wgbowley/OpenLSM/04_fixtures/readme.md

### 04_fixtures

#### [00_potting](./00_potting/) - Motor Potting

*(TBD) - Work in progress*

---

#### [01_validation_setup](./01_validation_setup/) - Validation / Experimental apparatus

*(TBD) - Work in progress*

<div align="center">
  Test-stand
</div>

---
