wgbowley/OpenLSM/03_boards/readme.md

### 03_boards

#### [01_armature_board](./01_armature_board) — Sensor Board (Manufacturing)

<div align="center">
  <table>
    <tr>
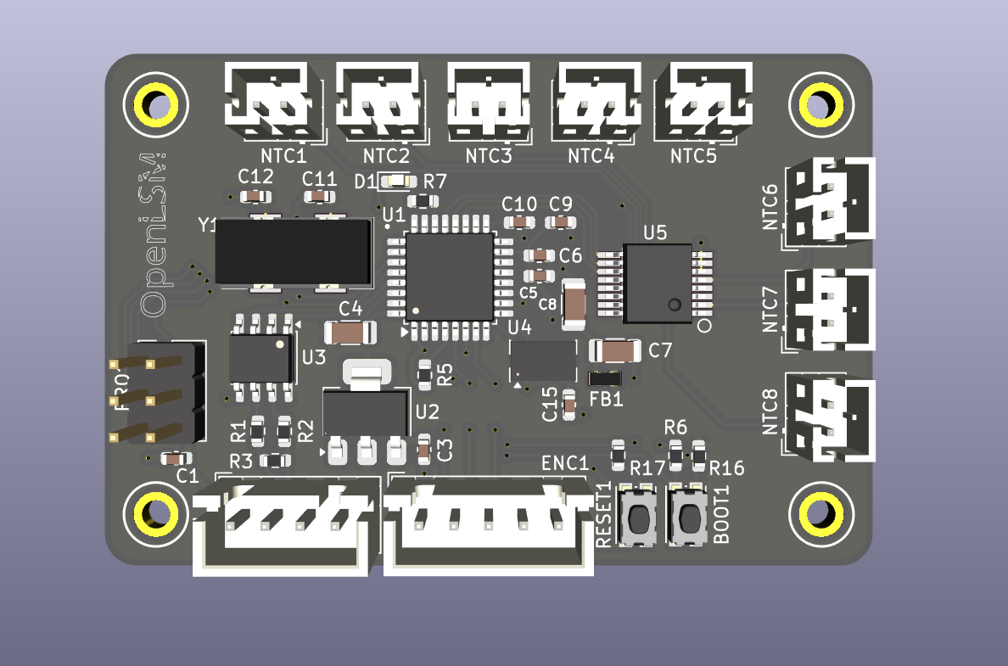
[picture p6: 03_boards/01_armature_board/05_media/kicad_top_layer.png]
Top layer
      <td></td>
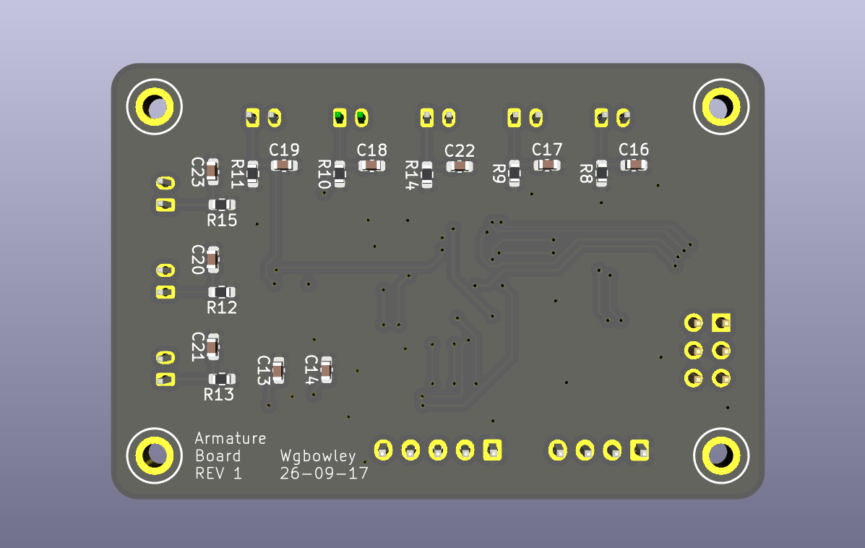
[picture p7: 03_boards/01_armature_board/05_media/kicad_bottom_layer.png]
Bottom layer
      <td></td>
    </tr>
    <tr>
      <td><em>Top layer — STM32, thermistor array, accelerometer & encoder</em></td>
      <td><em>Bottom layer — base resistors & decoupling capacitors for thermistors</em></td>
    </tr>
  </table>
</div>

A sensor board that connects to the driver over `RS-485/RS-422`. 
It features `8` NTC thermistors switched via an analog multiplexer to produce a thermal profile `T(z, t)`. 
The board also includes a `3-axis SPI accelerometer` and processes data from the encoder board.

---

#### [02_magnetic_encoder](./02_magnetic_encoder) — Linear Encoder Breakout (Validation)

<div align="center">
  <table>
    <tr>
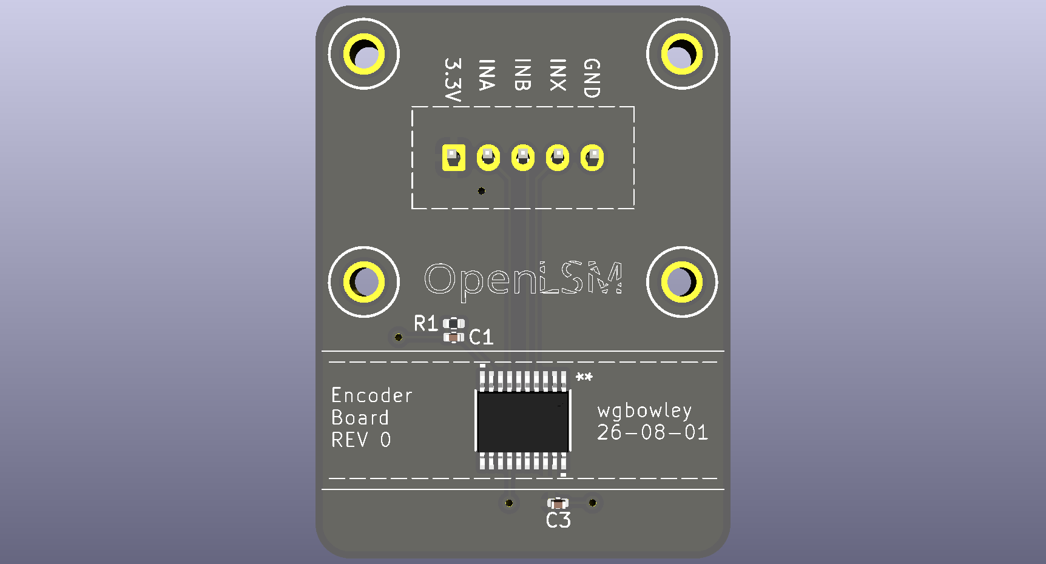
[picture p8: 03_boards/02_magnetic_encoder/05_media/kicad_top_layer.png]
Top layer
      <td></td>
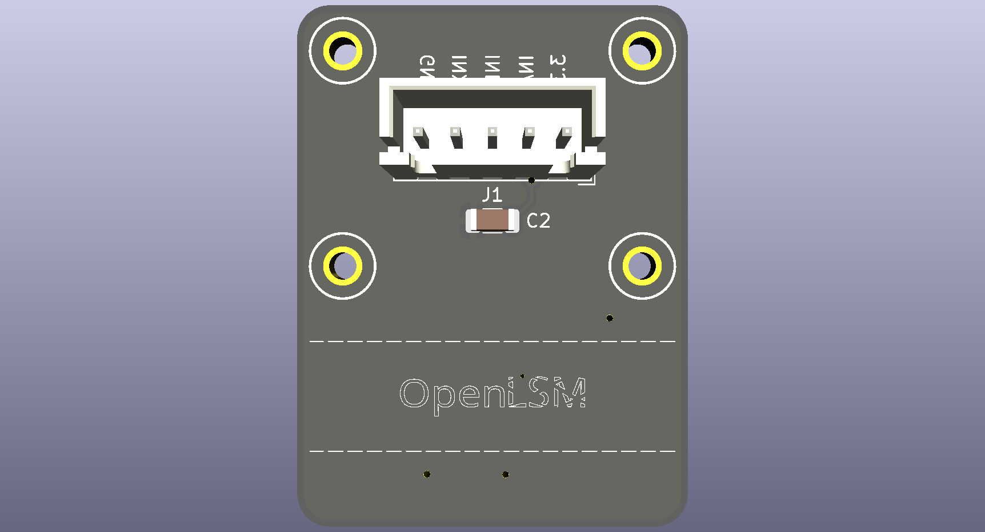
[picture p9: 03_boards/02_magnetic_encoder/05_media/kicad_bottom_layer.png]
Bottom layer
      <td></td>
    </tr>
    <tr>
      <td><em>Top layer — facing the magnetic scale</em></td>
      <td><em>Bottom layer — JST XH 5-pin & mounting side</em></td>
    </tr>
  </table>
</div>

A breakout and mechanical interface for the `AS5311` linear encoder, providing a resolution of `1.95 µm` and an estimated accuracy of `10–20 µm`, 
depending on mechanical implementation factors. The encoder operates from `0–600 mm/s` and is an incremental `A`, `B`, `Index` type.

---

#### [03_teensy_SFOC](./03_teensy_SFOC) - Teensy 4.1 & SimpleFOC Breakout Board (Manufacturing)

<div align="center">
  <table>
    <tr>
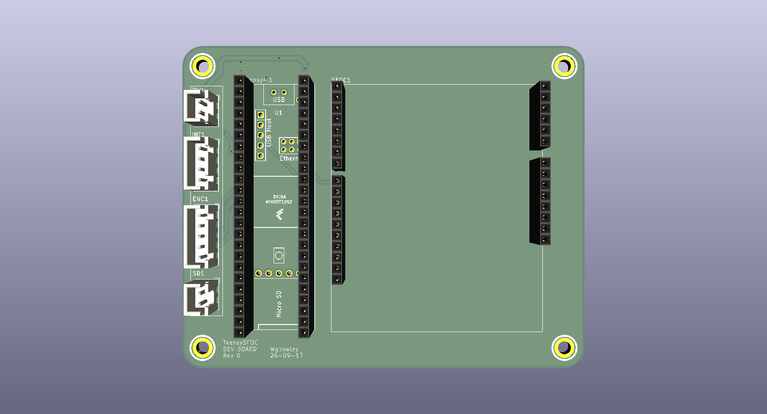
[picture p10: 03_boards/03_teensy_SFOC/05_media/kicad_top_layer.png]
Top layer
      <td></td>
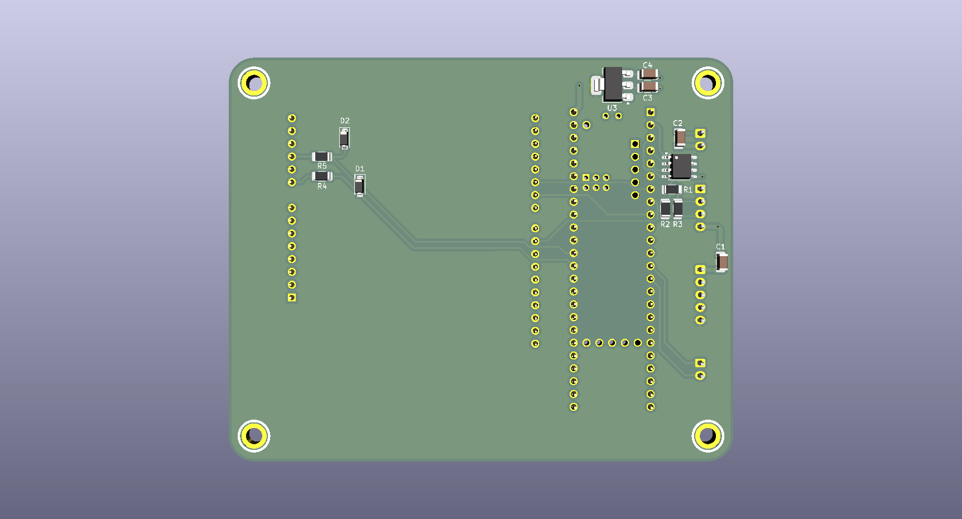
[picture p11: 03_boards/03_teensy_SFOC/05_media/kicad_bottom_layer.png]
Bottom layer
      <td></td>
    </tr>
    <tr>
      <td><em>Top layer — Teensy & SimpleFOC shield</em></td>
      <td><em>Bottom layer — Supporting electronics</em></td>
    </tr>
  </table>
</div>

The Teensy SFOC board is a breakout board for the Teensy 4.1 and SimpleFOC Arduino shield with `step/dir` input.

--- 

#### [00_bridge_driver](./00_bridge_driver) — Triple Half-Bridge Driver (WIP)

An isolated triple half-bridge driver with an MCU-side domain of `24 V (DC)` and a power domain of `12-96 V (RMS)`, 
with current up to `20 A (RMS)`. It supports `step/dir` and `CANBUS` input interfaces and uses `RS-485/RS-422` for 
communication with external input boards for encoders, Hall-effect sensors, etc. 

---
