wgbowley/OpenLSM/04_fixture/readme.md

### 04_fixture

*(TBD) — Work in progress*

---

#### [00_potting](./00_potting/) — Motor Potting

*(TBD) — Work in progress*

---

#### [01_validation_setup](./01_validation_setup/) — Validation / experimental apparatus

<div align="center">
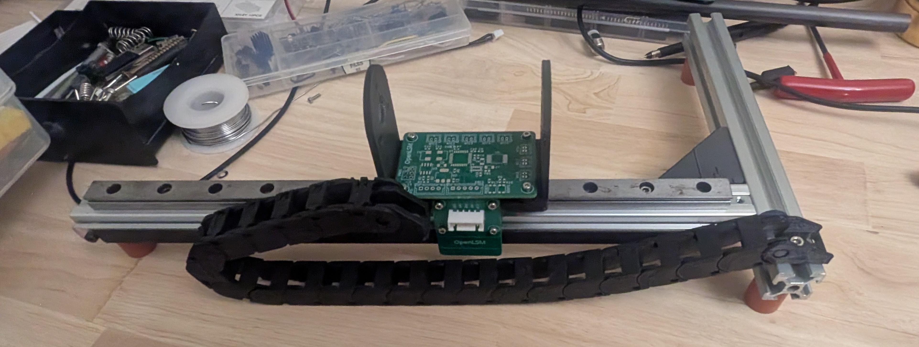
[picture p12: 05_media/04_fixtures/01_validation_setup/initial-integration.jpg]
Test-stand
  
</div>

*(TBD) — Work in progress*

---
