wgbowley/OpenLSM/03_boards/02_teensy_SFOC/readme.md

#### Overview

<div align="center">
  <table>
    <tr>
      <td>Top layer</td>
      <td>Bottom layer</td>
    </tr>
    <tr>
      <td><em>Top layer - Teensy & SimpleFOC shield</em></td>
      <td><em>Bottom layer - Supporting electronics</em></td>
    </tr>
  </table>
</div>

The Teensy SFOC board is a breakout board for the Teensy 4.1 and SimpleFOC Arduino shield, with `RS-485/RS-422` support and 
a secondary encoder input if `RS-485` to the armature board cannot be used. It also has a `step/dir` input for use with 
standard 3D printer main-boards.

> *(Note). This is a prototyping/dev board. It is not meant to be used long-term.*

---

### Documentation

> BOM can be found here [`BOM.md`](BOM.md)

Design notes and implementation decisions are documented in [`issue #42`](https://github.com/wgbowley/OpenLSM/issues/42).

---
