wgbowley/OpenLSM/02_motors/01_prototype_beta/rev_3/readme.md

### Overview

> It has not been manufactured, experimentally validated, or verified for performance.
> Do not assume the design is suitable for fabrication without further analysis.

This is Prototype Beta, Revision 3, which is intended to be built and validated using the boards designed
alongside it. This prototype is intended to serve to prove the thermal analysis studies before it (Rev 1 and Rev 2).

This prototype will most likely use an outer radial heat sink made of `aluminum`, with coils potted into that
heat sink and the final inner bore hole being machined out.

---

### Documentation

Reference: [`Defining constraints and success metrics for prototype beta rev 3`](https://github.com/wgbowley/OpenLSM/issues/5)

---
