wgbowley/OpenLSM/00_docs/credits.md

### Credits

#### Research & Development Enabled by:
- [Lawson Gallup](https://github.com/LawsonDG) - Thank you for the initial idea behind making a linear motor for 3D printers and your continued support.
- [SimpleFOC](https://simplefoc.com/) - Thank you to the SimpleFOC team for developing such a wonderful driver, specifically Runger, for the encoder help.

#### Prior Research & Inspiration
- [Scipython & Christian Hill](https://scipython.com/) - Annulus heat sink example using a modified bessel function.
- [Matthew Sorensen](https://sorens.in) - Research into the usage of the AS5311 for 3D printers.
- [cmore839](https://github.com/cmore839) - Research into tubular linear motors and the very informative Discord server.

#### Tooling Acknowledgements
- [PicoUnits](https://github.com/Bowley-Systems/PicoUnits)
- [UnitValues](https://github.com/Bowley-Systems/UnitValues)
- [Fusion 360](https://www.autodesk.com/products/fusion-360)
- [KiCad](https://github.com/KiCad)

---
