wgbowley/OpenLSM/00_docs/readme.md

### 00_docs

A credits list for tooling and individuals can be found here: [`credits.md`](./credits.md)

#### Contributors

Documentation for tooling used in the development of `OpenLSM` can be found here: [`CONTRIBUTORS.md`](./CONTRIBUTORS.md)

---

### Internal Resources

All internal documentation can be found within this repo's [`issues`](https://github.com/wgbowley/OpenLSM/issues).

#### Tags:

```
Project Progress:
----------------------------------------------------
LX -> Documentation and project structure
L0 -> Review and analysis of reference designs
L1 -> System level design, topology and interfaces
L2 -> Detailed design & prototyping
L3 -> Testing & validation of prototype
----------------------------------------------------
```

<br>

```
Miscellaneous:
----------------------------------------------------
DS  -> De-scoped feature, de-scoped analysis
AC  -> Architectural change
ES  -> Electrical systems
SD  -> System development / Architectural development
SIM -> Simulations & modelling
AN  -> Weekly application notes
----------------------------------------------------
```

#### Application Notes

```
0x1 = Week 1
0x2 = Week 2
0x3 = Week 3
0x4 = Week 4
0x5 = Week 5
0x6 = Week 6
0x7 = Week 7
0x8 = Week 8
0x9 = Week 9
0xA = Week 10
0xB = Week 11   
0xC = Week 12
0xD = Week 13
0xE = Week 14   <- Current State
0xF = Week 15   <- Terminal State
```

> Check [`here`](https://github.com/wgbowley/OpenLSM/issues?q=is%3Aissue%20label%3AAN) to view the weekly application notes.

---
