wgbowley/OpenLSM/01_simulation/01_hybrid/readme.md

### 01_mix_solution

*(TBD) — Work in progress*

> Do not assume the resulting design variables are suitable for fabrication or real-world use without further analysis.

---

### Mathematical Implementation
*(TBD) — Work in progress*

---

### Computational Implementation
*(TBD) — Work in progress*

---

### Model Validation
*(TBD) — Work in progress*

---

### Documentation

Reference: [`Build a reduced order model for tubular linear synchronous motors`](https://github.com/wgbowley/OpenLSM/issues/7)<br>
Reduced Order Modelling tool: [`ifemm`](https://github.com/wgbowley/iFEMM)

---
