wgbowley/OpenLSM/02_motors/01_prototype_beta/rev_3/02_detailed_design/00_magnetic_search/01_run_300um_wire_6_slots/trace.csv

Iteration | step_size (m) | Axial Length (m) | Radial Thickness (m) | Absolute Force (N) | Force per Ampere (N/A) | Force slew rate (N/s) | Copper Loss (W) | Normalized Score
0 | 0.0015 | 0.0031386694733534256 | 0.004339691260599416 | 12.279448708577325 | 2.921504470982113 | 82422.61408032292 | 173.74766222075564 | -5.713602476207521
4 | 0.0015 | 0.0029586609645756317 | 0.005315846270833498 | 15.193571835821237 | 4.466436942260786 | 59165.65756771232 | 139.05423621348748 | -4.1011602443293125
5 | 0.0015 | 0.0031646001191442037 | 0.005453661729053428 | 15.45968901656606 | 5.034182417412318 | 56337.17448141091 | 125.22852624422066 | -3.4209078403457984
8 | 0.0015 | 0.0020134186450666046 | 0.00566582707880046 | 16.363737141967125 | 3.5656969173057034 | 54192.27013770524 | 186.36724351262515 | -6.47928649477025
9 | 0.0015 | 0.002843345400056729 | 0.005836235768687598 | 16.462998709250023 | 5.323586764631645 | 50222.93783381328 | 125.0476007834111 | -3.424168519414899
11 | 0.0015 | 0.0021361572980415737 | 0.004629515371620264 | 13.48283631367632 | 2.366350253332019 | 76193.7302292795 | 234.9875003519359 | -8.798338439865837
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
