wgbowley/OpenLSM/02_motors/01_prototype_beta/rev_3/02_detailed_design/00_magnetic_search/02_run_200um_wire_6_slots/trace.csv

Iteration | step_size (m) | Axial Length (m) | Radial Thickness (m) | Absolute Force (N) | Force per Ampere (N/A) | Force slew rate (N/s) | Copper Loss (W) | Normalized Score
1 | 0.0015 | 0.002219240695167407 | 0.004828848955807065 | 6.2531203189048465 | 6.140439610919466 | 31360.590046137986 | 41.90883660349558 | -0.6382366769975523
2 | 0.0015 | 0.0015881907651128999 | 0.004583356854705778 | 5.977535938588337 | 3.930790857870361 | 34419.67295836757 | 62.73530631533942 | -1.7195919008117742
3 | 0.0015 | 0.003137620603877833 | 0.0043852653479235035 | 5.5222985762548324 | 6.771007821967774 | 35862.50697063138 | 33.70129491684939 | -0.1898844880720998
5 | 0.0015 | 0.0023031508561898242 | 0.004406781077995912 | 5.658670740159545 | 5.13155288698707 | 36218.70127947442 | 45.55843929250885 | -0.8166291021204308
7 | 0.0015 | 0.002600828388159864 | 0.004425219110757882 | 5.650894948680679 | 5.811638187960793 | 35799.93893520866 | 40.16670843960899 | -0.533525875476182
11 | 0.0015 | 0.002315026460310334 | 0.004849306284403274 | 6.268549361640366 | 6.47523608357132 | 31002.29382706246 | 39.82859048696162 | -0.5286875088570846
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
