wgbowley/OpenLSM/02_motors/01_prototype_beta/rev_3/02_detailed_design/00_magnetic_search/03_run_400um_wire_12_slots/trace.csv

Iteration | step_size (m) | Axial Length (m) | Radial Thickness (m) | Absolute Force (N) | Force per Ampere (N/A) | Force slew rate (N/s) | Copper Loss (W) | Normalized Score
0 | 0.0015 | 0.0027066464489963337 | 0.005597720254361694 | 28.412157144821997 | 5.19802720574761 | 96712.0610186584 | 222.25473483913382 | -7.1311328437629875
1 | 0.0015 | 0.0016054447689461198 | 0.005822669286339892 | 29.890297909216724 | 3.4442478392607776 | 91670.6567169225 | 351.0241194196191 | -13.530661351581365
2 | 0.0015 | 0.002102926336043487 | 0.005942902954008838 | 30.12809908379458 | 4.6482959624315425 | 88351.49194772764 | 261.4762498984186 | -9.022544468316477
3 | 0.0015 | 0.0028193282309151553 | 0.00589134261064581 | 29.496030854877752 | 6.044217179447239 | 88160.28801468521 | 197.09626434166688 | -5.822133345467142
4 | 0.0015 | 0.002310413343650763 | 0.005080169659342831 | 26.263215684669444 | 3.5824336629144895 | 115365.56806514875 | 300.77106223699633 | -11.139161407300902
6 | 0.0015 | 0.0015163710564300638 | 0.00720902975458605 | 33.59241112921587 | 5.049076421782576 | 62194.618361743305 | 255.58530749332536 | -8.629775530734495
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
