wgbowley/OpenLSM/02_motors/01_prototype_beta/rev_3/02_detailed_design/00_magnetic_search/07_run_400um_wire_18_slots/trace.csv

Iteration | step_size (m) | Axial Length (m) | Radial Thickness (m) | Absolute Force (N) | Force per Ampere (N/A) | Force slew rate (N/s) | Copper Loss (W) | Normalized Score
0 | 0.0015 | 0.0015036831160120884 | 0.004359672048773853 | 22.64909464271964 | 2.4459310826022667 | 151282.3109376802 | 382.7623766286552 | -15.278855221697253
1 | 0.0015 | 0.0007809768122156805 | 0.004288566379278116 | 22.384800746793154 | 1.2028992598587602 | 159734.36826091498 | 769.7530205367551 | -34.611730627553996
2 | 0.0015 | 8.160852887947249e-05 | 0.004768727497911051 | 25.231457899317995 | 0.15531985040937726 | 141187.99274804033 | 6698.677200496042 | -330.99365697904295
3 | 0.0015 | 0.0005903491674868071 | 0.005064626182989945 | 26.753721790297096 | 1.34486419082708 | 122504.73710565863 | 817.0196075048677 | -36.905732018796186
4 | 0.0015 | 0.0018857544071902855 | 0.004967832817291968 | 25.884587750735342 | 4.204583104583407 | 120383.70225347692 | 252.93424306084617 | -8.714263585281225
5 | 0.0015 | 0.001982684185024087 | 0.005148388706729897 | 26.76221505403833 | 4.738755209338354 | 114524.75197739914 | 231.5333879184183 | -7.597241863765145
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
