wgbowley/OpenLSM/02_motors/01_prototype_beta/rev_3/02_detailed_design/00_magnetic_search/09_run_18_slots/trace.csv

Iteration | step_size (m) | Wire diameter (m) | Radial Thickness (m) | Absolute Force (N) | Force per Ampere (N/A) | Force slew rate (N/s) | Copper Loss (W) | Normalized Score
0 | 0.0015 | 0.000429250335309005 | 0.004843479786120419 | 27.92792697357624 | 7.952657560526482 | 103837.51093504643 | 143.31523132972404 | -1.449242028001673
1 | 0.0015 | 0.0004203299797048553 | 0.005828795390446022 | 31.182176625814265 | 12.76953706664972 | 71754.61169006242 | 96.59350797141627 | -0.7428830629364371
2 | 0.0015 | 0.0002869858357668495 | 0.004810272410225731 | 12.396310414169388 | 17.634265464122855 | 46603.429257564414 | 28.69984710863167 | 0.23642877284624042
3 | 0.0015 | 0.00034907689680906053 | 0.003532516952822636 | 12.832690156290374 | 5.570865606183752 | 112040.17070140073 | 95.44138953654756 | -0.5904633620767432
4 | 0.0015 | 0.0002809134079046521 | 0.005207447723484311 | 12.782976642058106 | 22.17281796488547 | 39025.03927797235 | 23.313094606590553 | 0.3289784916295618
5 | 0.0015 | 0.0003955063154559475 | 0.004460929036169256 | 21.780965037025883 | 7.710944028757729 | 100689.17608157013 | 116.0369846086831 | -0.9996514806282302
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
