wgbowley/OpenLSM/02_motors/01_prototype_beta/rev_3/02_detailed_design/00_magnetic_search/01_run_300um_wire_6_slots/tradeoffs.png

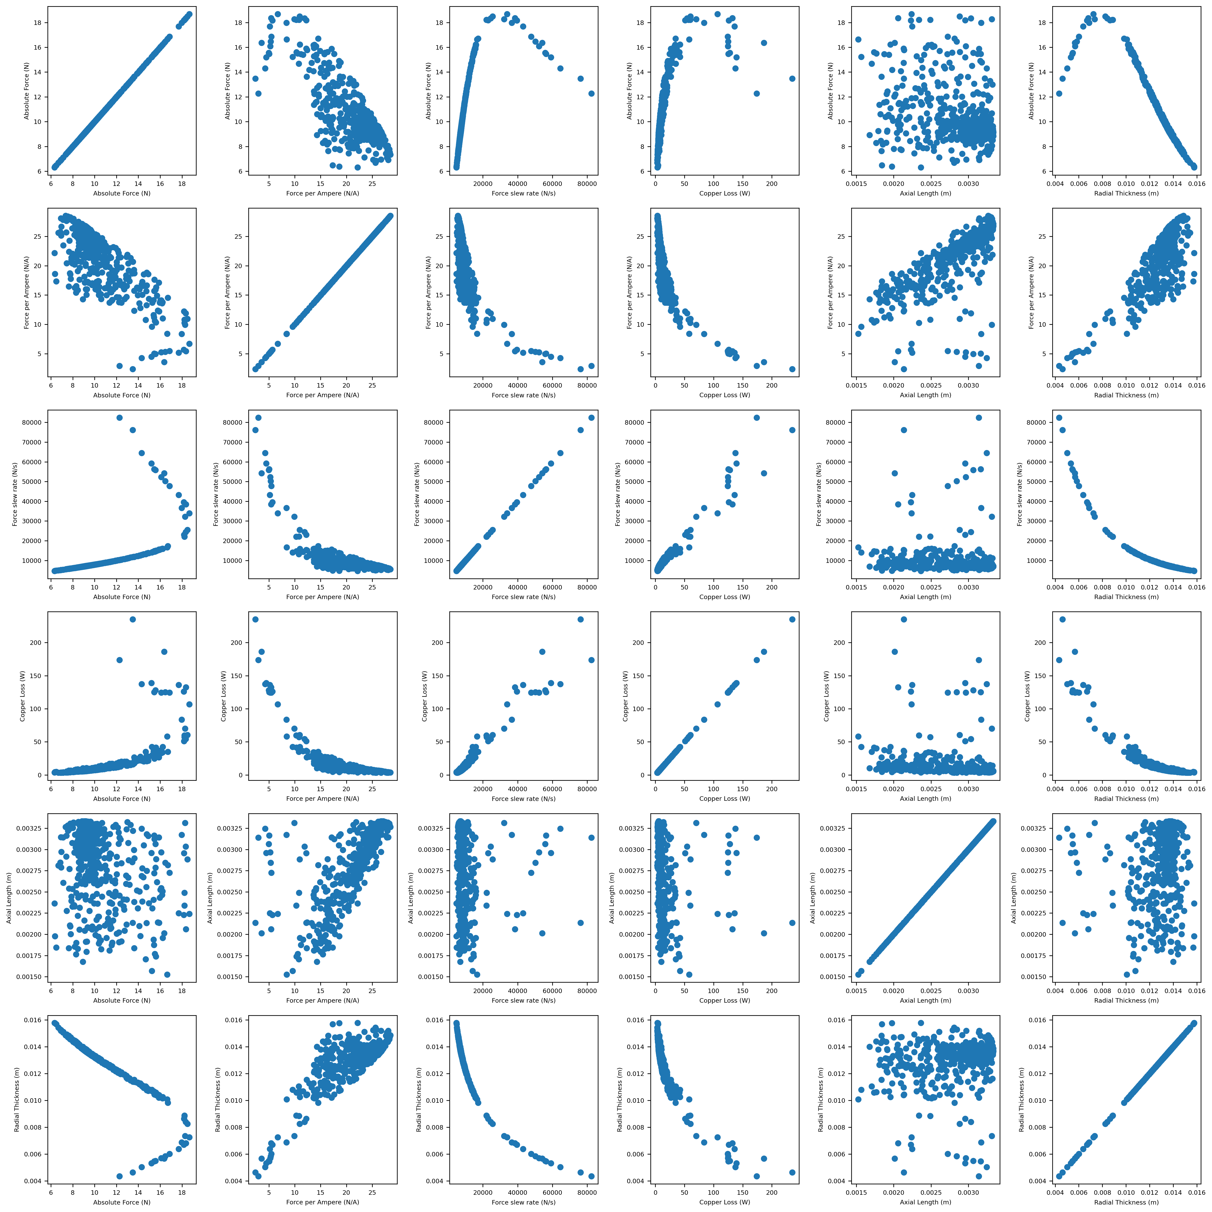
02_motors/01_prototype_beta/rev_3/02_detailed_design/00_magnetic_search/01_run_300um_wire_6_slots/tradeoffs.png
