wgbowley/OpenLSM/02_motors/01_prototype_beta/rev_3/02_detailed_design/00_magnetic_search/06_run_500um_wire_12_slots/tradeoffs.png

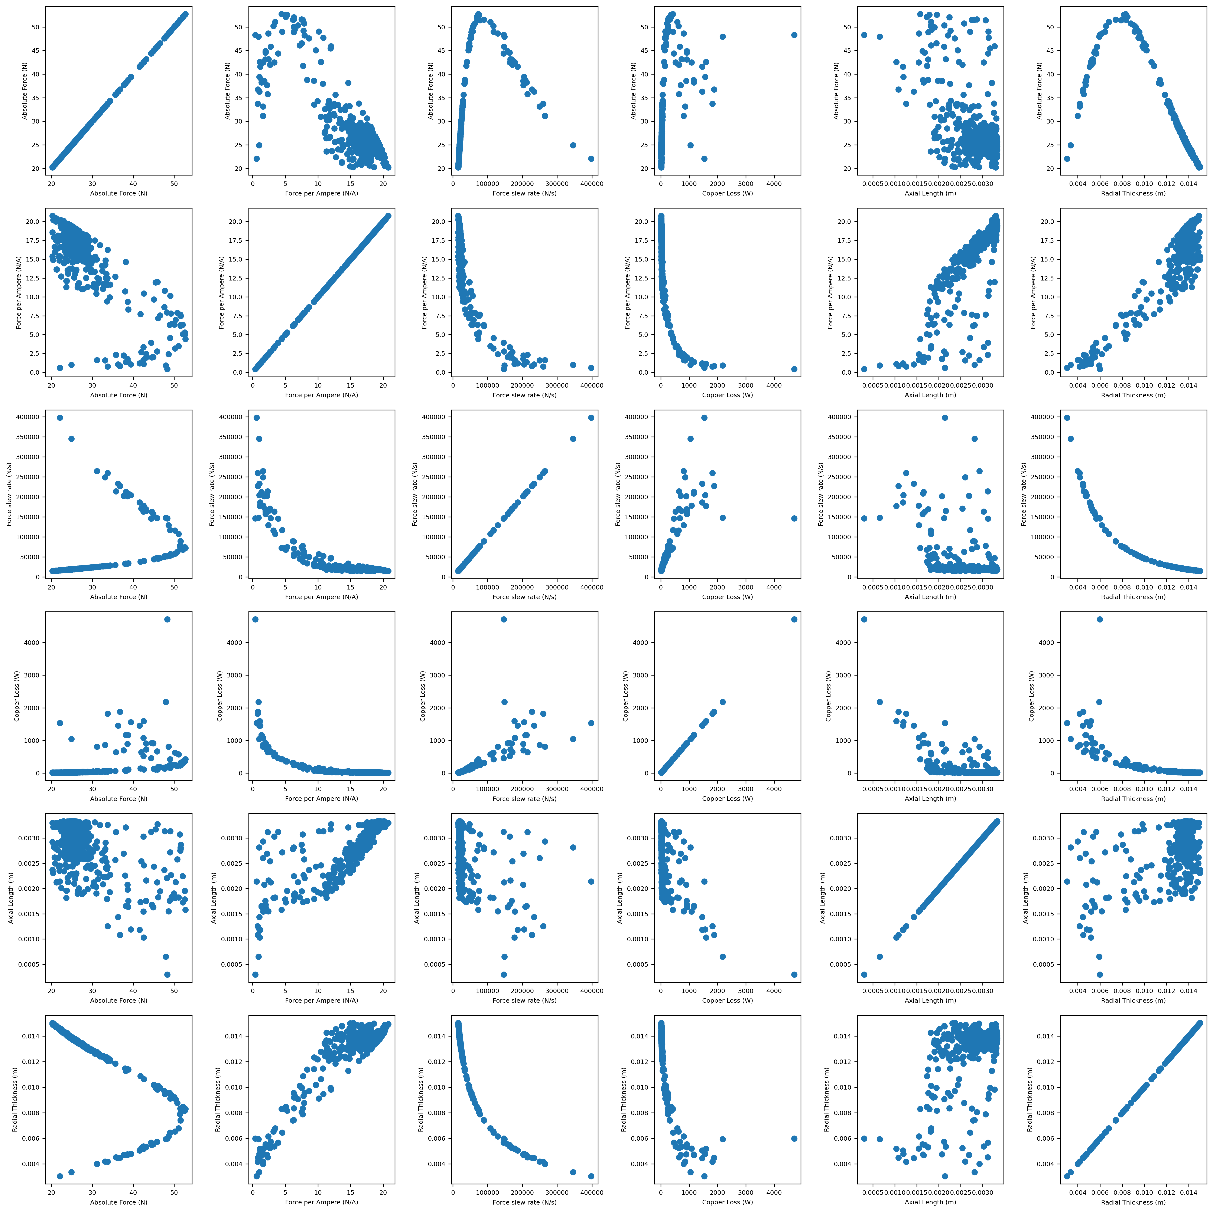
02_motors/01_prototype_beta/rev_3/02_detailed_design/00_magnetic_search/06_run_500um_wire_12_slots/tradeoffs.png
