wgbowley/OpenLSM/02_motors/01_prototype_beta/rev_3/02_detailed_design/00_magnetic_search/07_run_400um_wire_18_slots/tradeoffs.png

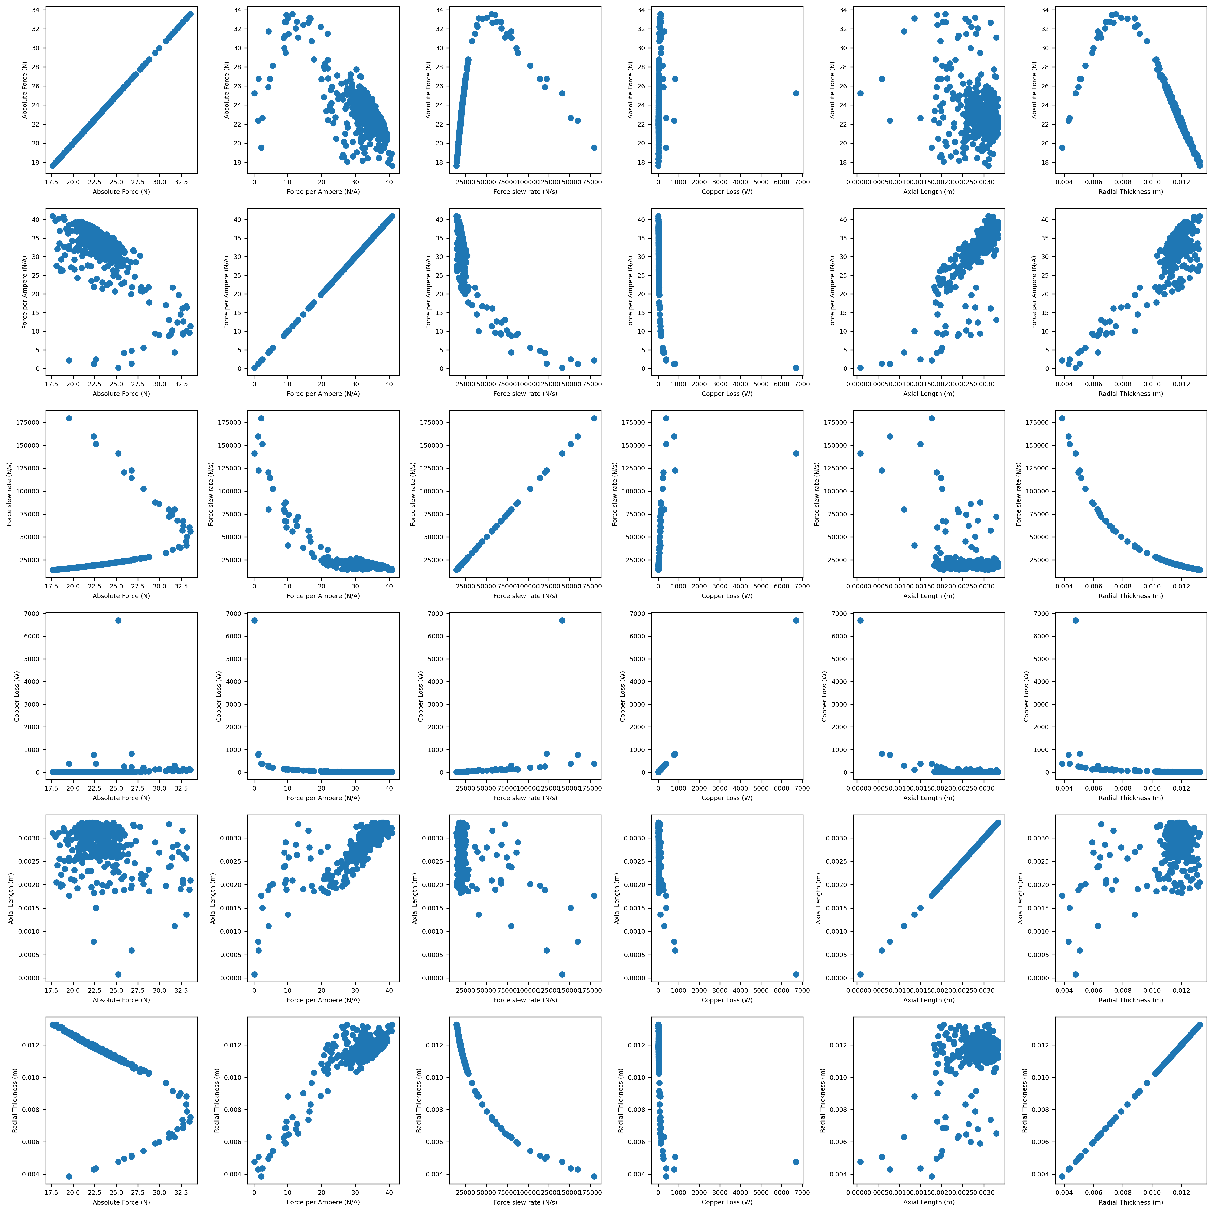
02_motors/01_prototype_beta/rev_3/02_detailed_design/00_magnetic_search/07_run_400um_wire_18_slots/tradeoffs.png
