wgbowley/OpenLSM/03_boards/02_magnetic_encoder/05_media/bare_pcb_back.jpg

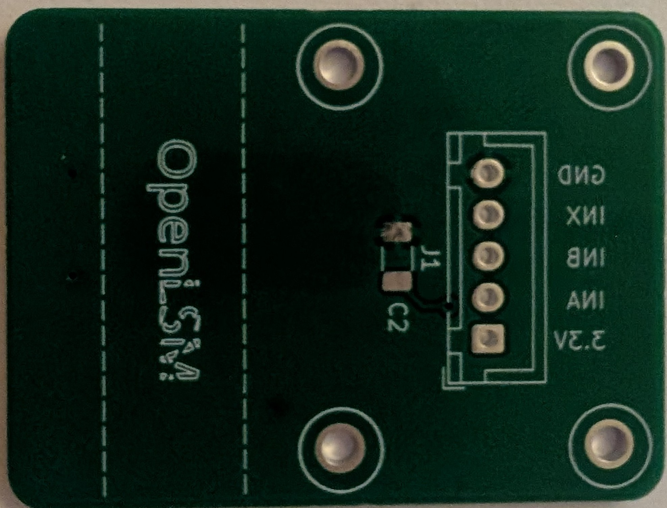
03_boards/02_magnetic_encoder/05_media/bare_pcb_back.jpg
