wgbowley/OpenLSM/03_boards/02_magnetic_encoder/05_media/bare_pcb_top.jpg

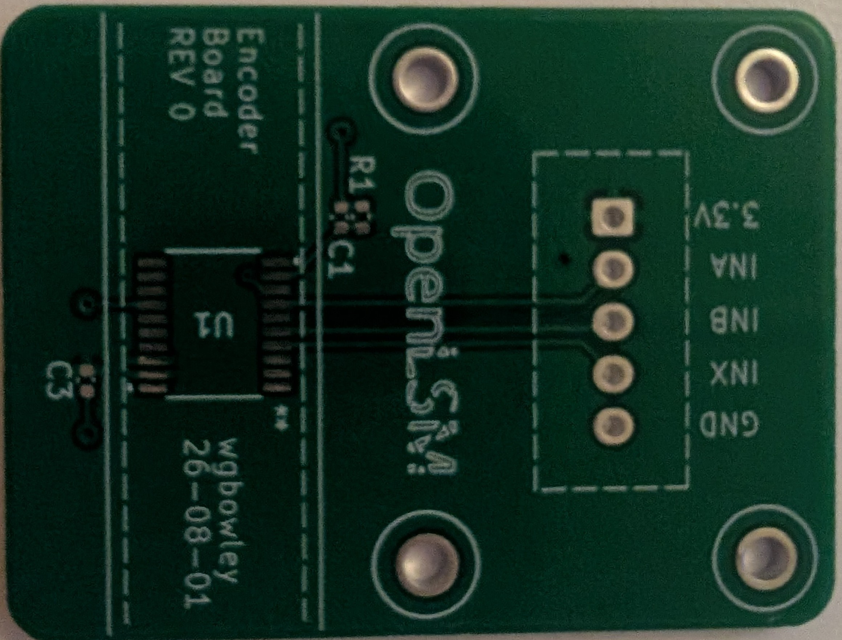
03_boards/02_magnetic_encoder/05_media/bare_pcb_top.jpg
