wgbowley/OpenLSM/03_boards/03_teensy_SFOC/00_references/simplefoc_driver_board.jpg

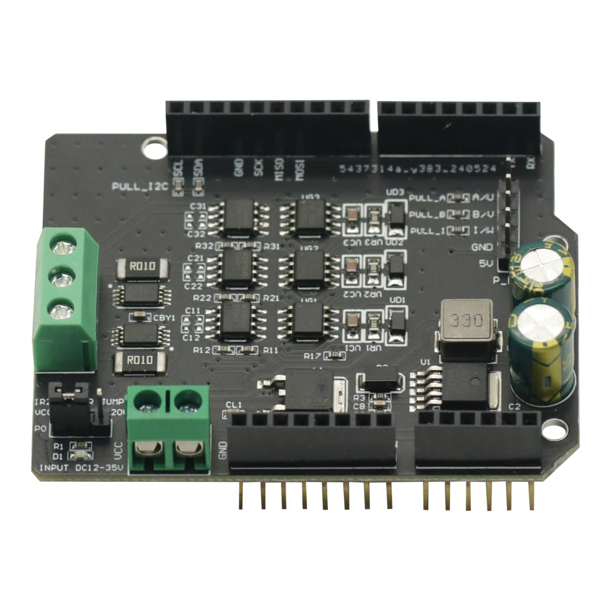
03_boards/03_teensy_SFOC/00_references/simplefoc_driver_board.jpg
