wgbowley/OpenLSM/03_boards/03_teensy_SFOC/00_references/teensy4_1_pinout.jpg

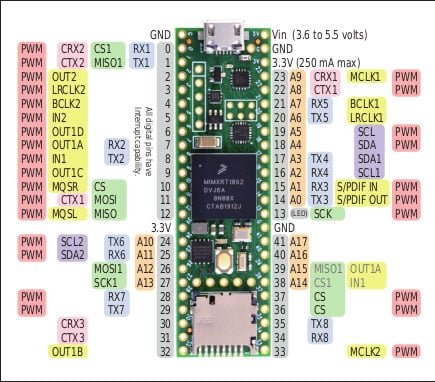
03_boards/03_teensy_SFOC/00_references/teensy4_1_pinout.jpg
