wgbowley/OpenLSM/03_boards/03_teensy_SFOC/05_media/top-side.jpg

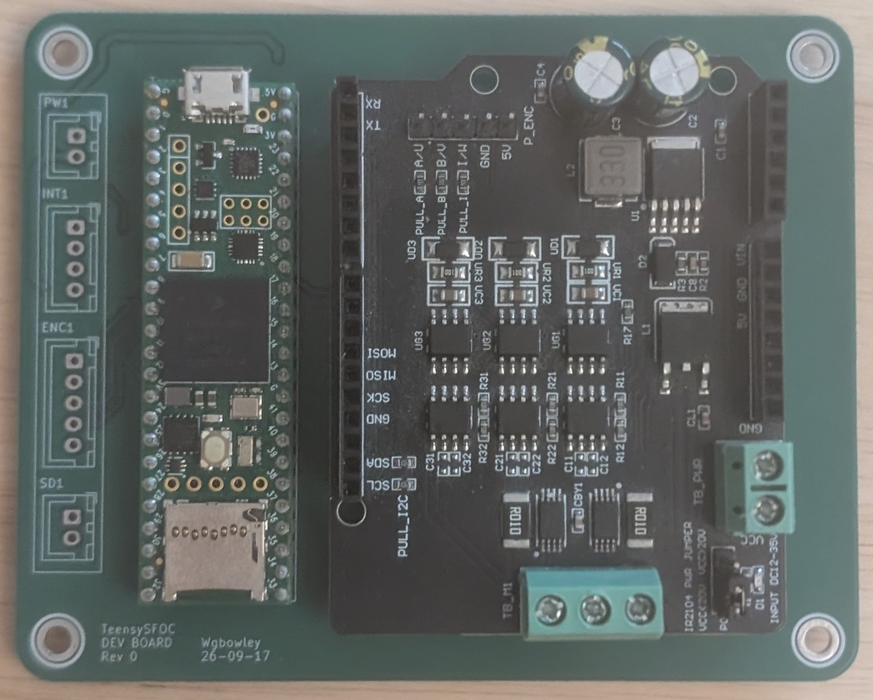
03_boards/03_teensy_SFOC/05_media/top-side.jpg
