wgbowley/OpenLSM/05_media/00_simulation/00_analytical/example.png

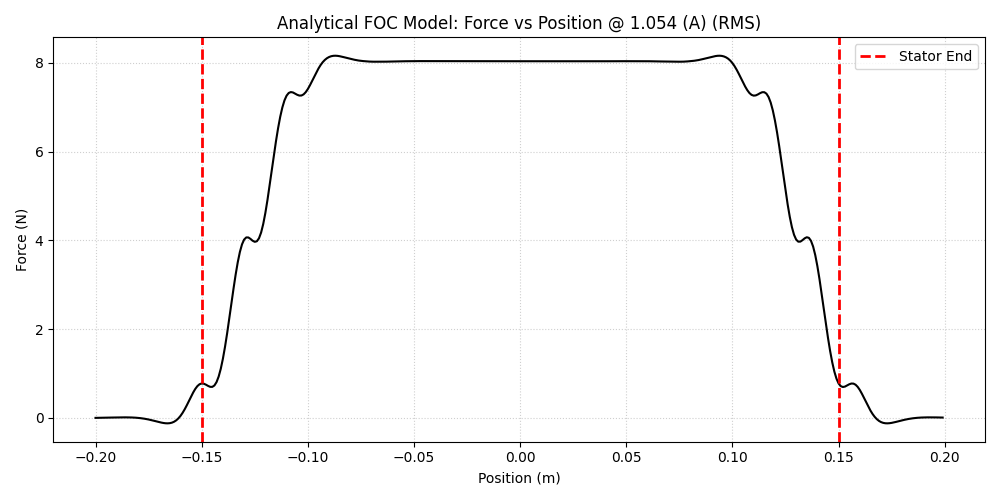
05_media/00_simulation/00_analytical/example.png
