wgbowley/OpenLSM/05_media/02_prototype_alpha/01_cad/side_profile.png

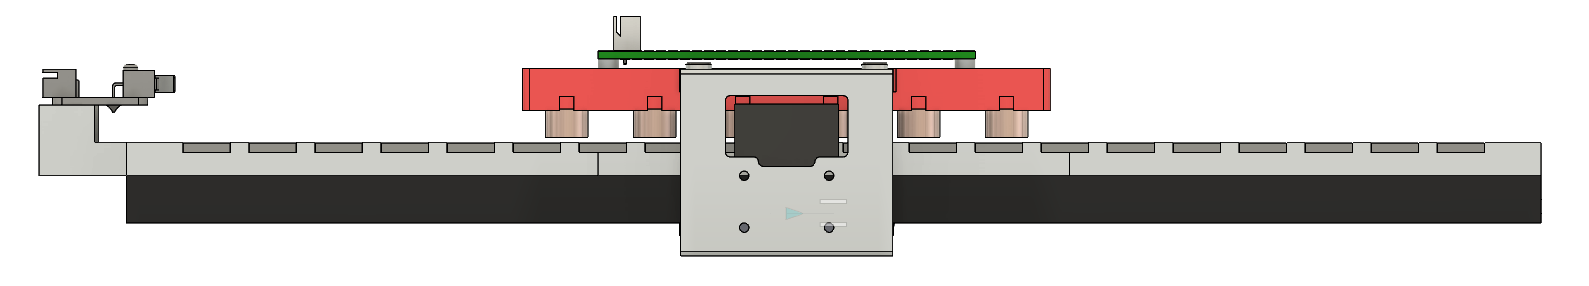
05_media/02_prototype_alpha/01_cad/side_profile.png
