wgbowley/OpenLSM/05_media/02_prototype_alpha/01_cad/top_profile.png

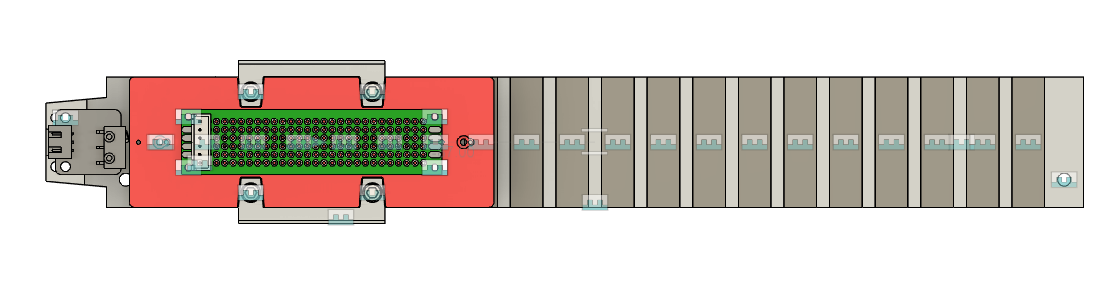
05_media/02_prototype_alpha/01_cad/top_profile.png
