wgbowley/OpenLSM/05_media/03_prototype_beta/rev_3/grid_search_heat_sinks.png

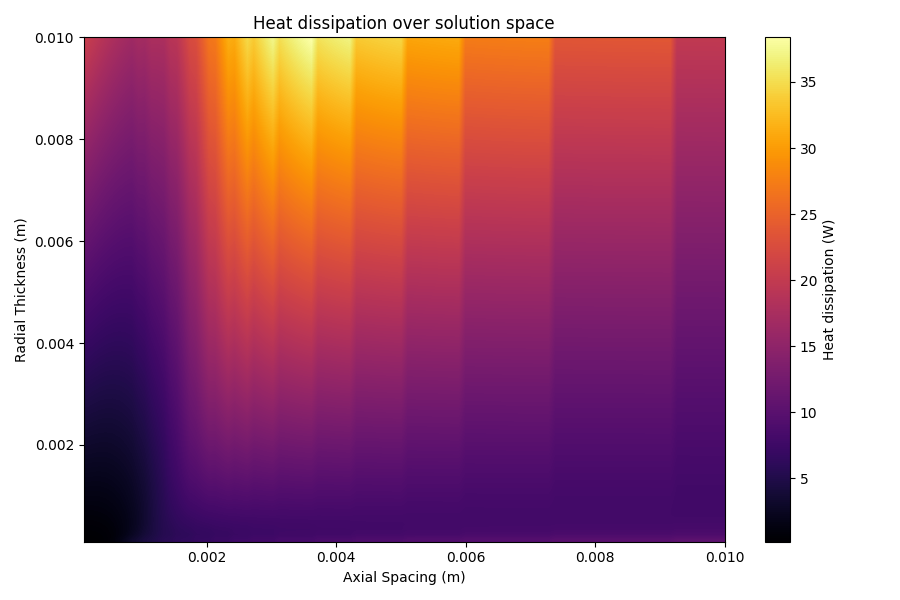
05_media/03_prototype_beta/rev_3/grid_search_heat_sinks.png
