wgbowley/OpenLSM/05_media/03_prototype_beta/rev_3/initial_thermal_concept_design_with_force_cooling.png

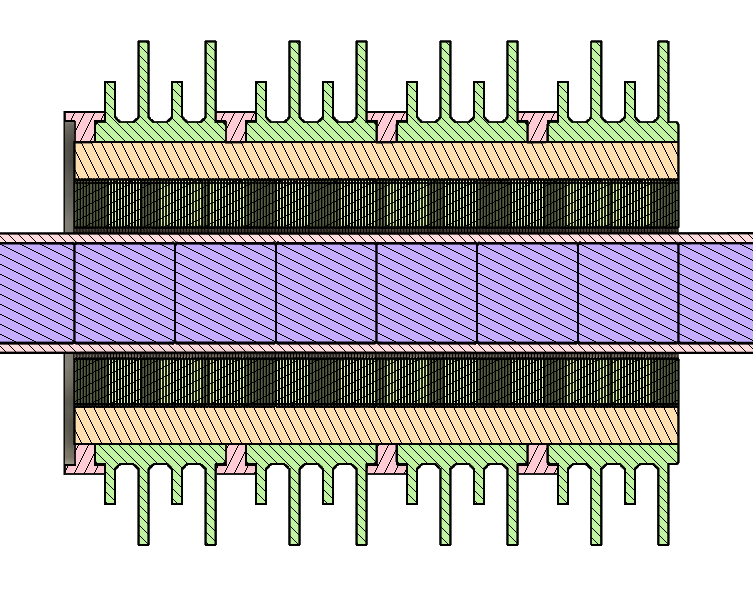
05_media/03_prototype_beta/rev_3/initial_thermal_concept_design_with_force_cooling.png
