wgbowley/OpenLSM/05_media/03_prototype_beta/rev_3/interface_board.png

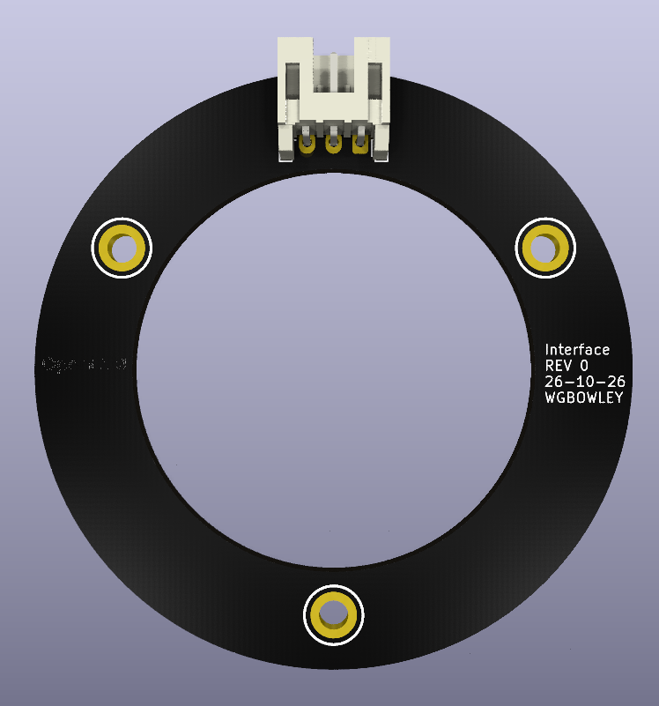
05_media/03_prototype_beta/rev_3/interface_board.png
