wgbowley/OpenLSM/05_media/03_prototype_beta/rev_3/motor_design_in_cad.png

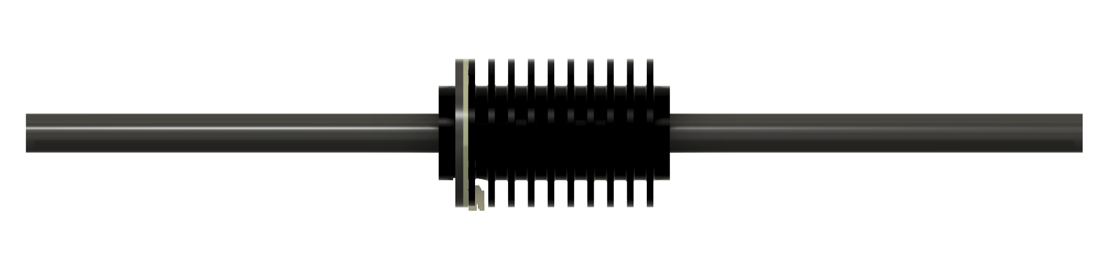
05_media/03_prototype_beta/rev_3/motor_design_in_cad.png
