wgbowley/OpenLSM/05_media/04_fixtures/00_potting/potting_fixture_with_conceptual_beta_rev_3_design.png

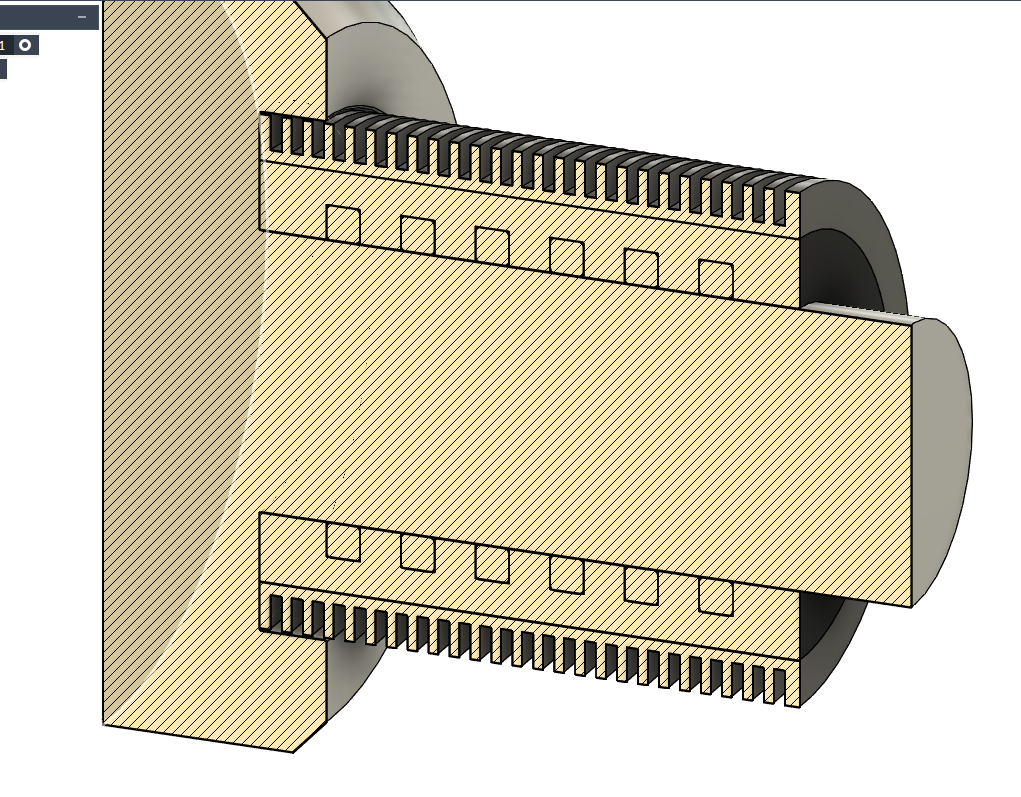
05_media/04_fixtures/00_potting/potting_fixture_with_conceptual_beta_rev_3_design.png
