wgbowley/OpenLSM/05_media/04_fixtures/01_validation_setup/conceptual_whole_profile.png

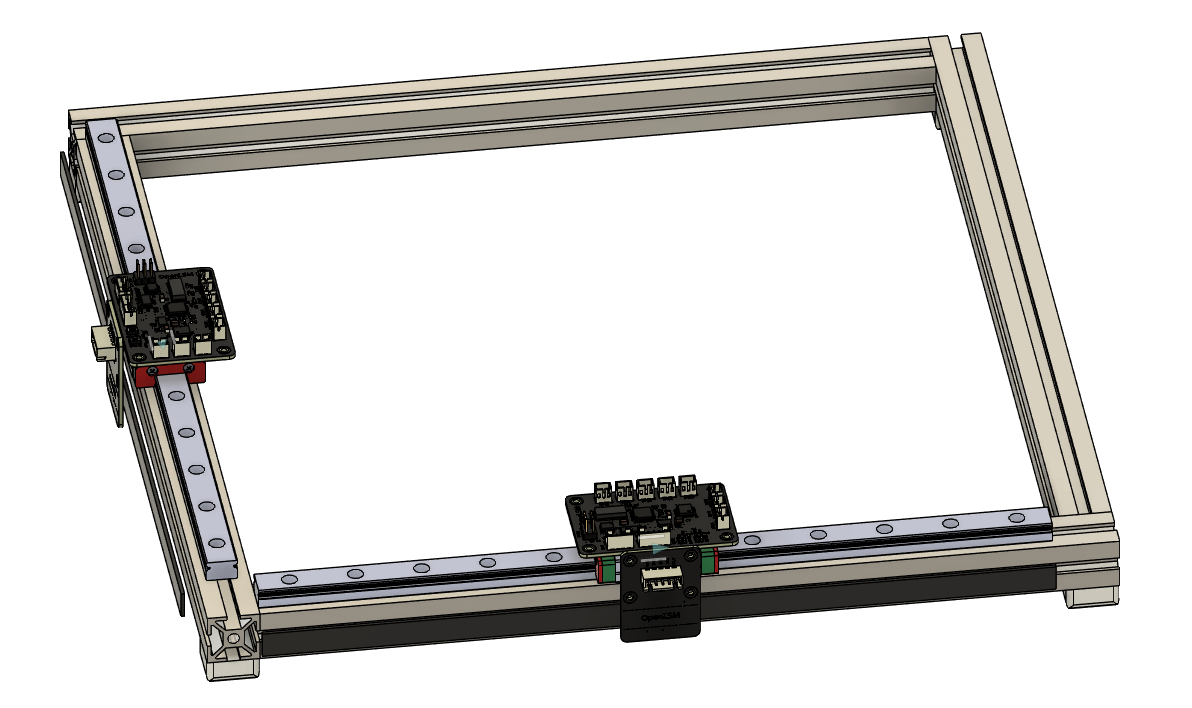
05_media/04_fixtures/01_validation_setup/conceptual_whole_profile.png
