wgbowley/OpenLSM/05_media/05_miscellaneous/bare_top_armature_and_encoder_boards.jpg

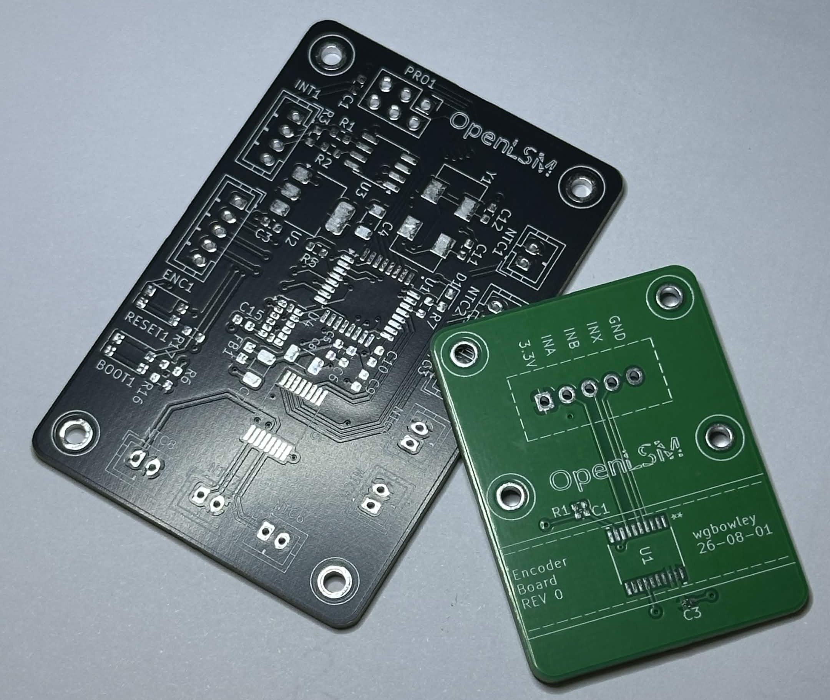
05_media/05_miscellaneous/bare_top_armature_and_encoder_boards.jpg
