wgbowley/OpenLSM/06_dropped/01_hybrid/media/FEMM_solution.png

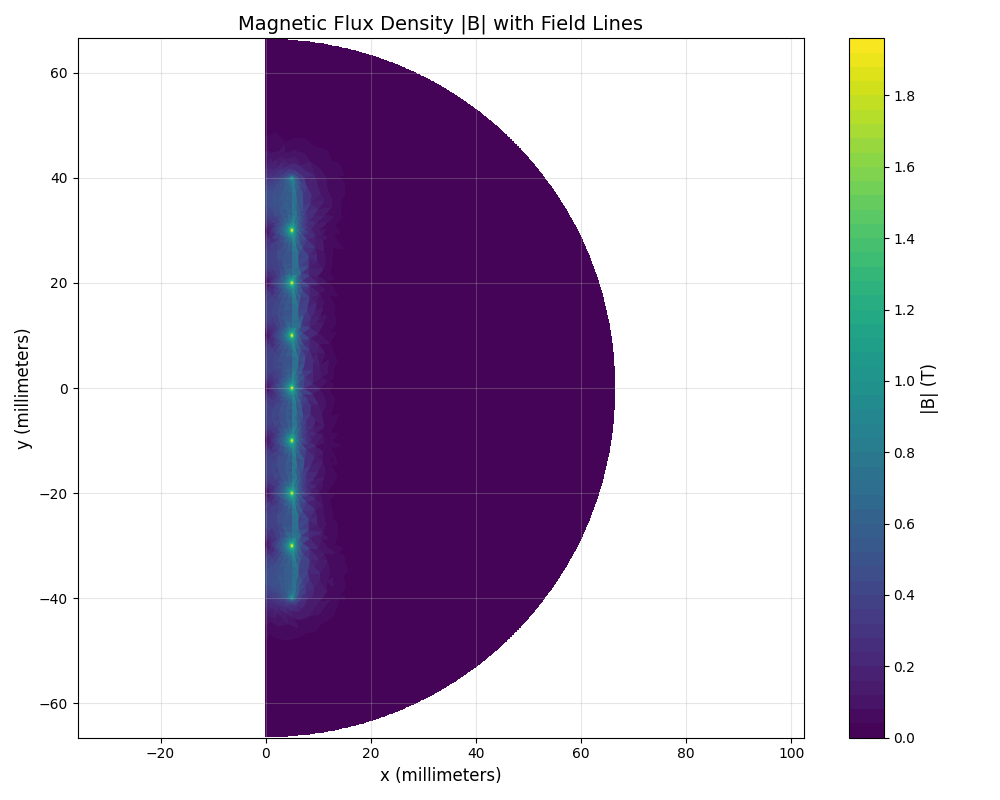
06_dropped/01_hybrid/media/FEMM_solution.png
