wgbowley/OpenLSM/03_boards/00_armature_board/04_procurement/back_order_digikey.csv

Index | Quantity | Part Number | Manufacturer Part Number | Description | Unit of Measure | Customer Reference | Available | Backorder | Unit Price | Extended Price AUD
1 | 4 | 108-KMR211GLFSCT-ND | KMR211G LFS | SWITCH TACTILE SPST-NO 0.05A 32V |  |  | 4 | 0 | 0.98000 | AU$3.92
2 | 12 | 720-VJ0603Y104MXJAPCT-ND | VJ0603Y104MXJAP | CAP CER 0.1UF 16V X7R 0603 |  |  | 12 | 0 | 0.27700 | AU$3.32
3 | 18 | 399-C0603C103K4RECTUCT-ND | C0603C103K4RECTU | CAP CER 0603 10NF 16V X7R 10% |  |  | 18 | 0 | 0.11500 | AU$2.07
4 | 4 | 399-C0603C331J5GACTUCT-ND | C0603C331J5GACTU | CAP CER 330PF 50V C0G/NP0 0603 |  |  | 4 | 0 | 0.19000 | AU$0.76
5 | 2 | 160-1446-1-ND | LTST-C191KGKT | LED GREEN CLEAR SMD |  |  | 2 | 0 | 0.22000 | AU$0.44
6 | 2 | 490-1014-1-ND | BLM18AG601SN1D | FERRITE BEAD 600 OHM 0603 1LN |  |  | 2 | 0 | 0.19000 | AU$0.38
7 | 16 | 2019-RN73H1JTTD1801B25CT-ND | RN73H1JTTD1801B25 | RES 1.8K OHM 0.1% 1/10W 0603 |  |  | 16 | 0 | 0.24000 | AU$3.84
8 | 2 | 497-1241-1-ND | LD1117S33CTR | IC REG LINEAR 3.3V 800MA SOT-223 |  |  | 2 | 0 | 0.58000 | AU$1.16
9 | 2 | MAX3485CSA+CT-ND | MAX3485CSA+T | IC TXRX 8-SOIC |  |  | 2 | 0 | 10.45000 | AU$20.90
10 | 2 | 497-STM32G431K6T6-ND | STM32G431K6T6 | IC MCU 32BIT 32KB FLASH 32LQFP |  |  | 2 | 0 | 7.98000 | AU$15.96
11 | 2 | 505-ADXL343BCCZ-RLCT-ND | ADXL343BCCZ-RL | ACCEL 2-16G I2C/SPI 14LGA |  |  | 2 | 0 | 5.85000 | AU$11.70
12 | 2 | 296-13031-1-ND | CD74HC4051PWR | IC MUX 8:1 130OHM 16TSSOP |  |  | 2 | 0 | 0.86000 | AU$1.72
13 | 2 | XC1007CT-ND | ECS-80-20-18-TR | CRYSTAL 8.0000MHZ 20PF SMD |  |  | 2 | 0 | 2.91000 | AU$5.82
14 | 25 | RMCF0603FT10R0CT-ND | RMCF0603FT10R0 | RES 10 OHM 1% 1/10W 0603 |  |  | 25 | 0 | 0.02200 | AU$0.55
15 | 25 | 311-220HRCT-ND | RC0603FR-07220RL | RES 220 OHM 1% 1/10W 0603 |  |  | 25 | 0 | 0.02720 | AU$0.68
16 | 10 | 311-120GRCT-ND | RC0603JR-07120RL | RES 120 OHM 5% 1/10W 0603 |  |  | 10 | 0 | 0.03300 | AU$0.33
17 | 4 | 399-C0603C105K8RACTUCT-ND | C0603C105K8RACTU | CAP CER 1UF 10V X7R 0603 |  |  | 4 | 0 | 0.19000 | AU$0.76
18 | 4 | 587-1342-1-ND | LMK316BJ106KL-T | CAP CER 10UF 10V X5R 1206 |  |  | 4 | 0 | 0.45000 | AU$1.80
19 | 2 | 587-3246-1-ND | TMK316BBJ226ML-T | CAP CER 22UF 25V X5R 1206 |  |  | 2 | 0 | 0.66000 | AU$1.32
20 | 10 | 541-10.0KHCT-ND | CRCW060310K0FKEA | RES SMD 10K OHM 1% 1/10W 0603 |  |  | 10 | 0 | 0.04700 | AU$0.47
