wgbowley/OpenLSM/03_boards/02_magnetic_encoder/03_kicad/02_components/readme.md

# I am a placeholder created by william bowley to be a placeholder :0
