wgbowley/OpenLSM/04_fixtures/01_validation_setup/04_mechanical/main.step

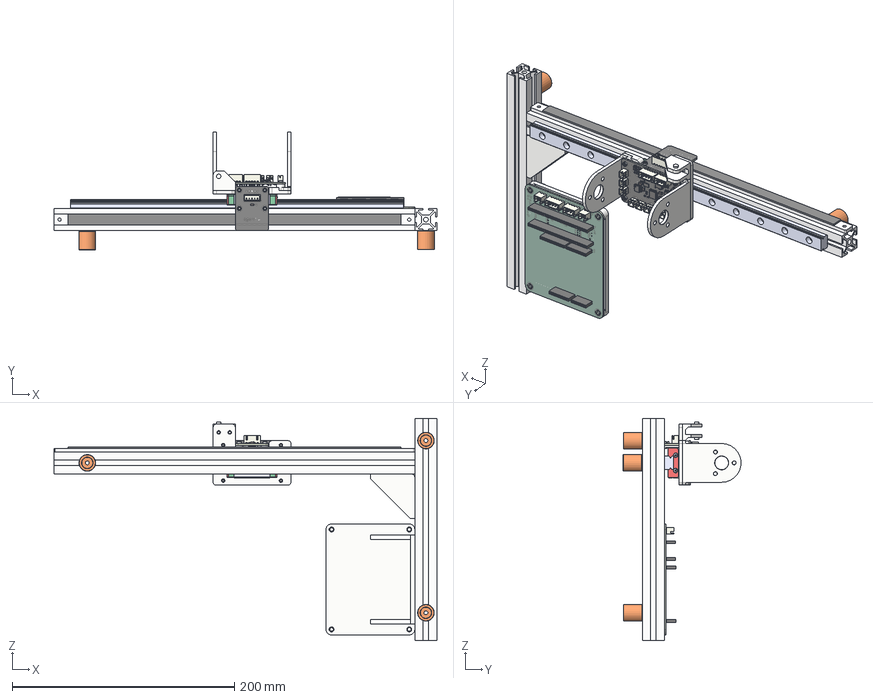
[picture p47: CAD file, 2026-10-26]
04_fixtures/01_validation_setup/04_mechanical/main.step
345.0 x 106.2 x 200.0 mm
m2x3x3.5 x 10
Aluminium extrusion 20x20x1000
MGN12 LINEAR GUIDE RAIL, CONFIGURABLE_200 mm
MGN12H, LINEAR GUIDE BLOCK
rail_interface
encoder-interface
20-pin_TSSOP_
C_0402_1005Metric x 2
R_0402_1005Metric
JST_XH_B5B-XH-A_1x05_P2.50mm_Vertical
C_1206_3216Metric
main_silkscreen
main_silkscreen_1
main_soldermask
main_soldermask_1
main_PCB
m2x4mm x 4
m3x7mm x 4
m2x6x3.5 x 4
armature-interfaces x 2
JST_PH_B2B-PH-K_1x02_P2.00mm_Vertical x 8
R_0603_1608Metric x 16
C_1206_3216Metric_1 x 3
JST_XH_B4B-XH-A_1x04_P2.50mm_Vertical
C_0603_1608Metric x 19
ECS-80-20-18-TR
SOT-223
SW_Push_1P1T_NO_CK_KMR2 x 2
LGA-14_3x5mm_P0.8mm_LayoutBorder1x6y
SOIC-8_3.9x4.9mm_P1.27mm
JST_XH_B5B-XH-A_1x05_P2.50mm_Vertical_1
LQFP-32_7x7mm_P0.8mm
PinHeader_2x03_P2.54mm_Vertical
ECS-80-20-18-TR_1
LED_0603_1608Metric
SSOP16_plastic
SSOP16_pins x 2
main_silkscreen_2
main_silkscreen_3
main_soldermask_2
main_soldermask_3
main_PCB_1
m2x10mm x 4
linear scale
spacer
drag-chain
Aluminium extrusion 20x20x1000_1
square-backet
frame-standoffs x 3
teensySFOC-stand
JST_XH_B4B-XH-A_1x04_P2.50mm_Vertical_1
JST_XH_B2B-XH-A_1x02_P2.50mm_Vertical x 2
JST_XH_B5B-XH-A_1x05_P2.50mm_Vertical_2
Pin_One023 x 2
Epoxy_Body023 x 2
R_1206_3216Metric x 5
C_1206_3216Metric_2 x 4
SOIC-8_3.9x4.9mm_P1.27mm_1
Pin_One001
Epoxy_Body001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
