wgbowley/OpenLSM/02_motors/00_prototype_alpha/03_mechanical/cad_export.step

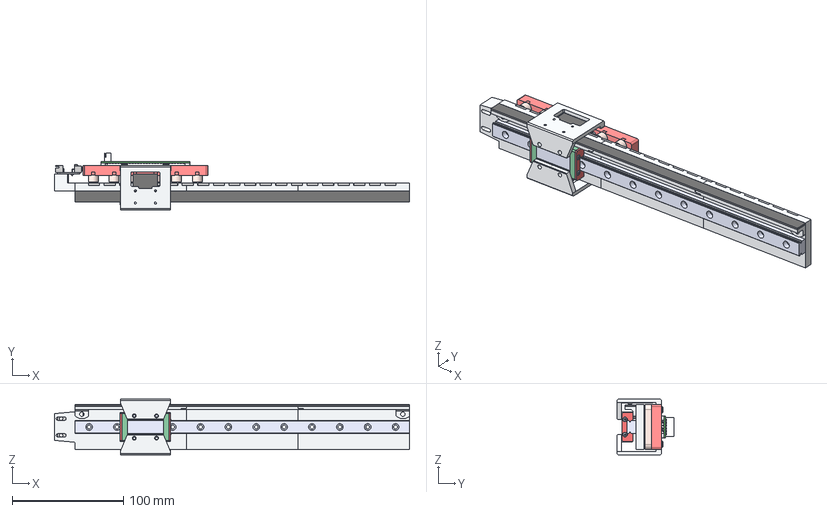
[picture p48: CAD file, 2026-07-04]
02_motors/00_prototype_alpha/03_mechanical/cad_export.step
318.6 x 50.8 x 50.0 mm
MGN12 LINEAR GUIDE RAIL, CONFIGURABLE_200 mm
MGN12H, LINEAR GUIDE BLOCK
Stator
Scale Holder
Magnetic Scale
Magnet x 20
Limit Switch
Slot x 6
Armuture
Spacer x 4
PCB_1
JST - XH - Thru - 6Pin - 2.54mm
Interface Plates x 2
M3 x 8 x 4
Development Board
