wgbowley/OpenLSM/02_motors/01_prototype_beta/rev_3/03_mechanical/motor.step

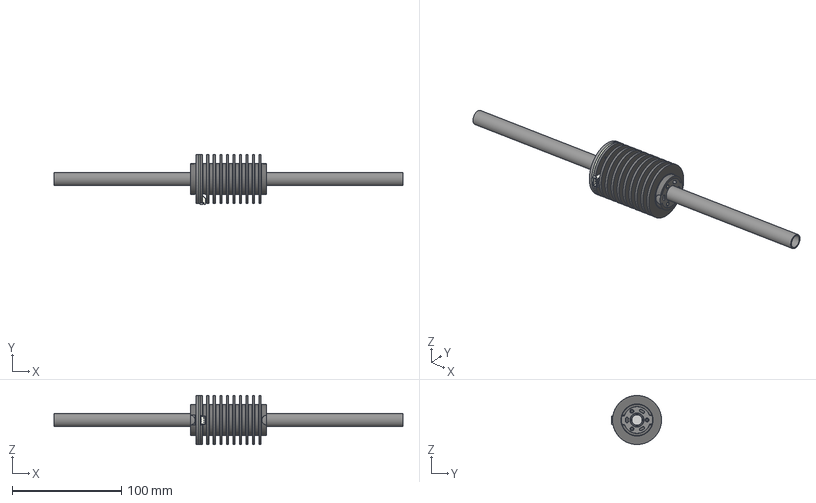
[picture p49: CAD file, 2026-10-26]
02_motors/01_prototype_beta/rev_3/03_mechanical/motor.step
320.0 x 46.0 x 45.0 mm
slot x 18
potting_material
end-cpas x 2
heat-sink
m2x3x3.5 x 6
n52 x 30
JST_PH_S3B-PH-K_1x03_P2.00mm_Horizontal
main_silkscreen
main_silkscreen_1
main_soldermask
main_soldermask_1
main_PCB
spacer
m2x4 x 3
