wgbowley/OpenLSM/02_motors/01_prototype_beta/rev_3/04_electrical/04_logo/logo.dxf

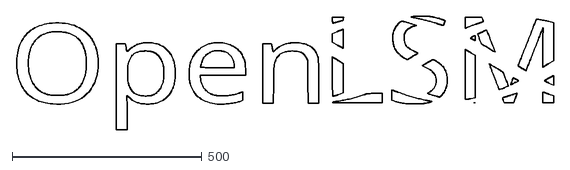
[picture p50: CAD file, 2026-10-26]
02_motors/01_prototype_beta/rev_3/04_electrical/04_logo/logo.dxf
1416.3 x 299.7
