wgbowley/OpenLSM/03_boards/00_armature_board/03_kicad/02_components/74HC4051/SSOP16.STEP

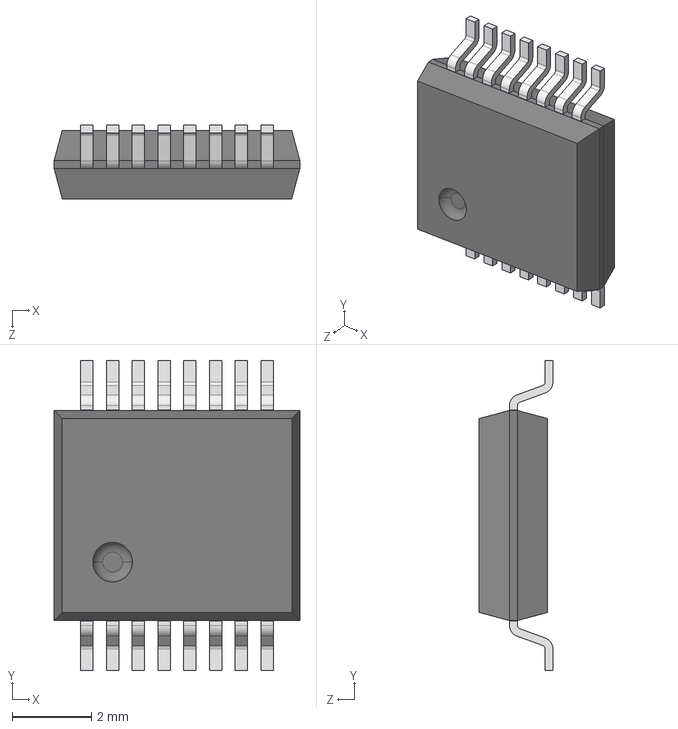
[picture p51: CAD file, 2026-07-26]
03_boards/00_armature_board/03_kicad/02_components/74HC4051/SSOP16.STEP
6.20 x 7.82 x 1.86 mm
SSOP16_plastic
SSOP16_pins x 2
