wgbowley/OpenLSM/03_boards/00_bridge_driver/03_kicad/02_components/BLM18AG601SN1D/BLM18AG601SN1D.step

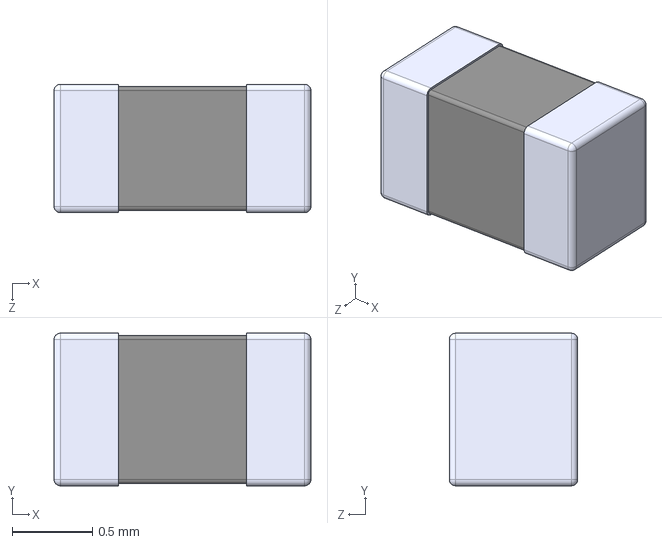
[picture p52: CAD file, 2026-07-26]
03_boards/00_bridge_driver/03_kicad/02_components/BLM18AG601SN1D/BLM18AG601SN1D.step
1.60 x 0.95 x 0.8 mm
