wgbowley/OpenLSM/03_boards/00_bridge_driver/03_kicad/02_components/ECS-80-18-23B-JTN-TR/ECS-80-20-18-TR.step

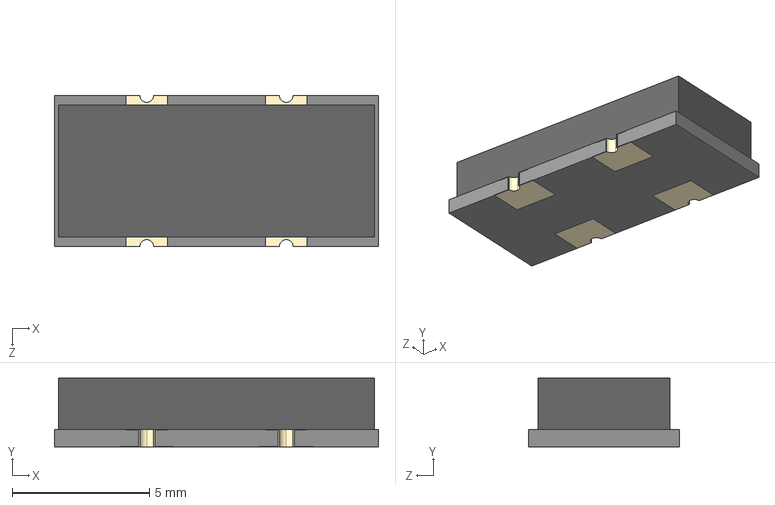
[picture p53: CAD file, 2026-07-26]
03_boards/00_bridge_driver/03_kicad/02_components/ECS-80-18-23B-JTN-TR/ECS-80-20-18-TR.step
11.8 x 2.50 x 5.50 mm
