wgbowley/OpenLSM/03_boards/00_bridge_driver/03_kicad/02_components/ES1D/ES1D.step

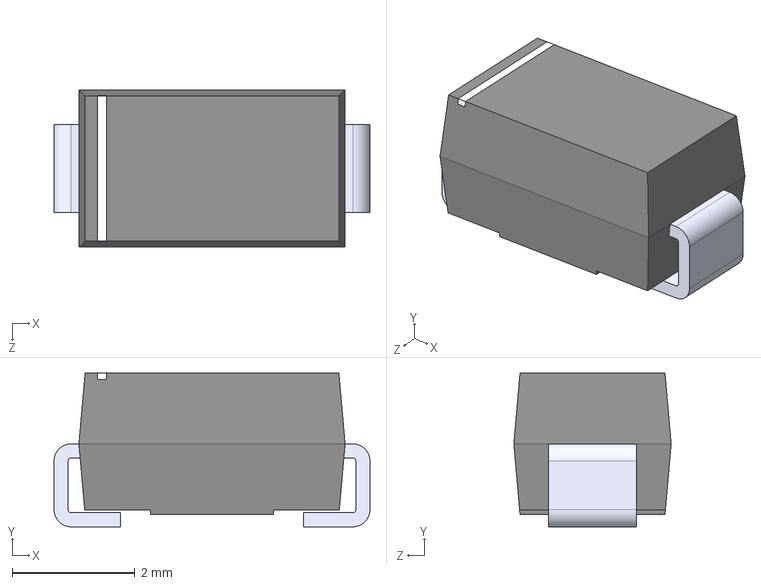
[picture p54: CAD file, 2026-09-06]
03_boards/00_bridge_driver/03_kicad/02_components/ES1D/ES1D.step
5.14 x 2.50 x 2.56 mm
