wgbowley/OpenLSM/03_boards/00_bridge_driver/03_kicad/02_components/IRS2104_SOIC/IR2104SPBF.STEP

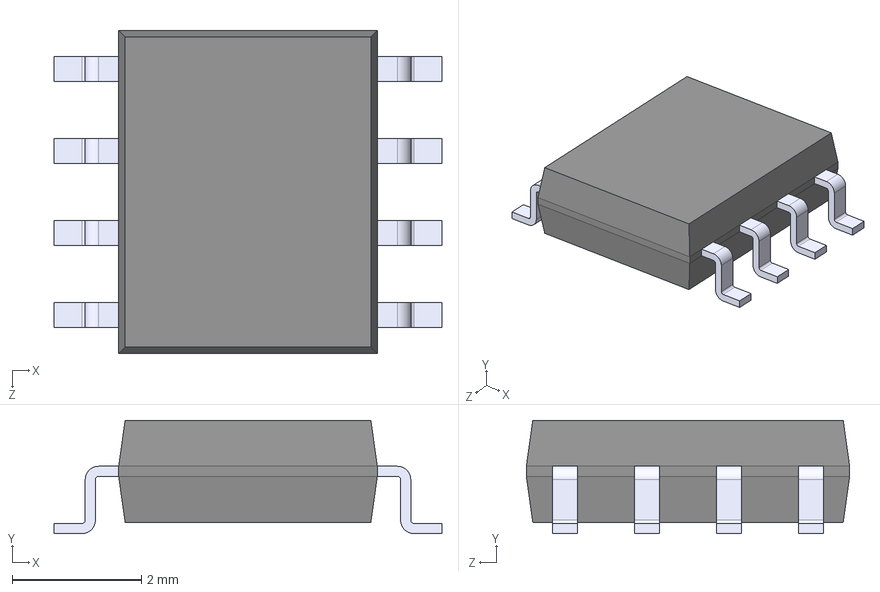
[picture p55: CAD file, 2026-07-26]
03_boards/00_bridge_driver/03_kicad/02_components/IRS2104_SOIC/IR2104SPBF.STEP
6.00 x 1.75 x 5.00 mm
