wgbowley/OpenLSM/03_boards/01_magnetic_encoder/03_kicad/02_components/AS5311-ATST-500/20-pin_TSSOP_.step

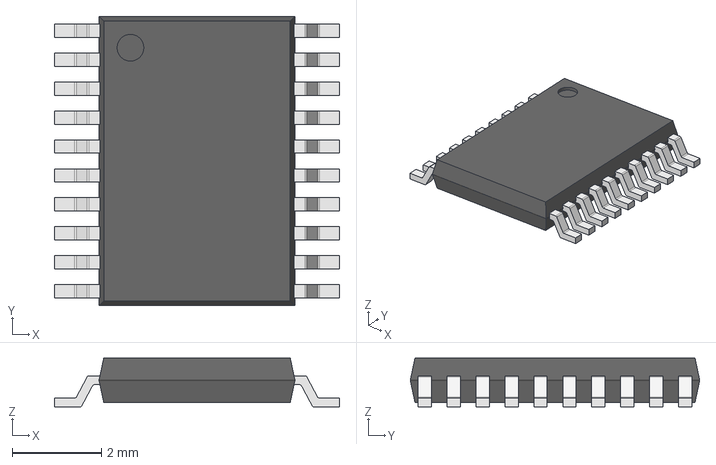
[picture p56: CAD file, 2026-07-26]
03_boards/01_magnetic_encoder/03_kicad/02_components/AS5311-ATST-500/20-pin_TSSOP_.step
6.40 x 6.50 x 1.10 mm
