wgbowley/OpenLSM/03_boards/02_teensy_SFOC/03_kicad/02_components/arduino_uno/Female_Header_1x8_P2.54_H8.5_straight.step

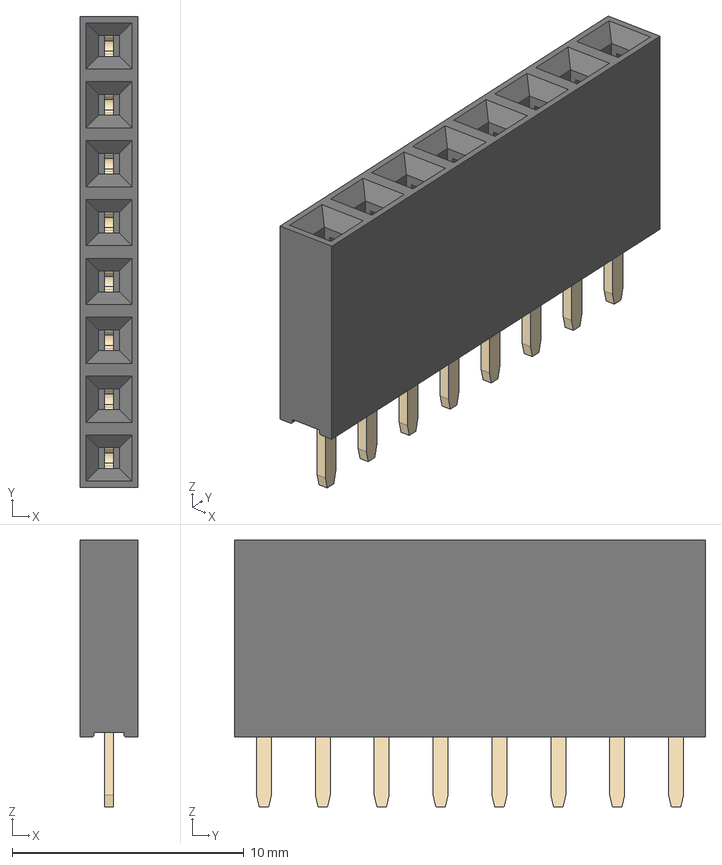
[picture p57: CAD file, 2026-09-21]
03_boards/02_teensy_SFOC/03_kicad/02_components/arduino_uno/Female_Header_1x8_P2.54_H8.5_straight.step
2.50 x 20.3 x 11.5 mm
Pin_One
Epoxy_Body
