wgbowley/OpenLSM/03_boards/03_teensy_SFOC/03_kicad/02_components/arduino_uno/Female_Header_1x6_P2.54_H8.5_straight.step

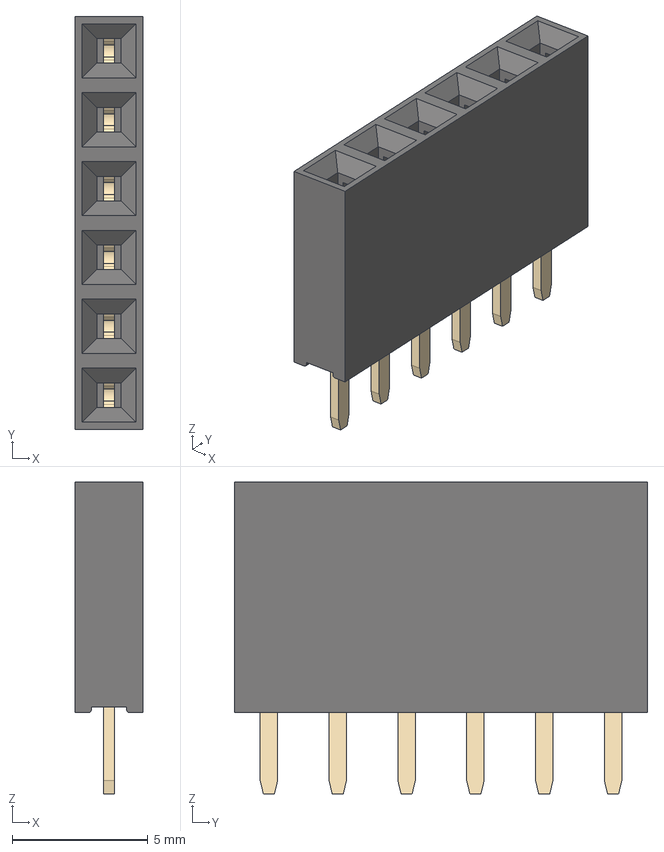
[picture p58: CAD file, 2026-09-21]
03_boards/03_teensy_SFOC/03_kicad/02_components/arduino_uno/Female_Header_1x6_P2.54_H8.5_straight.step
2.50 x 15.2 x 11.5 mm
Pin_One001
Epoxy_Body001
