wgbowley/OpenLSM/03_boards/03_teensy_SFOC/03_kicad/02_components/teensy_library/Female_Header_1x24_P2.54_H8.5_straight.step

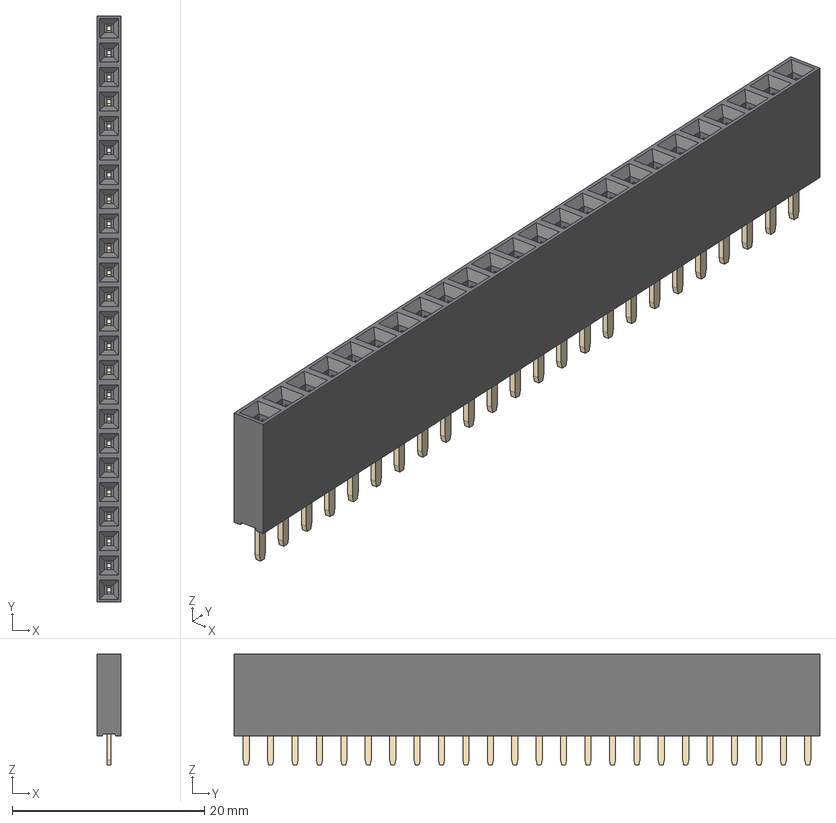
[picture p59: CAD file, 2026-09-21]
03_boards/03_teensy_SFOC/03_kicad/02_components/teensy_library/Female_Header_1x24_P2.54_H8.5_straight.step
2.50 x 61.0 x 11.5 mm
Pin_One023
Epoxy_Body023
