wgbowley/OpenLSM/04_fixture/01_validation_setup/03_components/rev0_teensySFOC.step

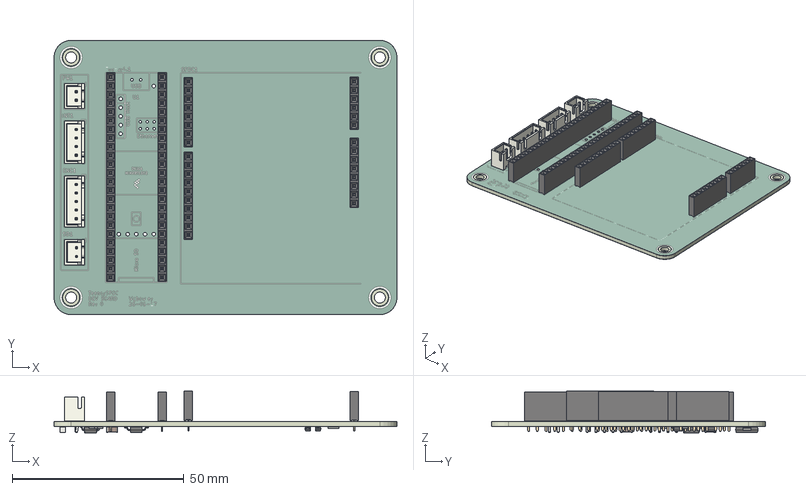
[picture p60: CAD file, 2026-10-06]
04_fixture/01_validation_setup/03_components/rev0_teensySFOC.step
100.0 x 80.0 x 12.2 mm
JST_XH_B4B-XH-A_1x04_P2.50mm_Vertical
JST_XH_B2B-XH-A_1x02_P2.50mm_Vertical x 2
JST_XH_B5B-XH-A_1x05_P2.50mm_Vertical
Pin_One023 x 2
Epoxy_Body023 x 2
R_1206_3216Metric x 5
C_1206_3216Metric x 4
SOIC-8_3.9x4.9mm_P1.27mm
Pin_One001
Epoxy_Body001
Pin_One002
Epoxy_Body002
Pin_One x 2
Epoxy_Body x 2
SOT-223
D_SOD-123 x 2
teensy_SFOC_silkscreen x 2
teensy_SFOC_soldermask x 2
teensy_SFOC_PCB
