wgbowley/OpenLSM/04_fixtures/01_validation_setup/03_components/rev1_armature_board.step

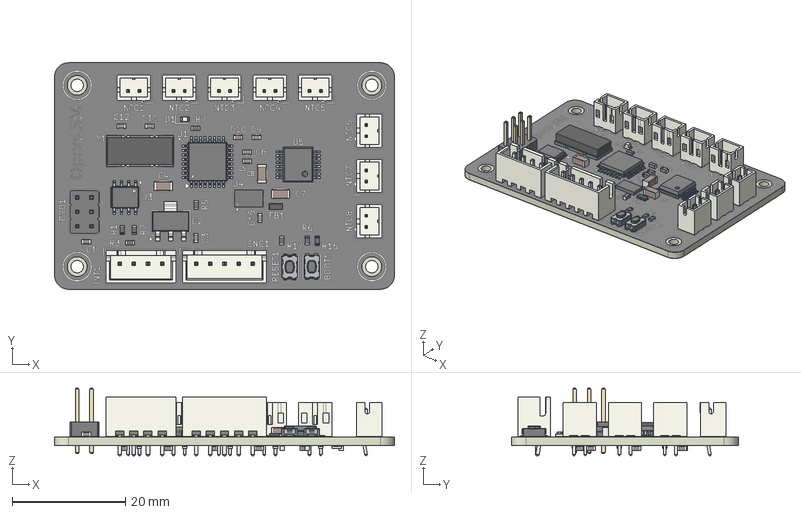
[picture p61: CAD file, 2026-10-06]
04_fixtures/01_validation_setup/03_components/rev1_armature_board.step
60.0 x 40.0 x 11.9 mm
JST_PH_B2B-PH-K_1x02_P2.00mm_Vertical x 8
R_0603_1608Metric x 16
C_1206_3216Metric x 3
JST_XH_B4B-XH-A_1x04_P2.50mm_Vertical
C_0603_1608Metric x 19
ECS-80-20-18-TR x 2
SOT-223
SW_Push_1P1T_NO_CK_KMR2 x 2
LGA-14_3x5mm_P0.8mm_LayoutBorder1x6y
SOIC-8_3.9x4.9mm_P1.27mm
JST_XH_B5B-XH-A_1x05_P2.50mm_Vertical
LQFP-32_7x7mm_P0.8mm
PinHeader_2x03_P2.54mm_Vertical
LED_0603_1608Metric
SSOP16_plastic
SSOP16_pins x 2
main_silkscreen x 2
main_soldermask x 2
main_PCB
