wgbowley/OpenLSM/02_motors/01_prototype_beta/rev_3/03_mechanical/interface_board.step

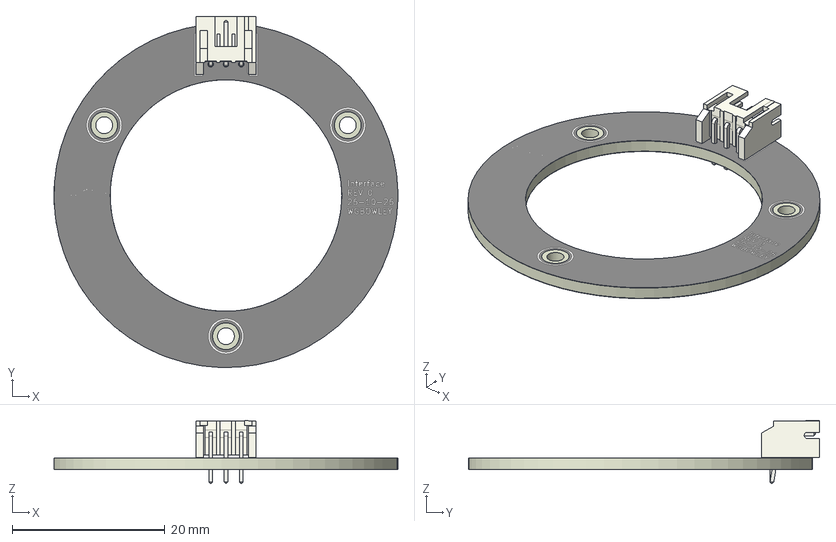
[picture p62: CAD file, 2026-10-26]
02_motors/01_prototype_beta/rev_3/03_mechanical/interface_board.step
45.0 x 45.9 x 8.25 mm
JST_PH_S3B-PH-K_1x03_P2.00mm_Horizontal
main_silkscreen x 2
main_soldermask x 2
main_PCB
