wgbowley/OpenLSM/03_boards/02_teensy_SFOC/03_kicad/02_components/arduino_uno/Female_Header_1x10_P2.54_H8.5_straight.step

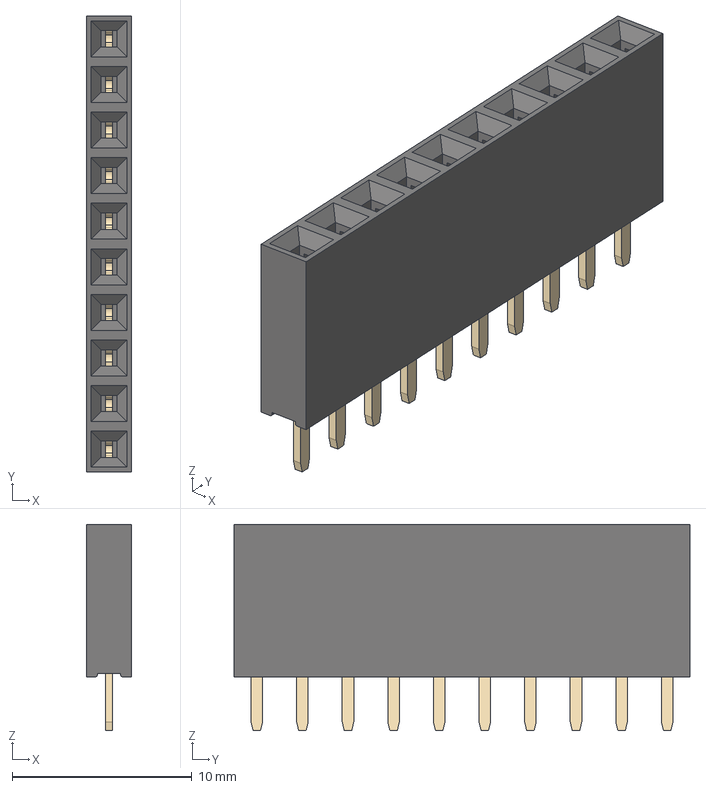
[picture p63: CAD file, 2026-09-21]
03_boards/02_teensy_SFOC/03_kicad/02_components/arduino_uno/Female_Header_1x10_P2.54_H8.5_straight.step
2.50 x 25.4 x 11.5 mm
Pin_One002
Epoxy_Body002
