wgbowley/OpenLSM/04_fixture/01_validation_setup/03_components/rev0_encoder_board.step

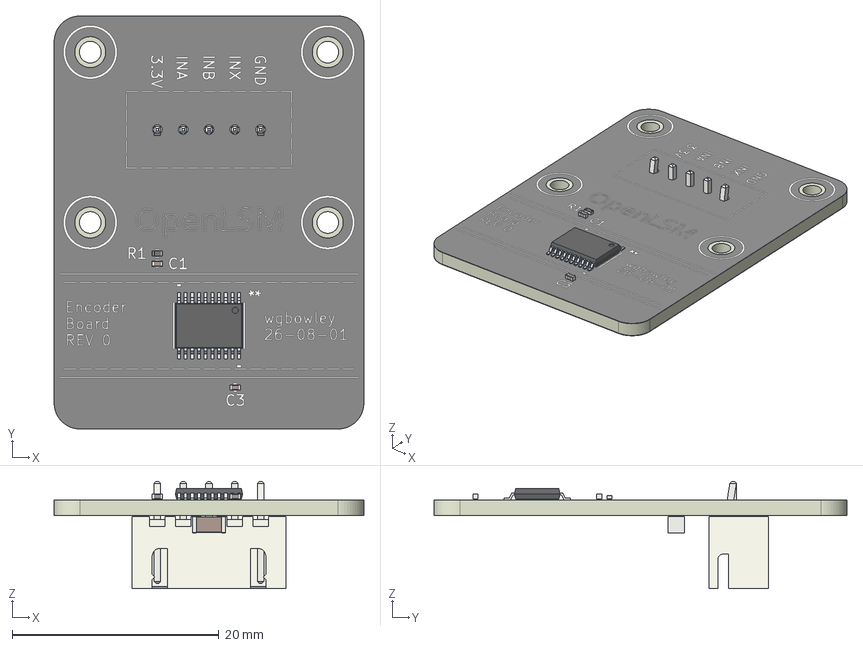
[picture p64: CAD file, 2026-09-13]
04_fixture/01_validation_setup/03_components/rev0_encoder_board.step
30.0 x 40.0 x 10.4 mm
20-pin_TSSOP_
C_0402_1005Metric x 2
R_0402_1005Metric
JST_XH_B5B-XH-A_1x05_P2.50mm_Vertical
C_1206_3216Metric
main_silkscreen x 2
main_soldermask x 2
main_PCB
