wgbowley/OpenLSM/(list of files, cad)

Other CAD files:
02_motors/00_prototype_alpha/03_mechanical/cad_native.f3z
02_motors/01_prototype_beta/rev_1/03_mechanical/cad_export.step
02_motors/01_prototype_beta/rev_1/03_mechanical/cad_native.f3z
02_motors/01_prototype_beta/rev_2/03_mechanical/cad_export.step
02_motors/01_prototype_beta/rev_2/03_mechanical/cad_native.f3z
03_boards/00_bridge_driver/03_kicad/02_components/82683C/82683C.step
06_dropped/00_bridge_driver/03_kicad/02_components/ISO7740DWR/ISO7740DWR.step
