wgbowley/OpenLSM/04_fixture/01_validation_setup/readme.md

### 01_validation_setup

*(TBD) — Work in progress*

---
