wgbowley/OpenLSM/05_media/00_simulation/01_hybrid/armature_test_solution.png

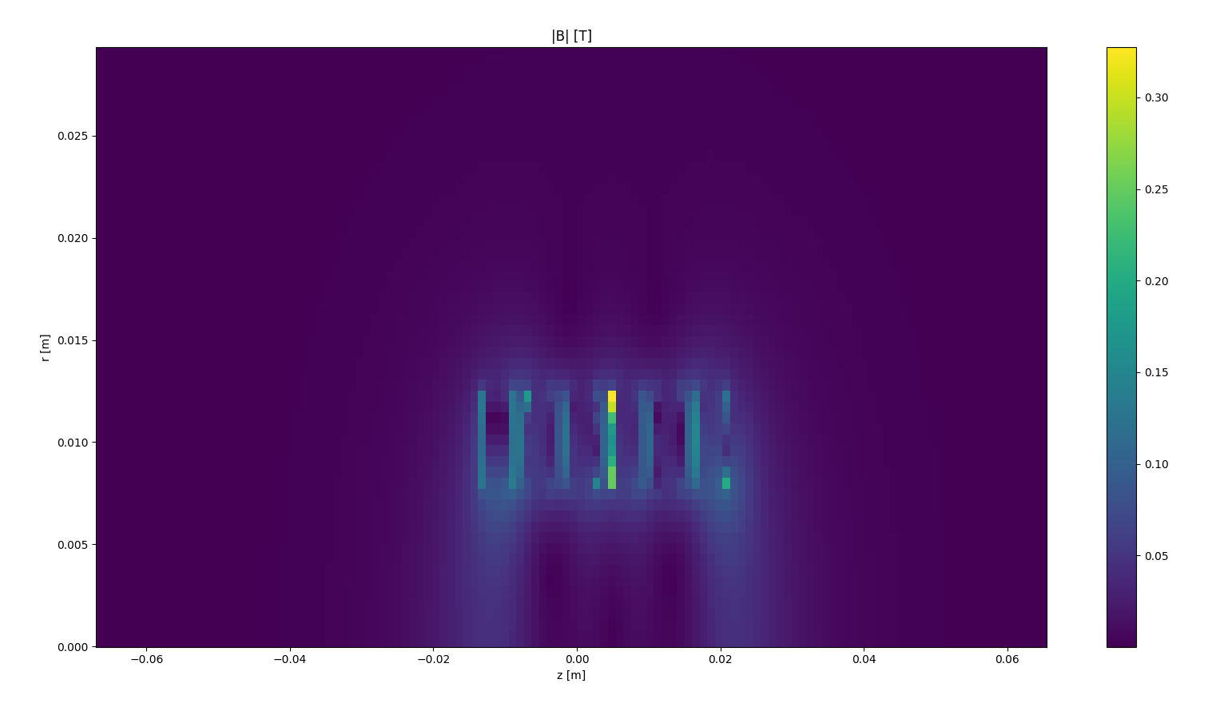
05_media/00_simulation/01_hybrid/armature_test_solution.png
