wgbowley/OpenLSM/05_media/02_prototype_alpha/02_experimental/armature_bottom.jpg

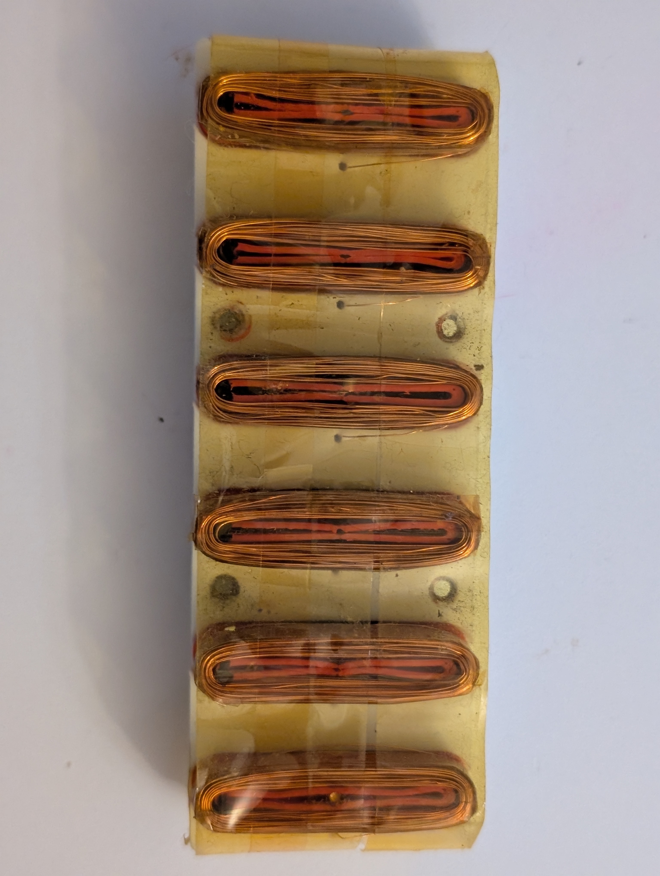
05_media/02_prototype_alpha/02_experimental/armature_bottom.jpg
