wgbowley/OpenLSM/05_media/02_prototype_alpha/02_experimental/armature_slots.jpg

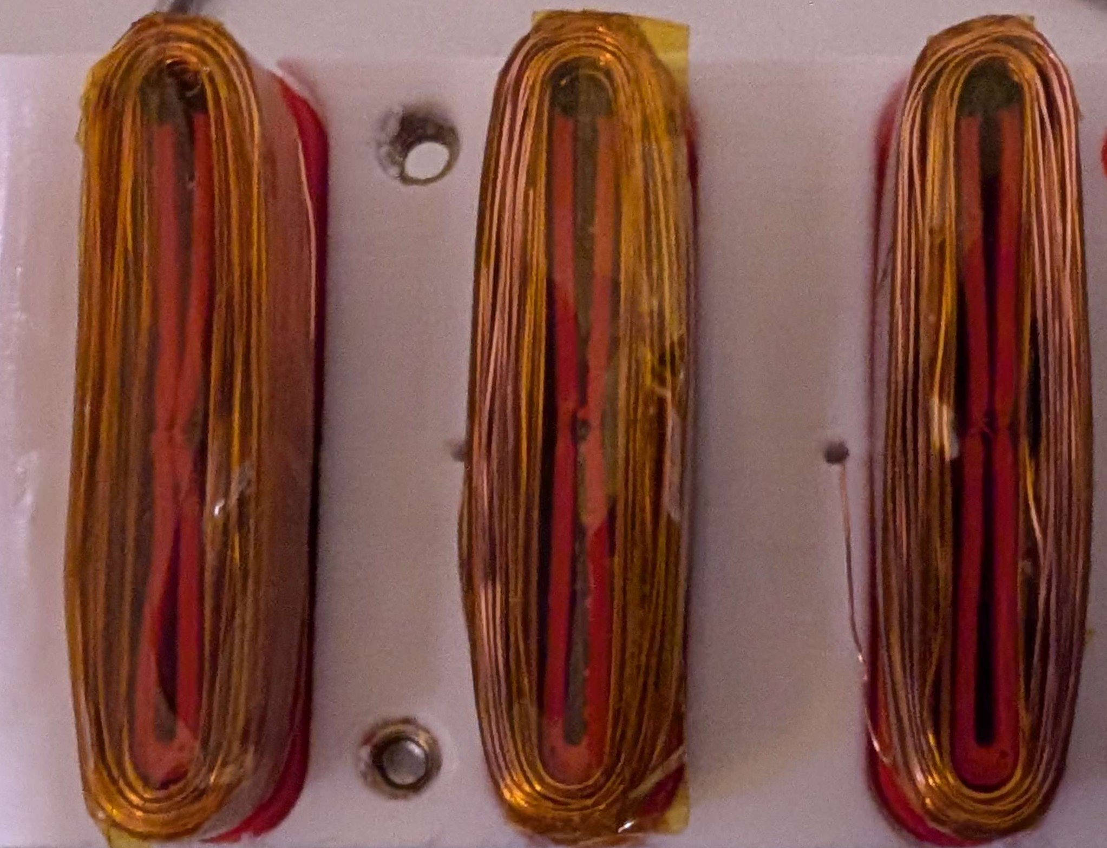
05_media/02_prototype_alpha/02_experimental/armature_slots.jpg
