wgbowley/OpenLSM/05_media/02_prototype_alpha/02_experimental/armature_top.jpg

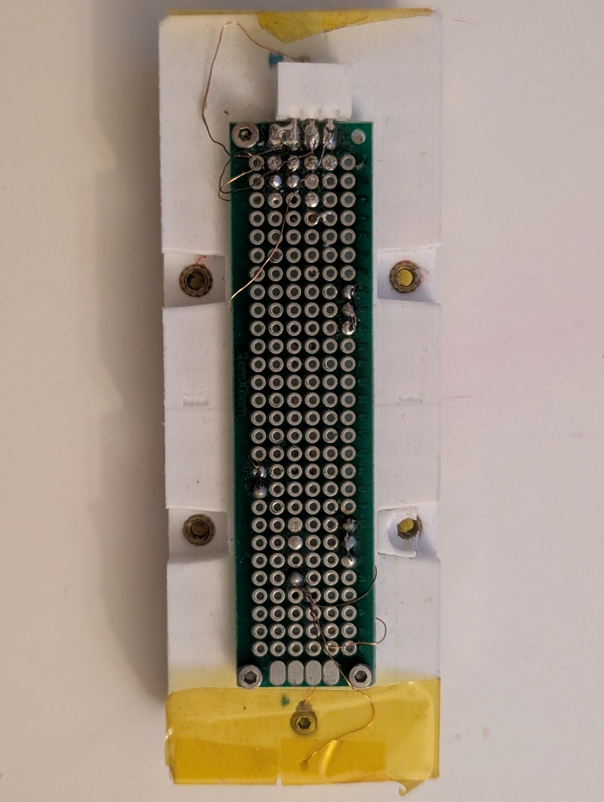
05_media/02_prototype_alpha/02_experimental/armature_top.jpg
