wgbowley/OpenLSM/05_media/02_prototype_alpha/02_experimental/top_down_view.jpg

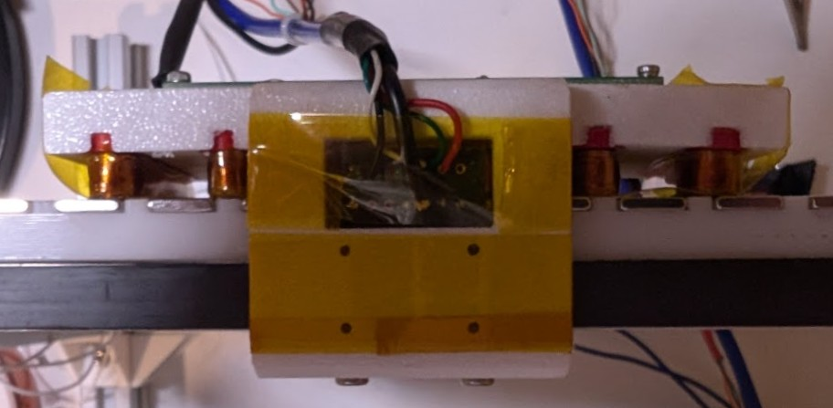
05_media/02_prototype_alpha/02_experimental/top_down_view.jpg
