wgbowley/OpenLSM/05_media/04_fixtures/01_validation_setup/validation_test_bed_fusion_model.png

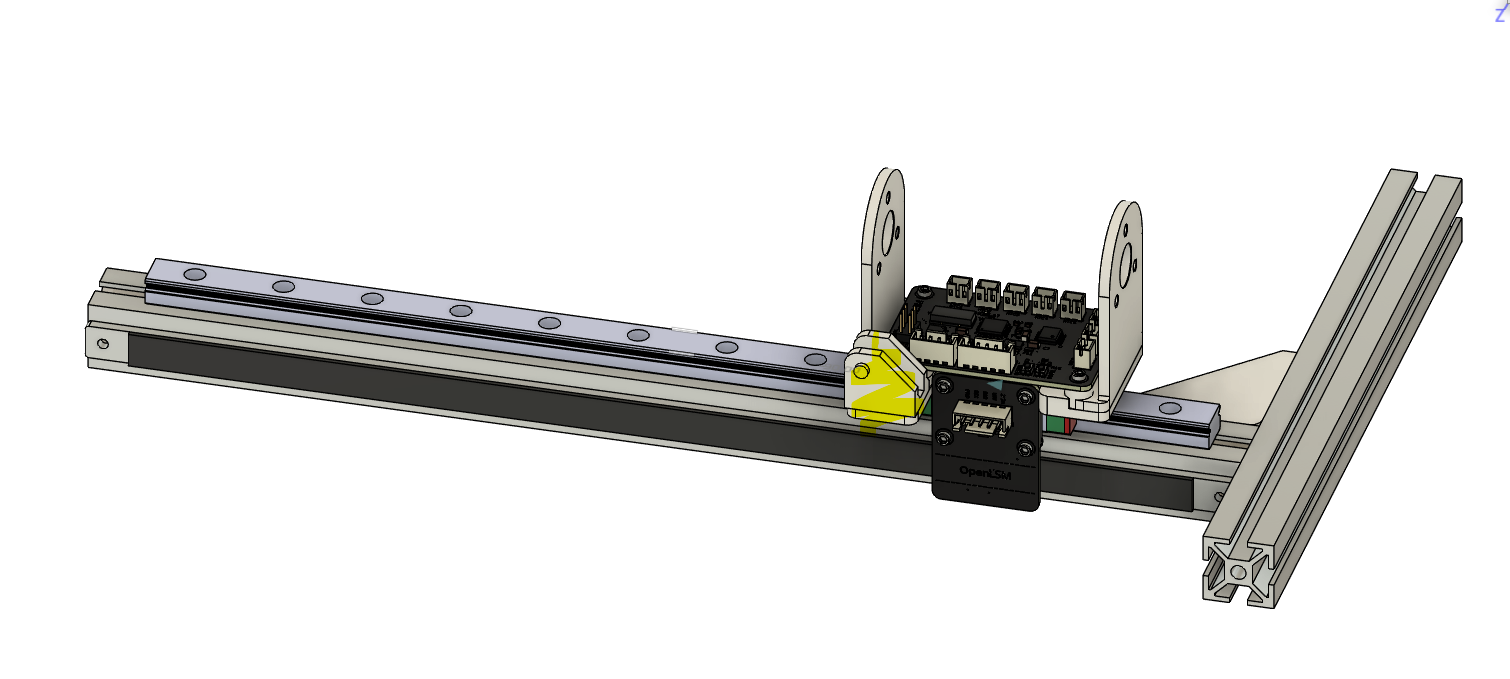
05_media/04_fixtures/01_validation_setup/validation_test_bed_fusion_model.png
