wgbowley/OpenLSM/03_boards/00_armature_board/schematic.pdf

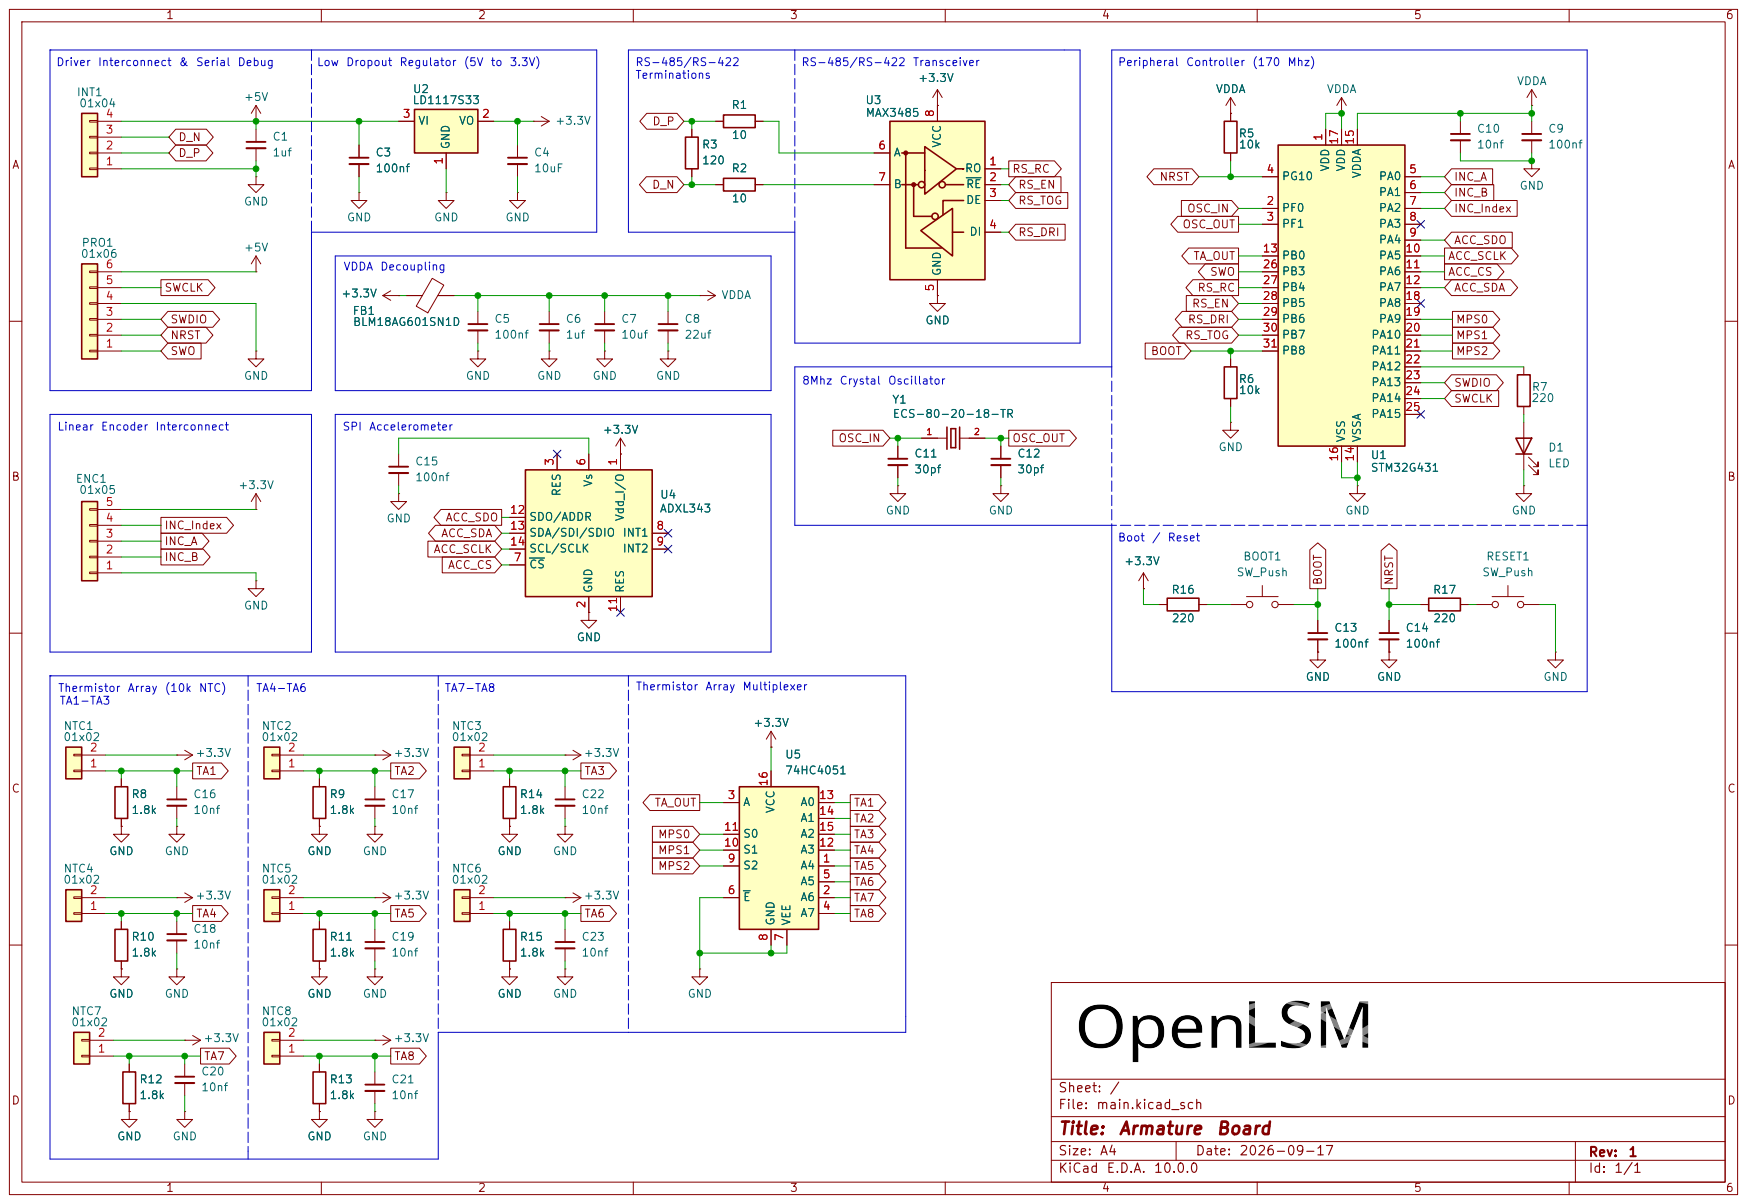
[picture p71: page 1]

1 PF0 2 PF1 3 PG10 4 PA0 5 PA1 6 PA2 7 PA3 8 PA4 9 PA5 10 PA6 11 PA7 12 PB0 13 VSSA 14 VDDA 15 VSS 16 VDD 17 PA8 18 PA9 19 PA10 20 PA11 21 PA12 22 PA13 23 PA14 24 PA15 25 PB3 26 PB4 27 PB5 28 PB6 29 PB7 30 PB8 31 R6

1 PF0 2 PF1 3 PG10 4 PA0 5 PA1 6 PA2 7 PA3 8 PA4 9 PA5 10 PA6 11 PA7 12 PB0 13 VSSA 14 VDDA 15 VSS 16 VDD 17 PA8 18 PA9 19 PA10 20 PA11 21 PA12 22 PA13 23 PA14 24 PA15 25 PB3 26 PB4 27 PB5 28 PB6 29 PB7 30 PB8 31 U1

SPI Accelerometer VDDA Decoupling

Size: A4 | Rev: 1
