wgbowley/OpenLSM/03_boards/03_teensy_SFOC/schematic.pdf

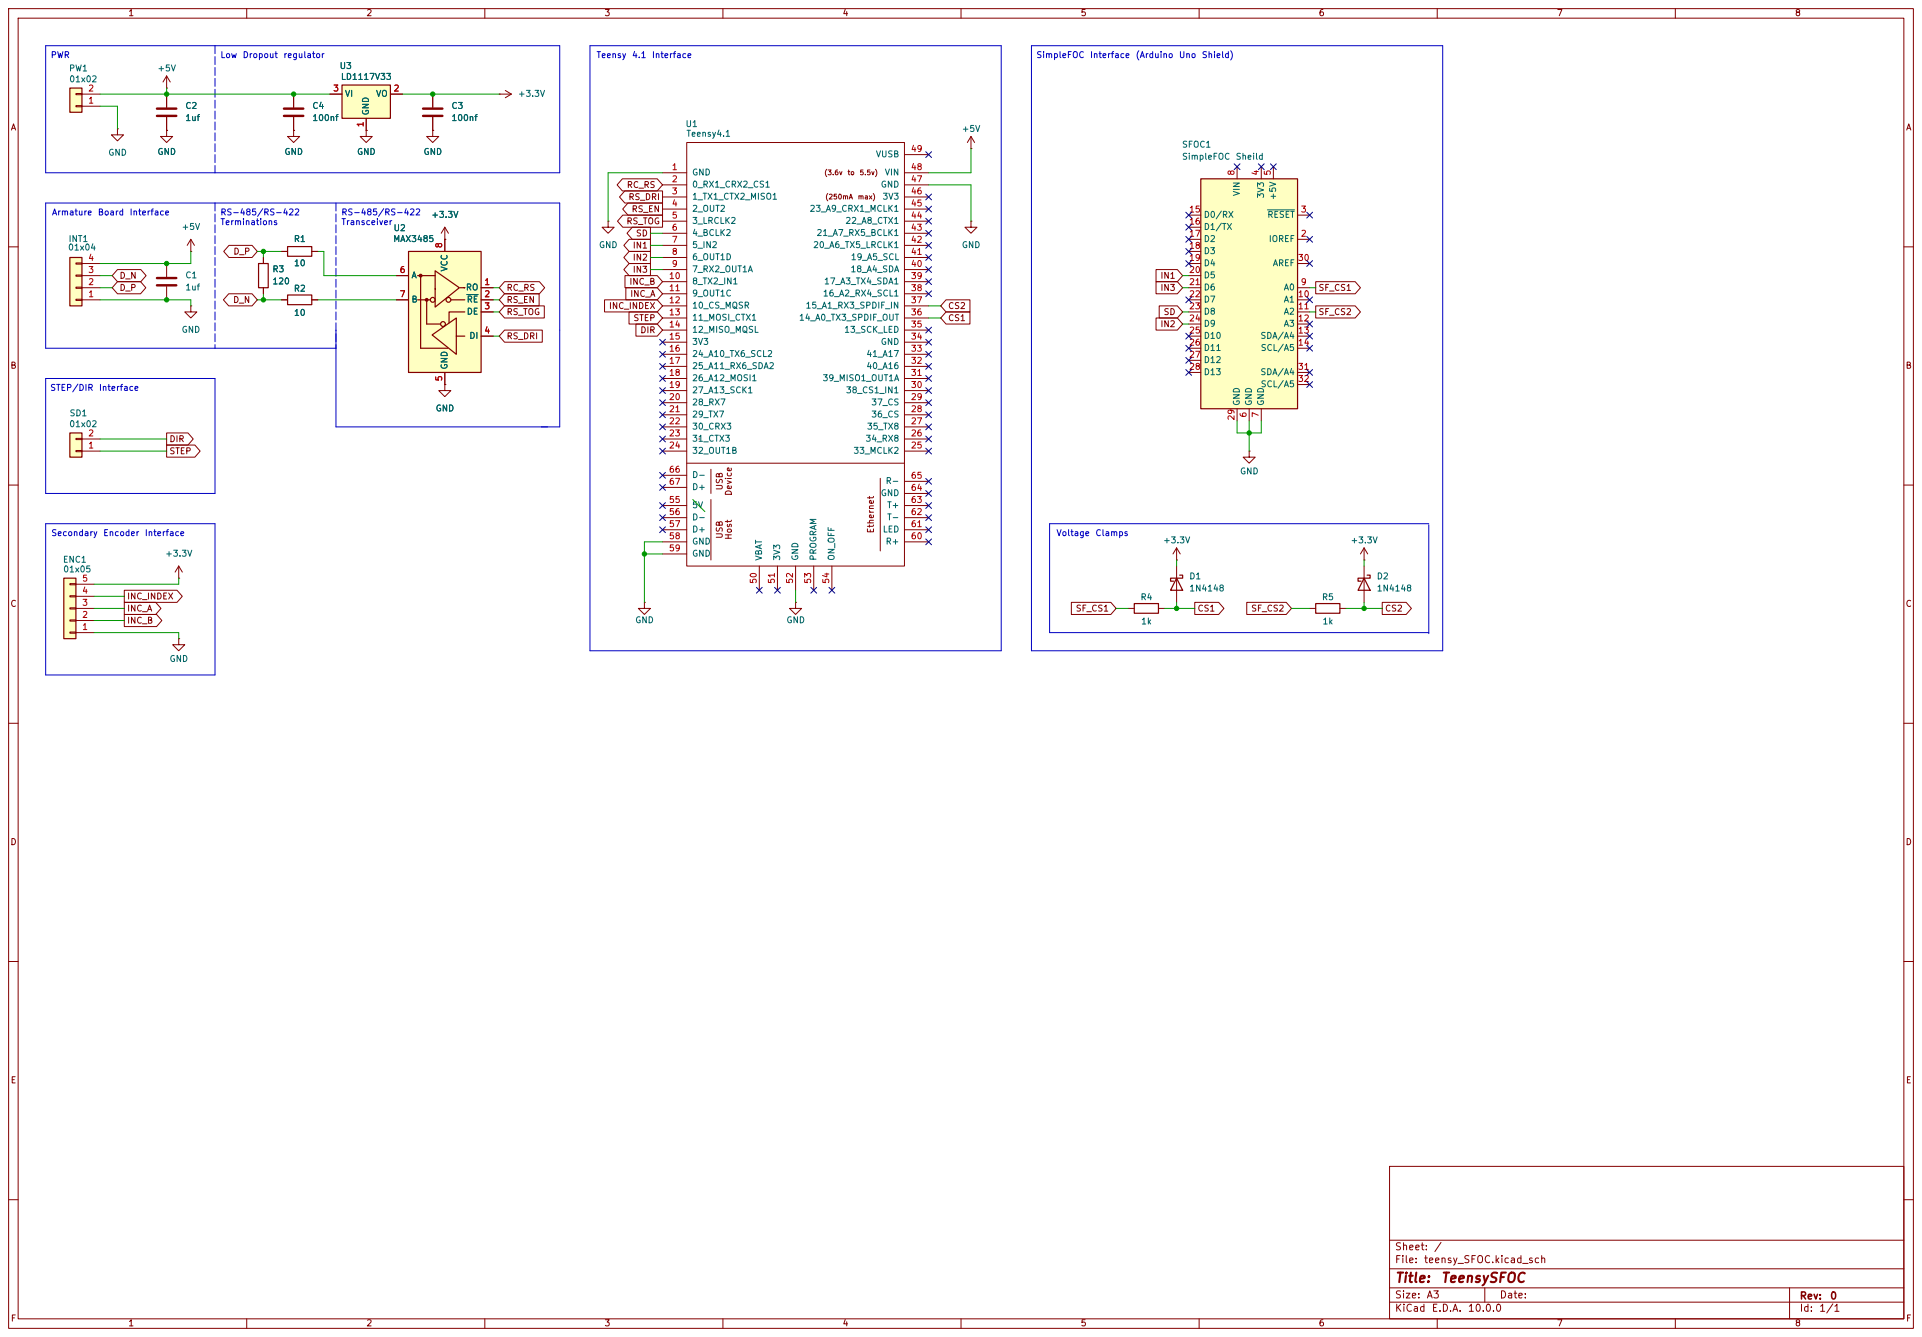
[picture p72: page 1]

Size: A3 | Rev: 0 | F Date:
KiCad E.D.A. 10.0.0 | Id: 1/1
