wgbowley/OpenLSM/06_dropped/00_bridge_driver/schematic.pdf

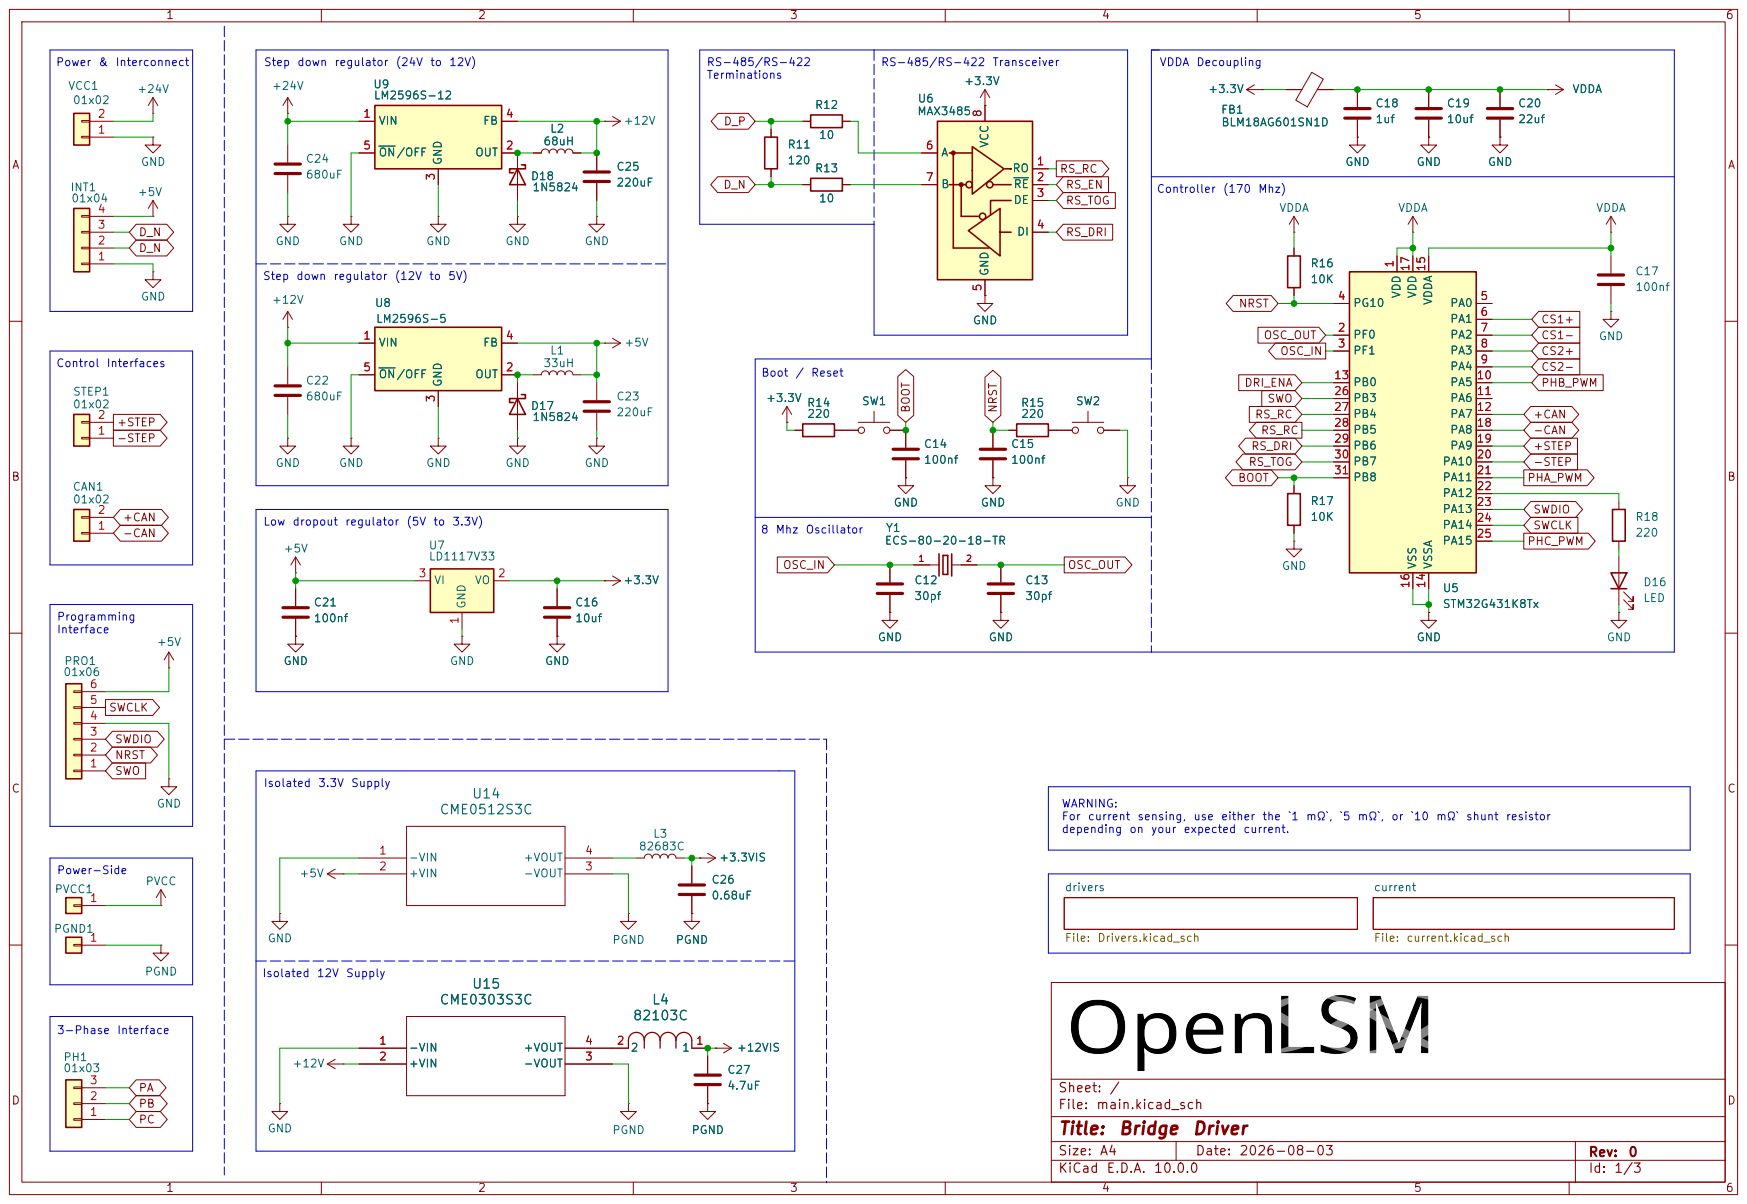
[picture p73: page 1]

Terminations 8 Mhz Oscillator Power & Interconnect Power-Side

1 PF0 2 PF1 3 PG10 4 PA0 5 PA1 6 PA2 7 PA3 8 PA4 9 PA5 10 PA6 11 PA7 12 PB0 13 VSSA 14 VDDA 15 VSS 16 VDD 17 PA8 18 PA9 19 PA10 20 PA11 21 PA12 22 PA13 23 PA14 24 PA15 25 PB3 26 PB4 27 PB5 28 PB6 29 PB7 30 PB8 31 U5 C21 STM32G431K8Tx 100nf GND +5V GND
Step down regulator (12V to 5V)

Low dropout regulator (5V to 3.3V)

depending on your expected current.

Size: A4 | Rev: 0

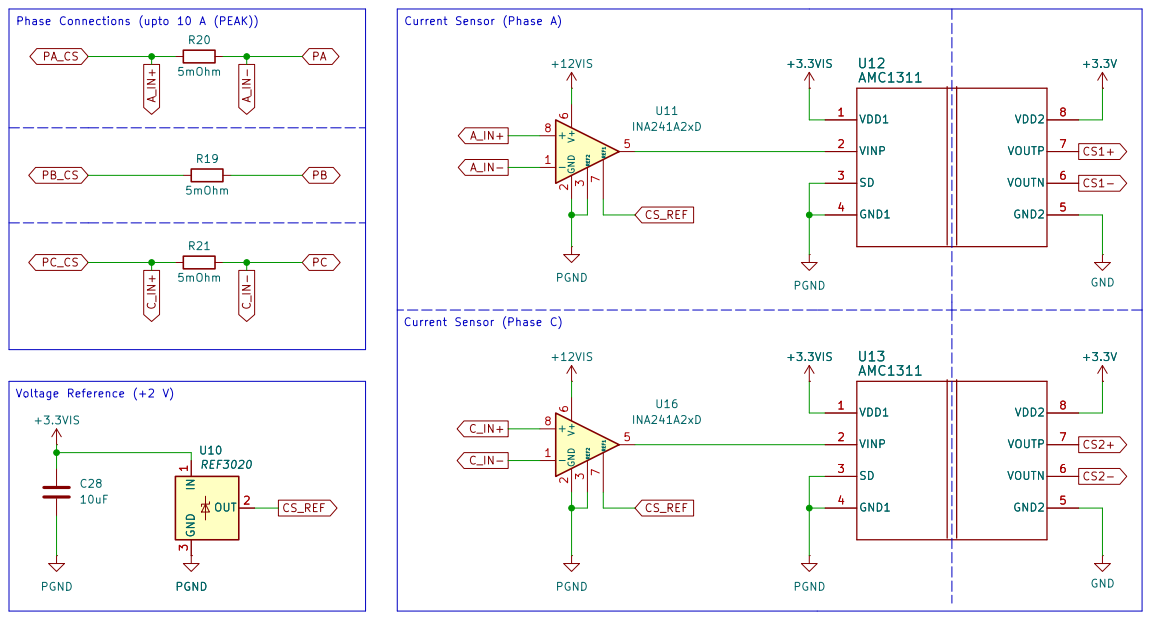
[picture p74: page 2]

File: current.kicad_sch
Title: Current Sensors & Isolation

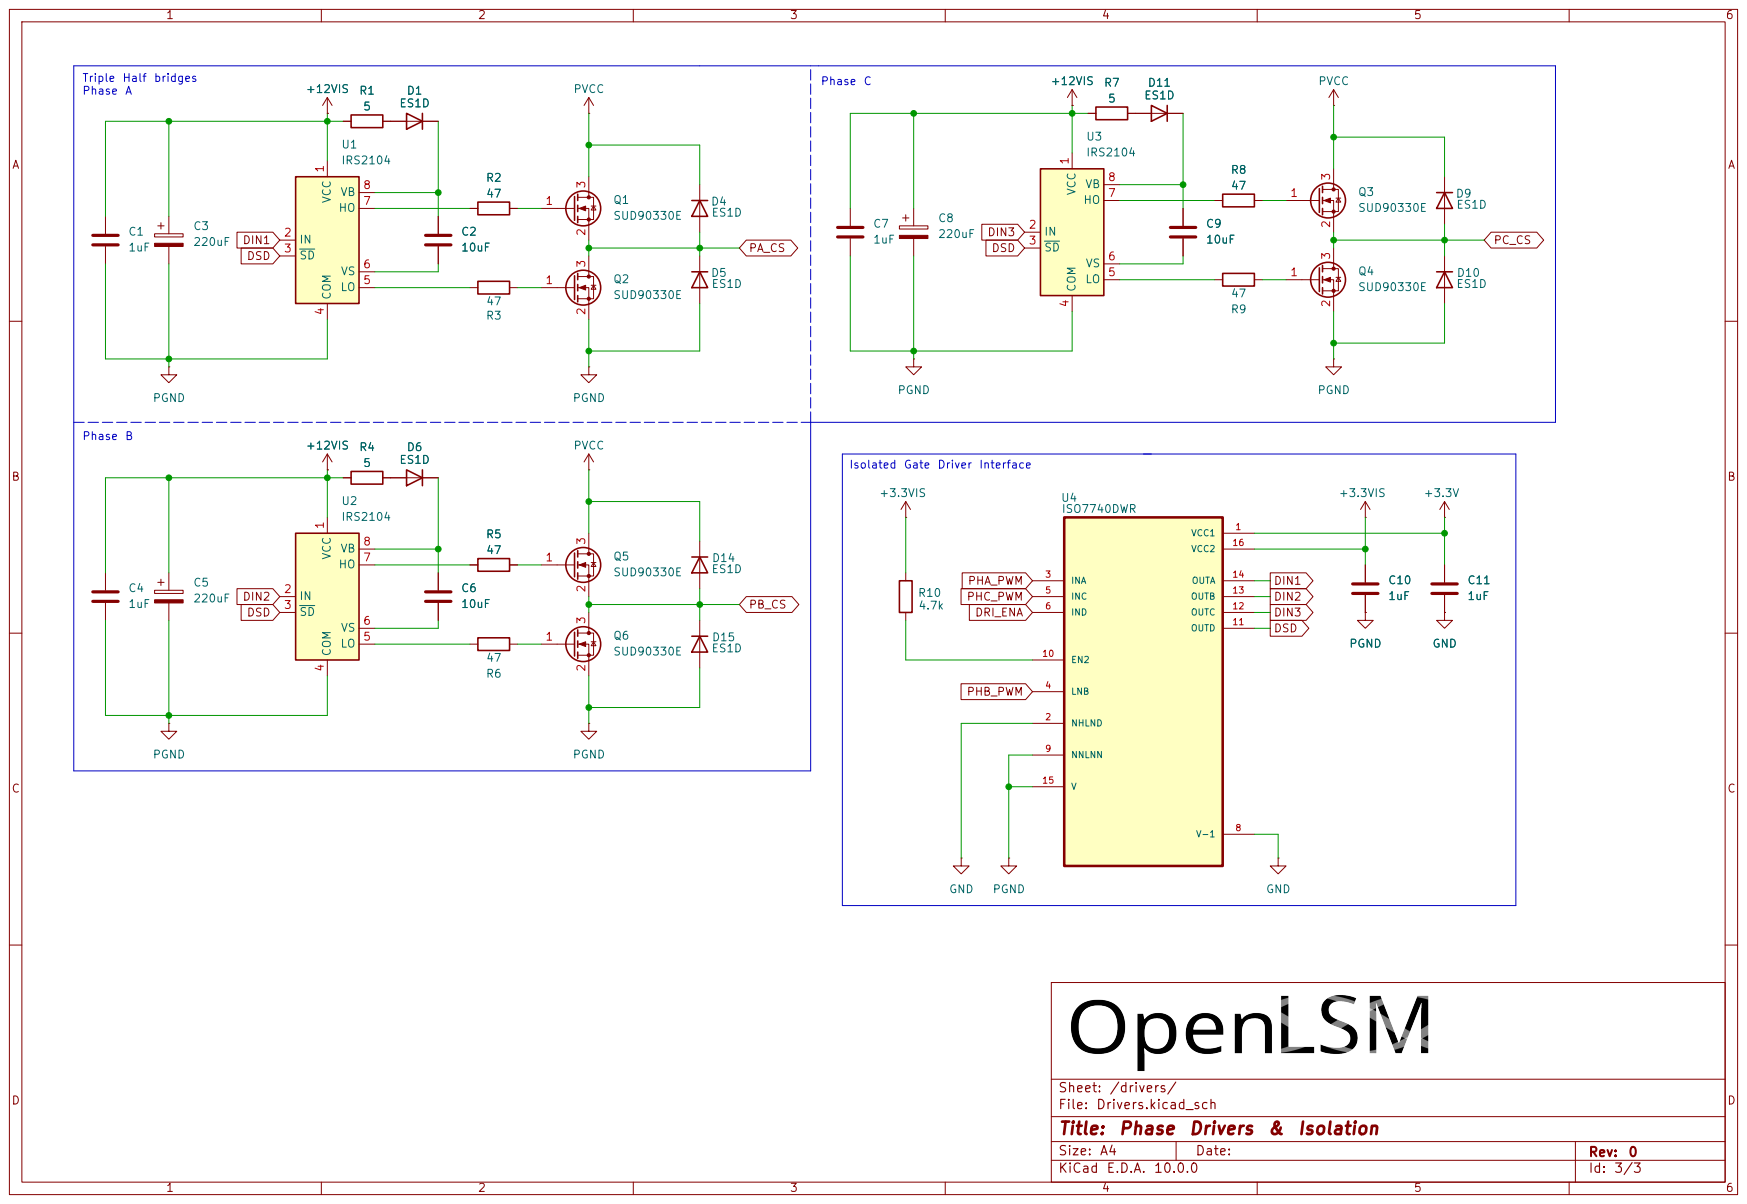
[picture p75: page 3]

Isolated Gate Driver Interface

Sheet: /drivers/
File: Drivers.kicad_sch
Title: Phase Drivers & Isolation
