wgbowley/OpenLSM/03_boards/02_magnetic_encoder/schematic.pdf

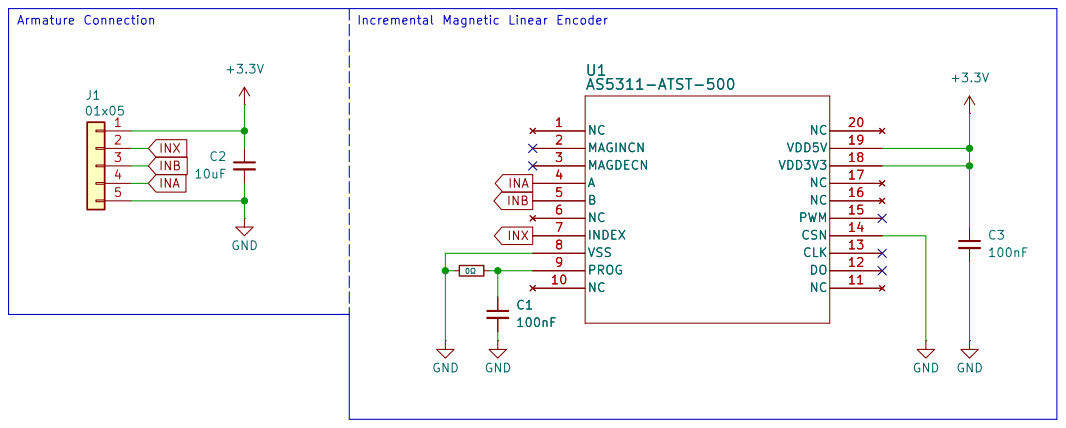
[picture p76: page 1]

Sheet: /
D Date: 2026-08-01 KiCad E.D.A. 10.0.0
File: main.kicad_sch
Title: Linear Magnetic Encoder

Size: A4 | Rev: 0
