wgbowley/OpenLSM/02_motors/00_prototype_alpha/03_mechanical/mechanical_reference.pdf

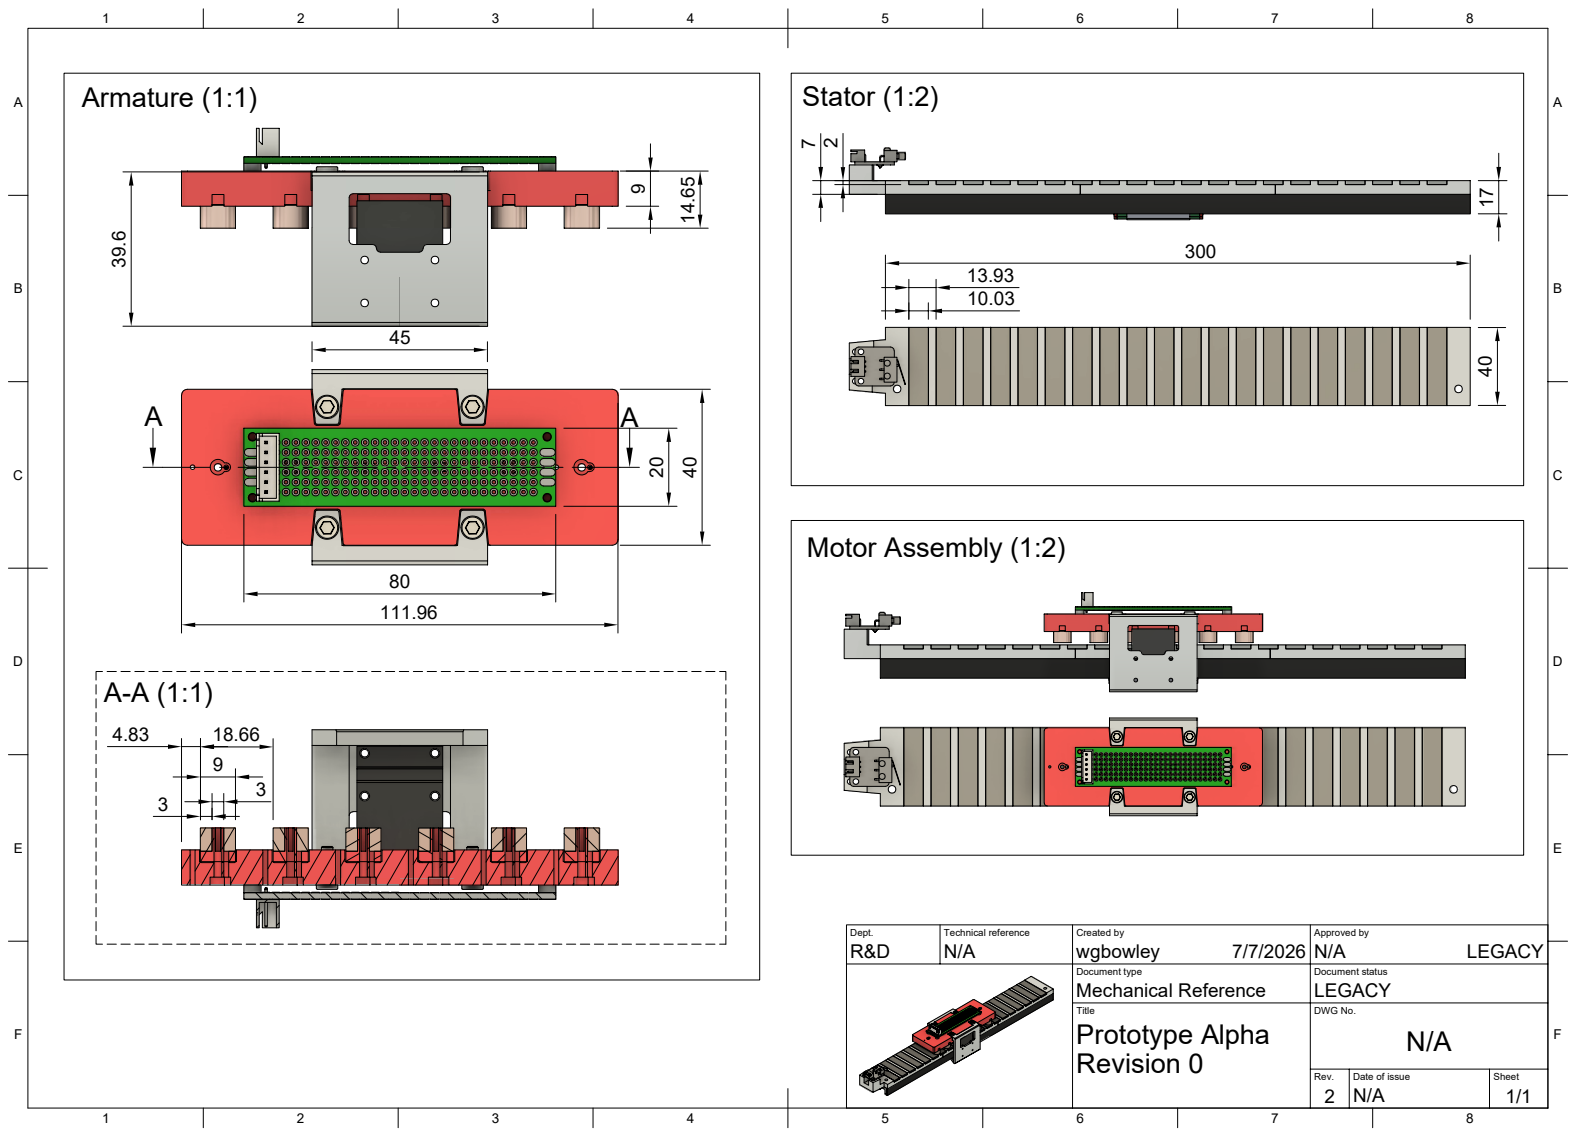
[picture p77: page 1]
8 BCDEF; ABCDEF Dept.; Technical reference; Created by; Approved by Document type; Document status Title; DWG No. Rev.; Date of issue; Sheet 2; N/A Mechanical Reference; LEGACY 7/7/2026; LEGACY 1/1 Revision 0 Prototype Alpha; wgbowley; 20 Stator (1:2) 300 10.03 13.93

17 Armature (1:1) Motor Assembly (1:2) 4.83
