wgbowley/OpenLSM/02_motors/01_prototype_beta/rev_3/04_electrical/main.pdf

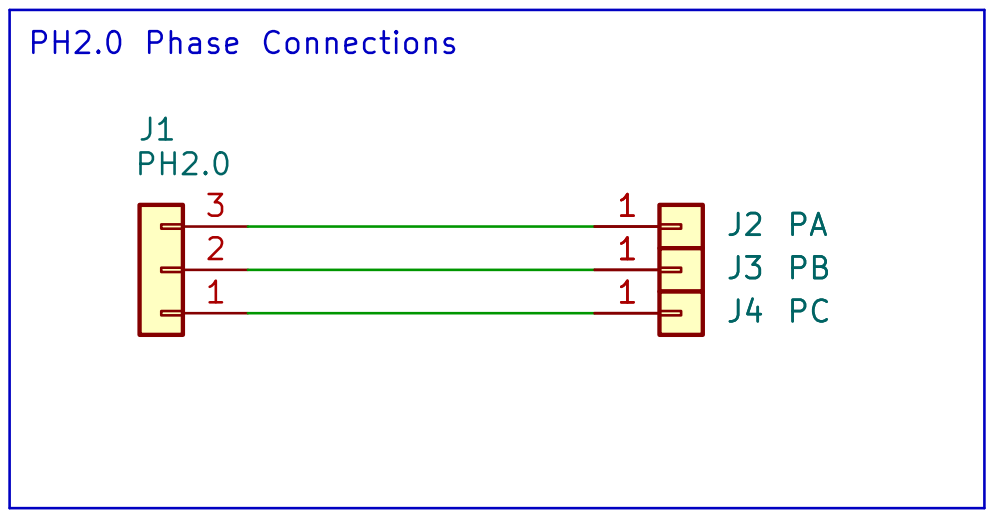
[picture p78: page 1]

Size: A4 | Rev: rev 0
KiCad E.D.A. 10.0.0 | Id: 1/1
