wgbowley/OpenLSM/02_motors/01_prototype_beta/rev_1/03_mechanical/mechanical_reference.pdf

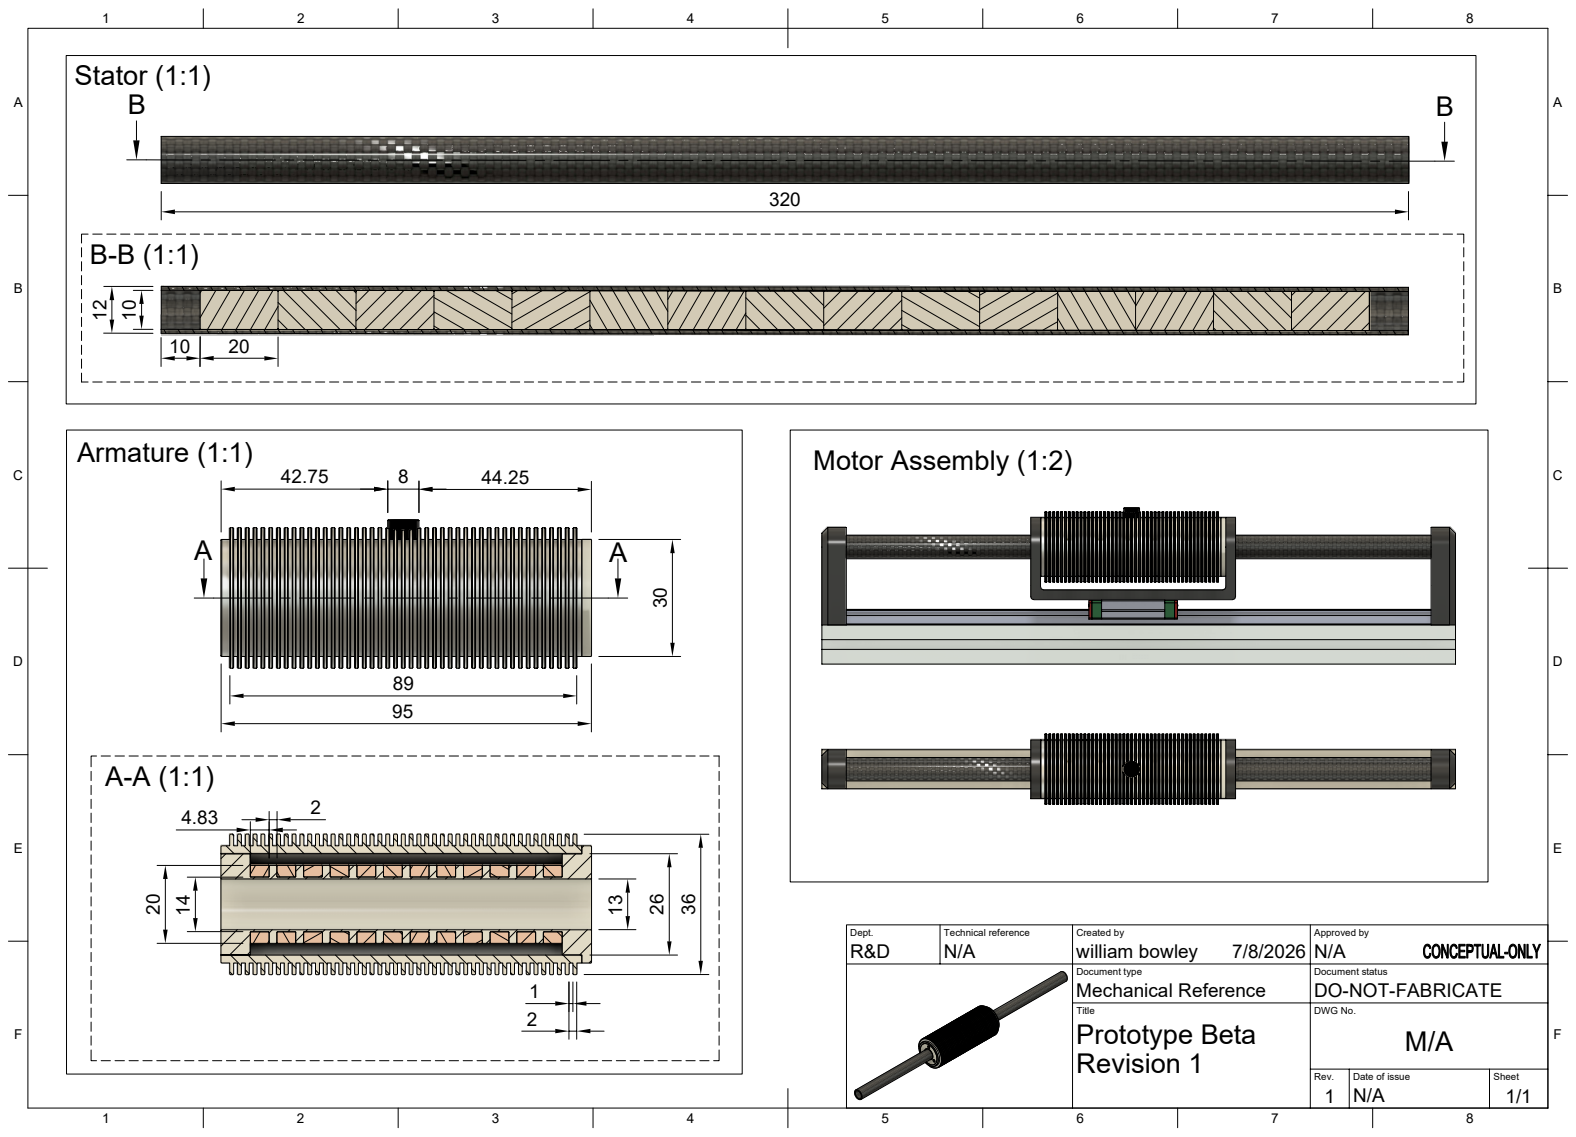
[picture p79: page 1]
8 BCDEF; ABCDEF Dept.; Technical reference; Created by; Approved by Document type; Document status Title; DWG No. Rev.; Date of issue; Sheet 1; N/A Mechanical Reference; DO-NOT-FABRICATE 7/8/2026; 1/1 Revision 1 Prototype Beta; william bowley

14 4.83 2 Armature (1:1) Motor Assembly (1:2) Stator (1:1)
