wgbowley/OpenLSM/02_motors/01_prototype_beta/rev_2/04_electrical/armature_phases_schematic.pdf

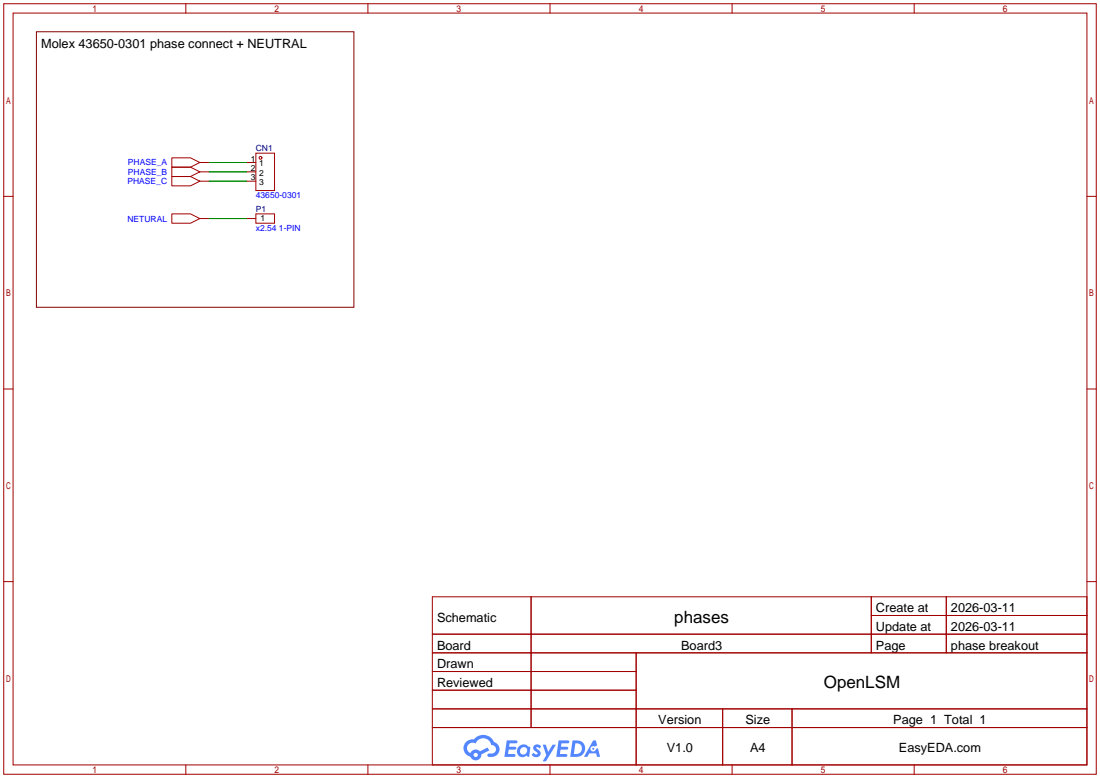
[picture p80: page 1]

Molex 43650-0301 phase connect + NEUTRAL

Schematic | phases | Create at | 2026-03-11

Update at | 2026-03-11

Board | Board3 | Page | phase breakout
Drawn | | OpenLSM
Reviewed

Version | Size | Page 1 Total 1
V1.0 | A4 | EasyEDA.com
