wgbowley/OpenLSM/02_motors/01_prototype_beta/rev_2/04_electrical/armature_wye_winding_schematic.pdf

A | A

1

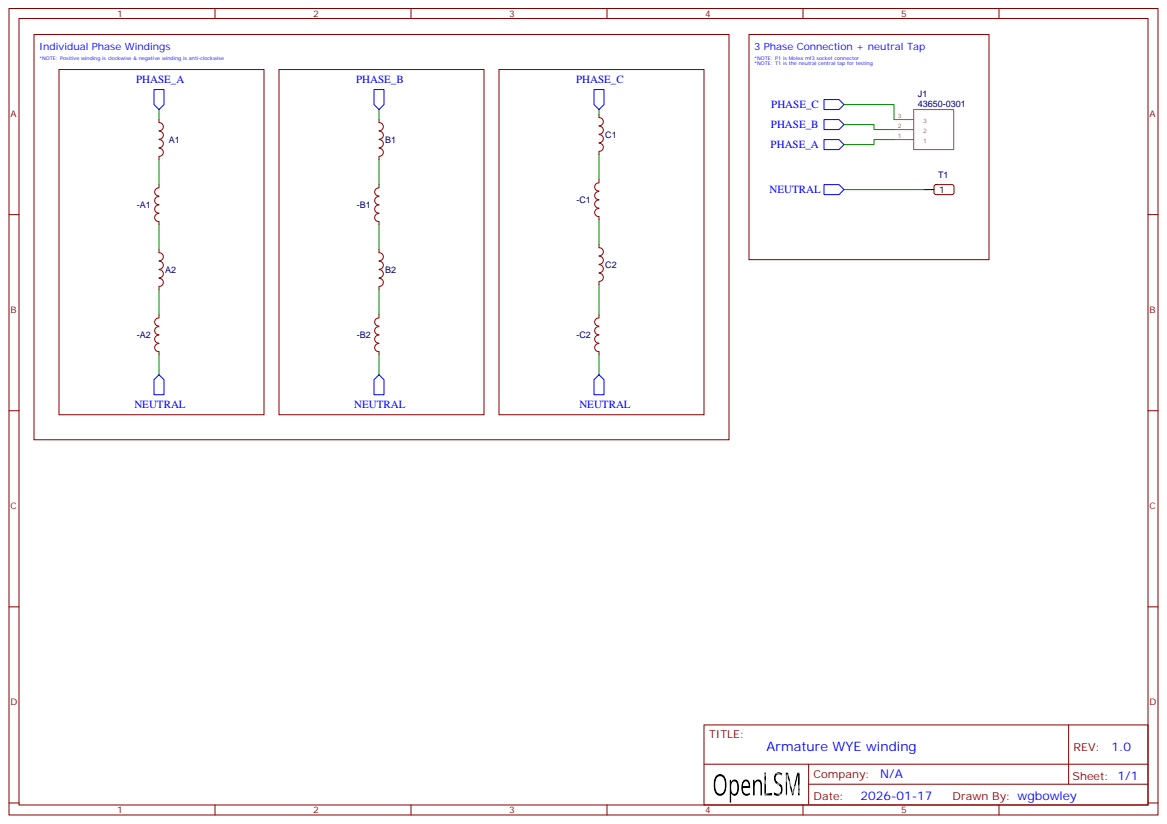
[picture p81: page 1]

3 Phase Connection + neutral Tap

*NOTE: Positive winding is clockwise & negative winding is anti-clockwise

*NOTE: P1 is Molex mf3 socket connector
*NOTE: T1 is the neutral central tap for testing
