wgbowley/OpenLSM/03_boards/00_bridge_driver/02_detailed_design/01_simulation/current_sensing/schematic.asc

L1: ind; 15mH
R1: res; 10m
R2: res; 24
R3: res; 1.3k
R4: res; 2k
U1: UniversalOpAmp
U2: INA241A2
V1: voltage; SINE(0 96 50)
V2: voltage; 3.3
V3: voltage; 12
Named nets: 0, A_IN+, A_IN-, ref_1, Out
.tran 1s
