wgbowley/OpenLSM/03_boards/00_armature_board/03_kicad/01_main/main.kicad_pcb

## KiCad design 03_boards/00_armature_board/03_kicad/01_main/main.kicad_pcb (2026-10-06)

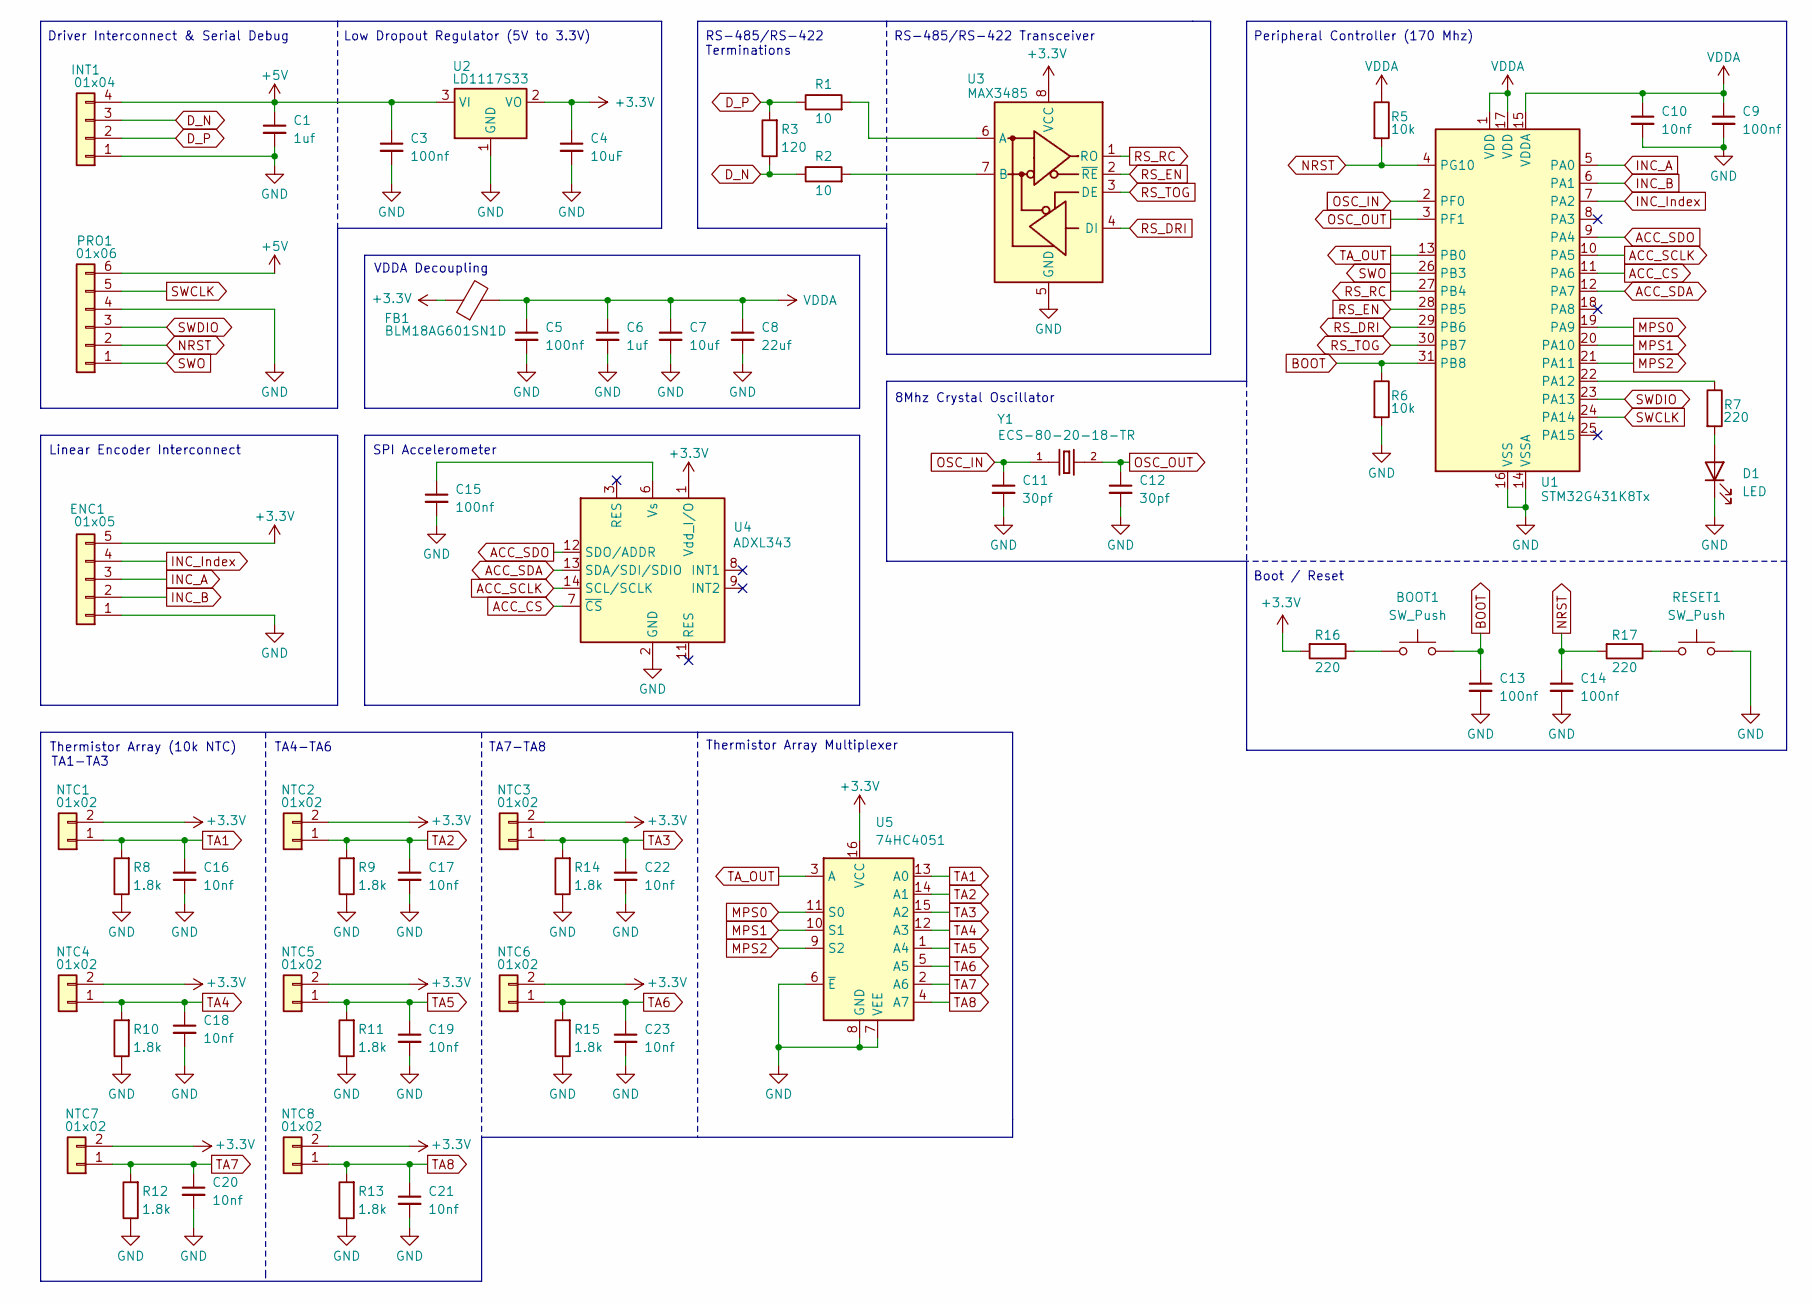
[picture p82: schematic main.kicad_sch, Armature Board]

Parts:
BOOT1: SW_Push; SW_Push_1P1T_NO_CK_KMR2
C1, C6: 1uf; C_0603_1608Metric
C3, C5, C9, C13, C14, C15: 100nf; C_0603_1608Metric
C4: 10uF; C_1206_3216Metric
C7: 10uf; C_1206_3216Metric
C8: 22uf; C_1206_3216Metric
C10, C16, C17, C18, C19, C20, C21, C22, C23: 10nf; C_0603_1608Metric
C11, C12: 30pf; C_0603_1608Metric
D1: LED; LED_0603_1608Metric_Pad1.05x0.95mm_HandSolder
ENC1: 01x05; JST_XH_B5B-XH-A_1x05_P2.50mm_Vertical
FB1: BLM18AG601SN1D; BEADC1608X95N
INT1: 01x04; JST_XH_B4B-XH-A_1x04_P2.50mm_Vertical
NTC1, NTC2, NTC3, NTC4, NTC5, NTC6, NTC7, NTC8: 01x02; JST_PH_B2B-PH-K_1x02_P2.00mm_Vertical
PRO1: 01x06; PinHeader_2x03_P2.54mm_Vertical
R1, R2: 10; R_0603_1608Metric
R3: 120; R_0603_1608Metric
R5, R6: 10k; R_0603_1608Metric
R7, R16, R17: 220; R_0603_1608Metric
R8, R9, R10, R11, R12, R13, R14, R15: 1.8k; R_0603_1608Metric
RESET1: SW_Push; SW_Push_1P1T_NO_CK_KMR2
U1: STM32G431K8Tx; LQFP-32_7x7mm_P0.8mm
U2: LD1117S33; SOT-223-3_TabPin2
U3: MAX3485; SOIC-8_3.9x4.9mm_P1.27mm
U4: ADXL343; LGA-14_3x5mm_P0.8mm_LayoutBorder1x6y
U5: 74HC4051; SSOP-16
Y1: ECS-80-20-18-TR; XTAL_ECS-80-20-18-TR; PARTREV 2/10

Connections:
+3.3V: C4.1, ENC1.5, FB1.1, NTC1.2, NTC2.2, NTC3.2, NTC4.2, NTC5.2, NTC6.2, NTC7.2, NTC8.2, R16.2, U2.2 (VO), U3.8 (VCC), U4.1 (Vdd_I/O), U5.16 (VCC)
+5V: C1.1, C3.1, INT1.4, PRO1.6, U2.3 (VI)
ACC_CS: U1.11 (PA6), U4.7 (~CS)
ACC_SCLK: U1.10 (PA5), U4.14 (SCL/SCLK)
ACC_SDA: U1.12 (PA7), U4.13 (SDA/SDI/SDIO)
ACC_SDO: U1.9 (PA4), U4.12 (SDO/ADDR)
BOOT: BOOT1.2, C13.1, R6.1, U1.31 (PB8)
D_N: INT1.3, R2.1, R3.1
D_P: INT1.2, R1.1, R3.2
GND: C1.2, C3.2, C4.2, C5.2, C6.2, C7.2, C8.2, C9.2, C10.2, C11.2, C12.2, C13.2, C14.2, C15.2, C16.2, C17.2, C18.2, C19.2, C20.2, C21.2, C22.2, C23.2, D1.1 (K), ENC1.1, INT1.1, PRO1.4, R6.2, R8.1, R9.1, R10.1, R11.1, R12.1, R13.1, R14.1, R15.1, RESET1.2, U1.14 (VSSA), U1.16 (VSS), U1.32 (VSS), U2.1 (GND), U3.5 (GND), U4.2 (GND), U4.4 (GND), U4.5 (GND), U5.6 (~E), U5.7 (VEE), U5.8 (GND)
INC_A: ENC1.3, U1.5 (PA0)
INC_B: ENC1.2, U1.6 (PA1)
INC_Index: ENC1.4, U1.7 (PA2)
MPS0: U1.19 (PA9), U5.11 (S0)
MPS1: U1.20 (PA10), U5.10 (S1)
MPS2: U1.21 (PA11), U5.9 (S2)
NRST: C14.1, PRO1.2, R5.2, R17.2, U1.4 (PG10)
unnamed: BOOT1.1, R16.1
unnamed: D1.2 (A), R7.2
unnamed: R17.1, RESET1.1
unnamed: R7.1, U1.22 (PA12)
unnamed: R1.2, U3.6 (A)
unnamed: R2.2, U3.7 (B)
unnamed: C15.1, U4.6 (Vs)
OSC_IN: C11.1, U1.2 (PF0), Y1.1, Y1.4
OSC_OUT: C12.1, U1.3 (PF1), Y1.2, Y1.3
RS_DRI: U1.29 (PB6), U3.4 (DI)
RS_EN: U1.28 (PB5), U3.2 (~RE)
RS_RC: U1.27 (PB4), U3.1 (RO)
RS_TOG: U1.30 (PB7), U3.3 (DE)
SWCLK: PRO1.5, U1.24 (PA14)
SWDIO: PRO1.3, U1.23 (PA13)
SWO: PRO1.1, U1.26 (PB3)
TA1: C16.1, NTC1.1, R8.2, U5.13 (A0)
TA2: C17.1, NTC2.1, R9.2, U5.14 (A1)
TA3: C22.1, NTC3.1, R14.2, U5.15 (A2)
TA4: C18.1, NTC4.1, R10.2, U5.12 (A3)
TA5: C19.1, NTC5.1, R11.2, U5.1 (A4)
TA6: C23.1, NTC6.1, R15.2, U5.5 (A5)
TA7: C20.1, NTC7.1, R12.2, U5.2 (A6)
TA8: C21.1, NTC8.1, R13.2, U5.4 (A7)
TA_OUT: U1.13 (PB0), U5.3 (A)
VDDA: C5.1, C6.1, C7.1, C8.1, C9.1, C10.1, FB1.2, R5.1, U1.1 (VDD), U1.15 (VDDA), U1.17 (VDD)

Notes on the sheet:
Peripheral Controller (170 Mhz)
Low Dropout Regulator (5V to 3.3V)
8Mhz Crystal Oscillator
TA1-TA3
RS-485/RS-422 Transceiver
Linear Encoder Interconnect
TA4-TA6
SPI Accelerometer
Thermistor Array (10k NTC)
RS-485/RS-422 Terminations
TA7-TA8
Driver Interconnect & Serial Debug
VDDA Decoupling
Boot / Reset
Thermistor Array Multiplexer

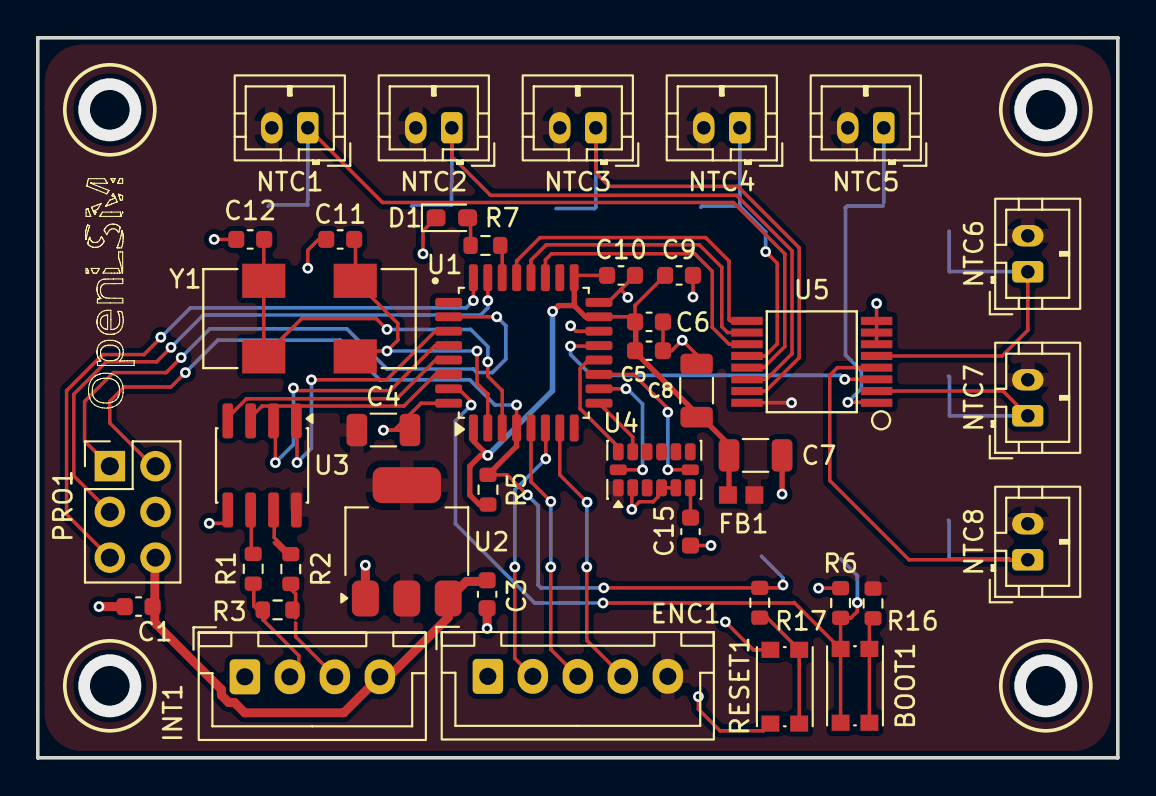
[picture p83: board 03_boards/00_armature_board/03_kicad/01_main/main.kicad_pcb from above]

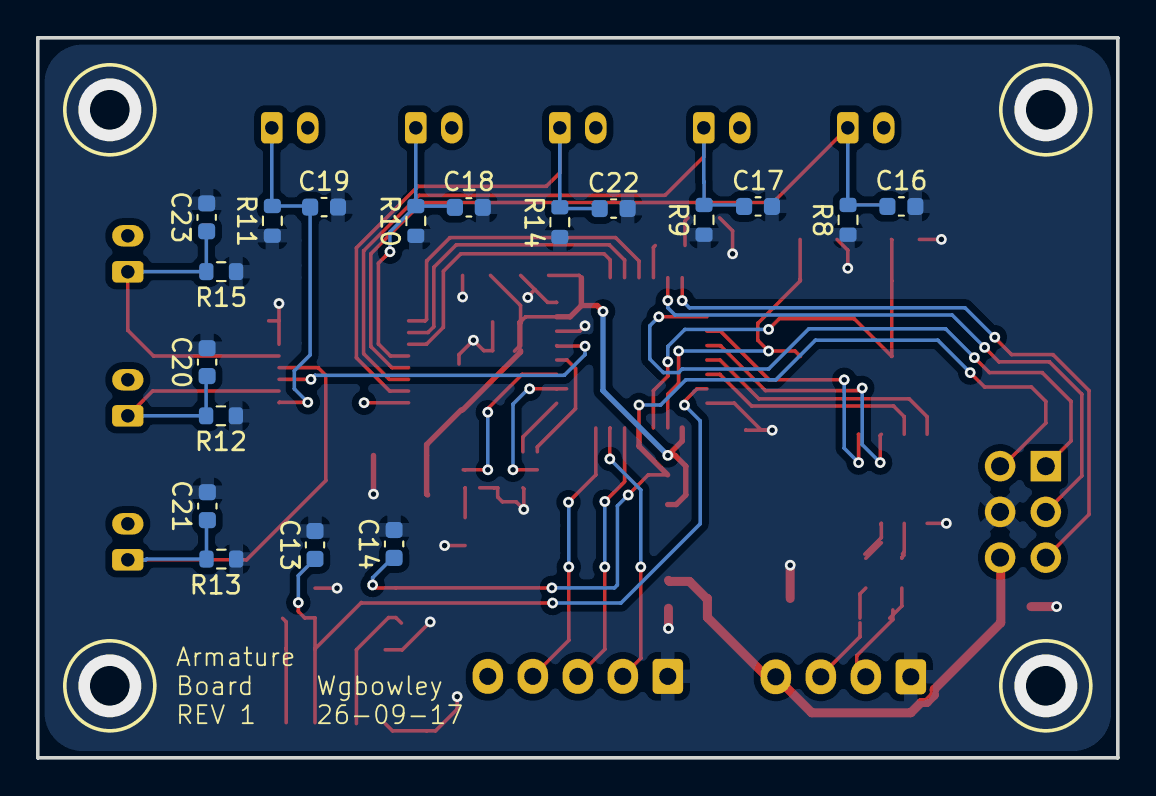
[picture p84: board 03_boards/00_armature_board/03_kicad/01_main/main.kicad_pcb from below]

Board: 2 copper layers, 60.0 x 40.0 mm, 59 parts (18 on the bottom side), 43 nets.
