wgbowley/OpenLSM/03_boards/03_teensy_SFOC/03_kicad/01_main/teensy_SFOC/teensy_SFOC.kicad_pcb

## KiCad design 03_boards/03_teensy_SFOC/03_kicad/01_main/teensy_SFOC/teensy_SFOC.kicad_pcb (2026-09-21)

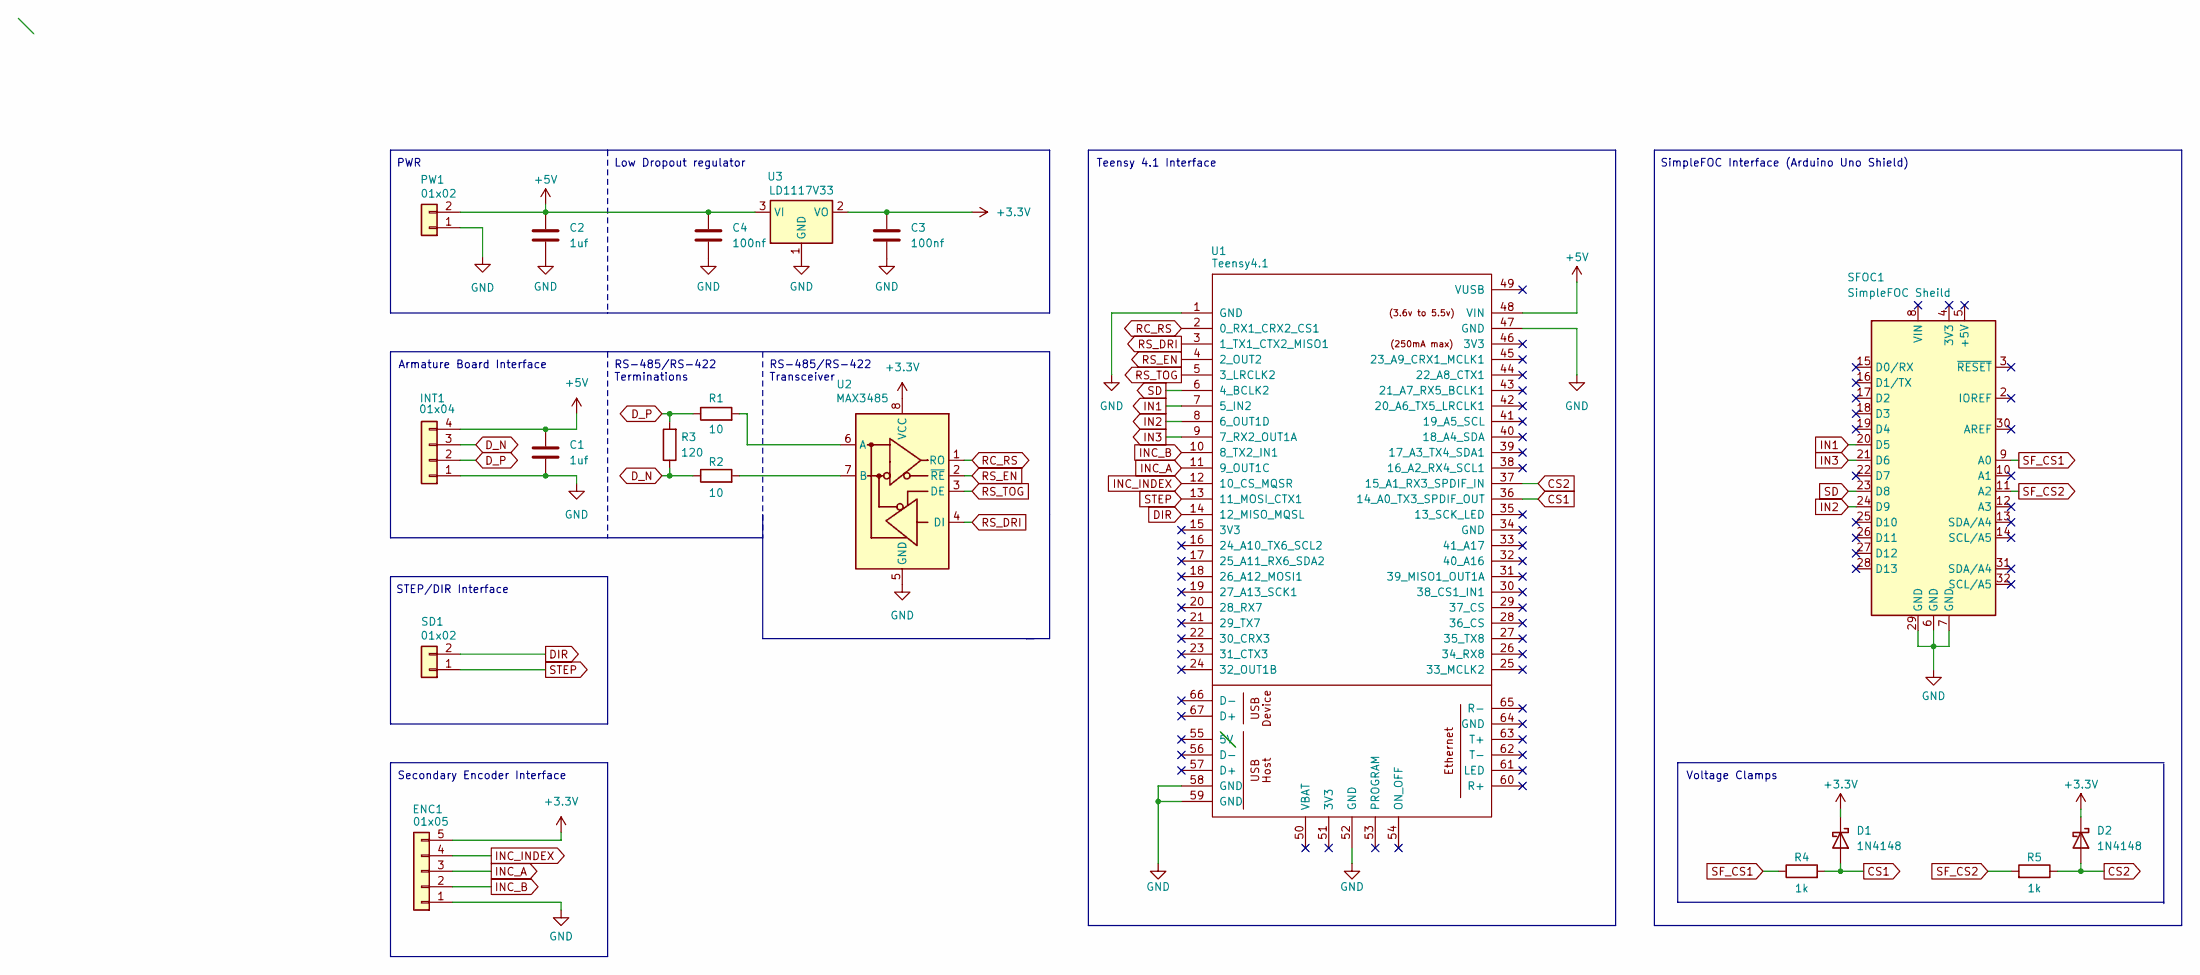
[picture p85: schematic teensy_SFOC.kicad_sch, TeensySFOC]

Parts:
C1, C2: 1uf; C_1206_3216Metric
C3, C4: 100nf; C_1206_3216Metric
D1, D2: 1N4148; D_SOD-123
ENC1: 01x05; JST_XH_B5B-XH-A_1x05_P2.50mm_Vertical
INT1: 01x04; JST_XH_B4B-XH-A_1x04_P2.50mm_Vertical
PW1: 01x02; JST_XH_B2B-XH-A_1x02_P2.50mm_Vertical
R1, R2: 10; R_1206_3216Metric
R3: 120; R_1206_3216Metric
R4, R5: 1k; R_1206_3216Metric
SD1: 01x02; JST_XH_B2B-XH-A_1x02_P2.50mm_Vertical
SFOC1: SimpleFOC Sheild; Arduino_UNO_R3
U1: Teensy4.1; Teensy41
U2: MAX3485; SOIC-8_3.9x4.9mm_P1.27mm
U3: LD1117V33; SOT-223-3_TabPin2

Connections:
+3.3V: C3.1, D1.1 (K), D2.1 (K), ENC1.5, U2.8 (VCC), U3.2 (VO)
+5V: C1.1, C2.1, C4.1, INT1.4, PW1.2, U1.48 (VIN), U3.3 (VI)
CS1: D1.2 (A), R4.2, U1.36 (14_A0_TX3_SPDIF_OUT)
CS2: D2.2 (A), R5.1, U1.37 (15_A1_RX3_SPDIF_IN)
DIR: SD1.2, U1.14 (12_MISO_MQSL)
D_N: INT1.3, R2.1, R3.1
D_P: INT1.2, R1.1, R3.2
GND: C1.2, C2.2, C3.2, C4.2, ENC1.1, INT1.1, PW1.1, SFOC1.6 (GND), SFOC1.7 (GND), SFOC1.29 (GND), U1.1 (GND), U1.47 (GND), U1.52 (GND), U1.58 (GND), U1.59 (GND), U2.5 (GND), U3.1 (GND)
IN1: SFOC1.20 (D5), U1.7 (5_IN2)
IN2: SFOC1.24 (D9), U1.8 (6_OUT1D)
IN3: SFOC1.21 (D6), U1.9 (7_RX2_OUT1A)
INC_A: ENC1.3, U1.11 (9_OUT1C)
INC_B: ENC1.2, U1.10 (8_TX2_IN1)
INC_INDEX: ENC1.4, U1.12 (10_CS_MQSR)
unnamed: R1.2, U2.6 (A)
unnamed: R2.2, U2.7 (B)
RC_RS: U1.2 (0_RX1_CRX2_CS1), U2.1 (RO)
RS_DRI: U1.3 (1_TX1_CTX2_MISO1), U2.4 (DI)
RS_EN: U1.4 (2_OUT2), U2.2 (~RE)
RS_TOG: U1.5 (3_LRCLK2), U2.3 (DE)
SD: SFOC1.23 (D8), U1.6 (4_BCLK2)
SF_CS1: R4.1, SFOC1.9 (A0)
SF_CS2: R5.2, SFOC1.11 (A2)
STEP: SD1.1, U1.13 (11_MOSI_CTX1)

Notes on the sheet:
Voltage Clamps
Secondary Encoder Interface
Armature Board Interface
RS-485/RS-422 Terminations
RS-485/RS-422 Transceiver
Teensy 4.1 Interface
STEP/DIR Interface
PWR
Low Dropout regulator
SimpleFOC Interface (Arduino Uno Shield)

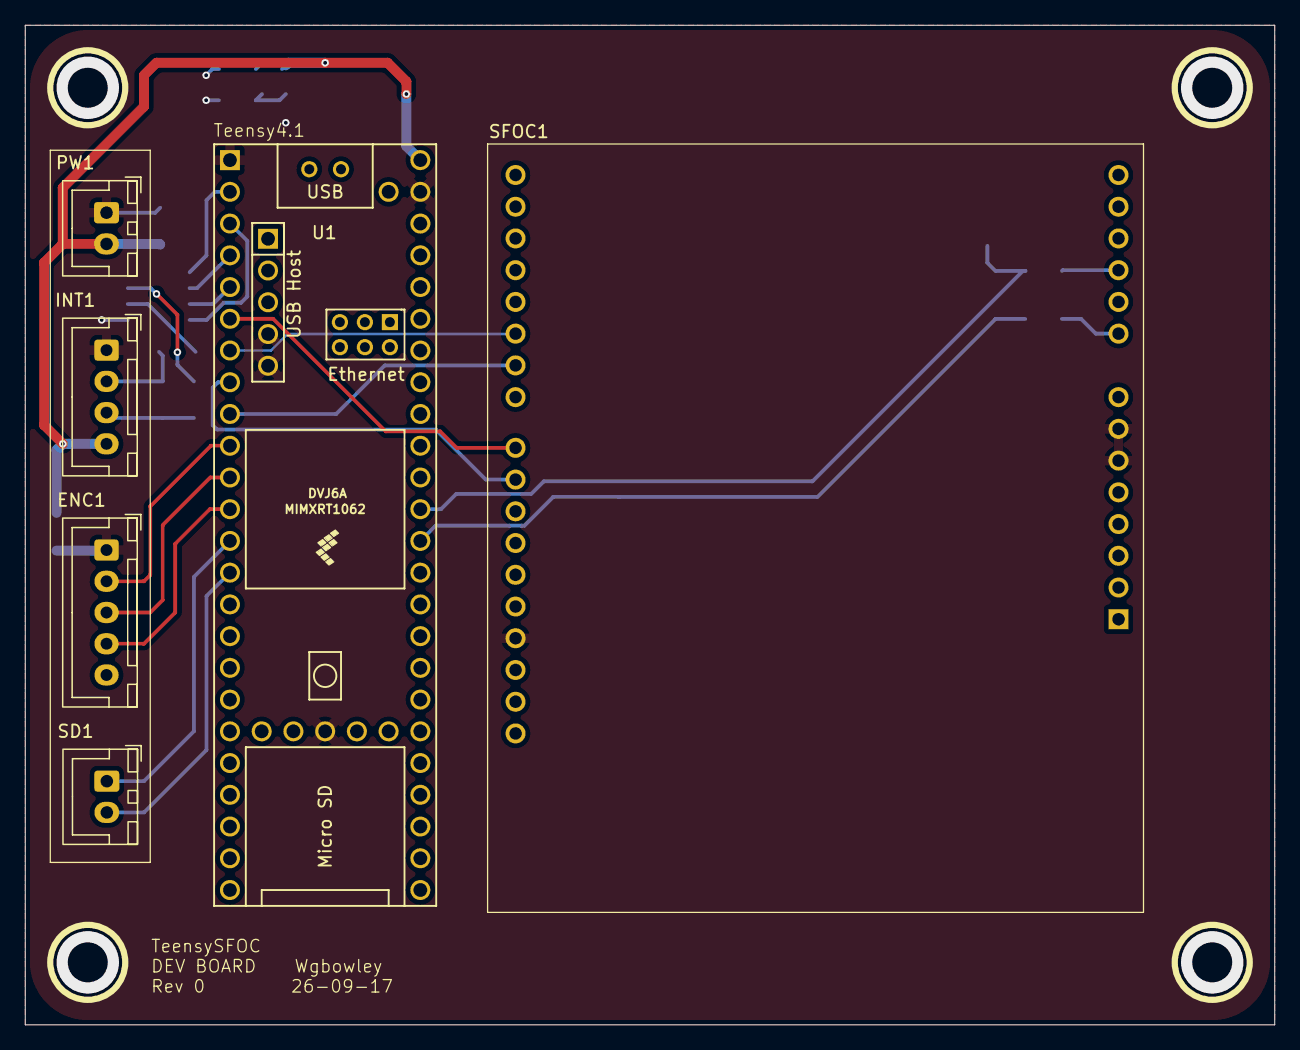
[picture p86: board teensy_SFOC.kicad_pcb from above]

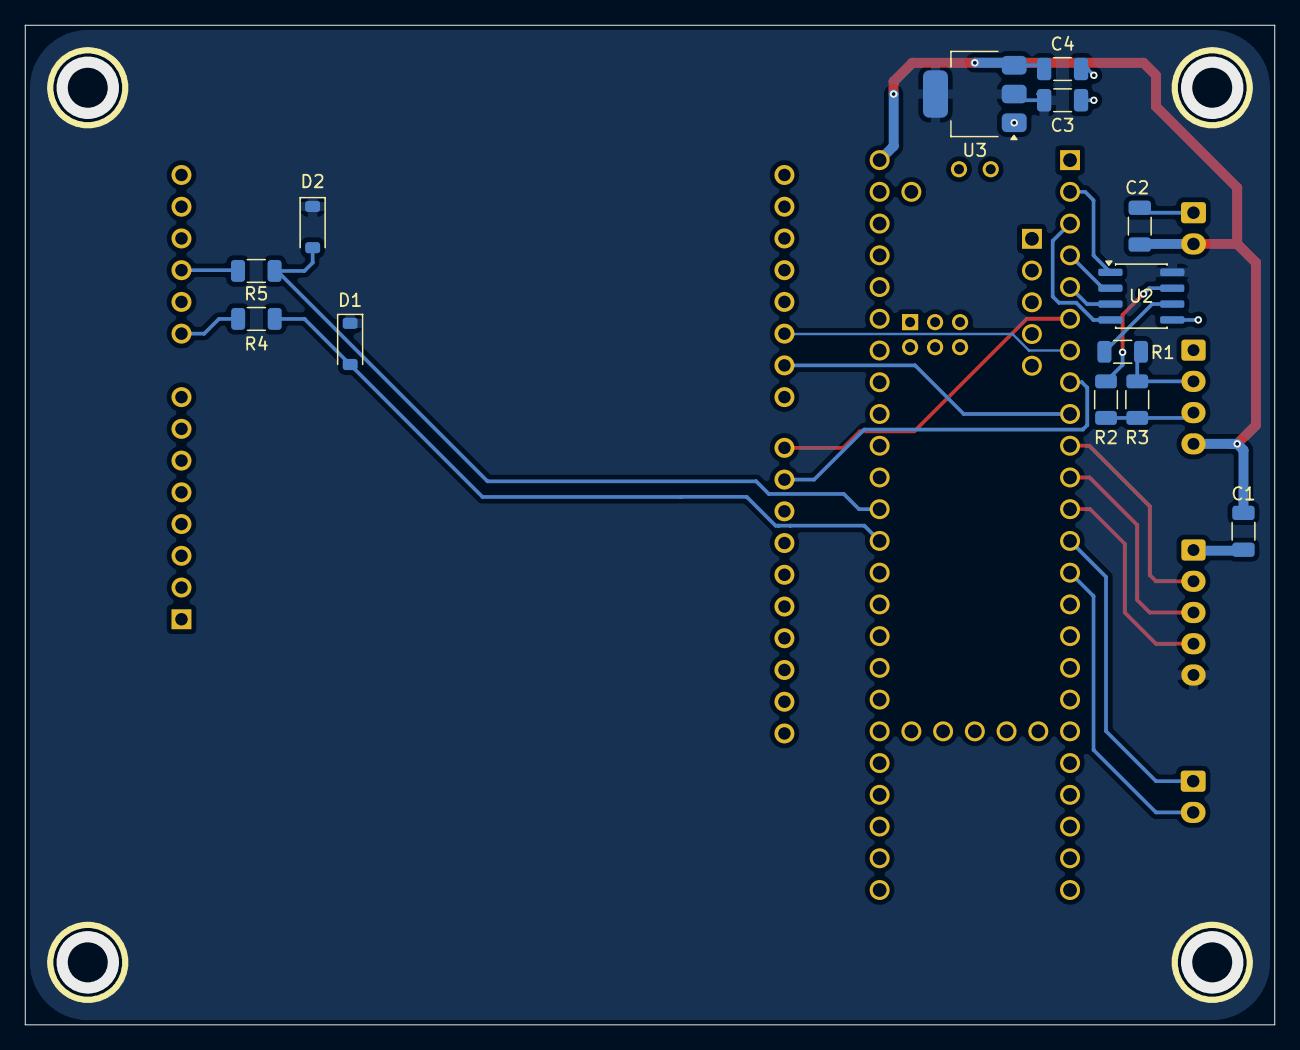
[picture p87: board teensy_SFOC.kicad_pcb from below]

Board: 2 copper layers, 100.0 x 80.0 mm, 19 parts (14 on the bottom side), 24 nets.
