wgbowley/OpenLSM/03_boards/00_bridge_driver/03_kicad/01_main/main.kicad_pcb

## KiCad design 03_boards/00_bridge_driver/03_kicad/01_main/main.kicad_pcb (2026-09-06)

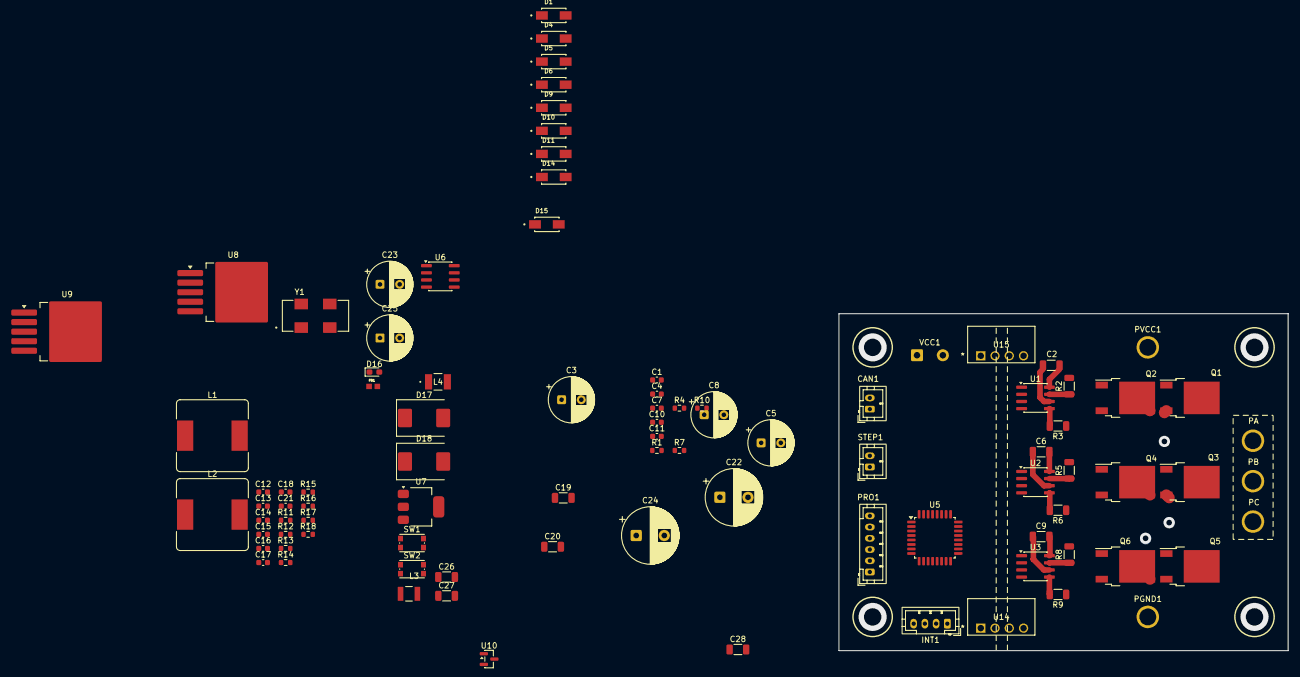
[picture p88: board 03_boards/00_bridge_driver/03_kicad/01_main/main.kicad_pcb from above]

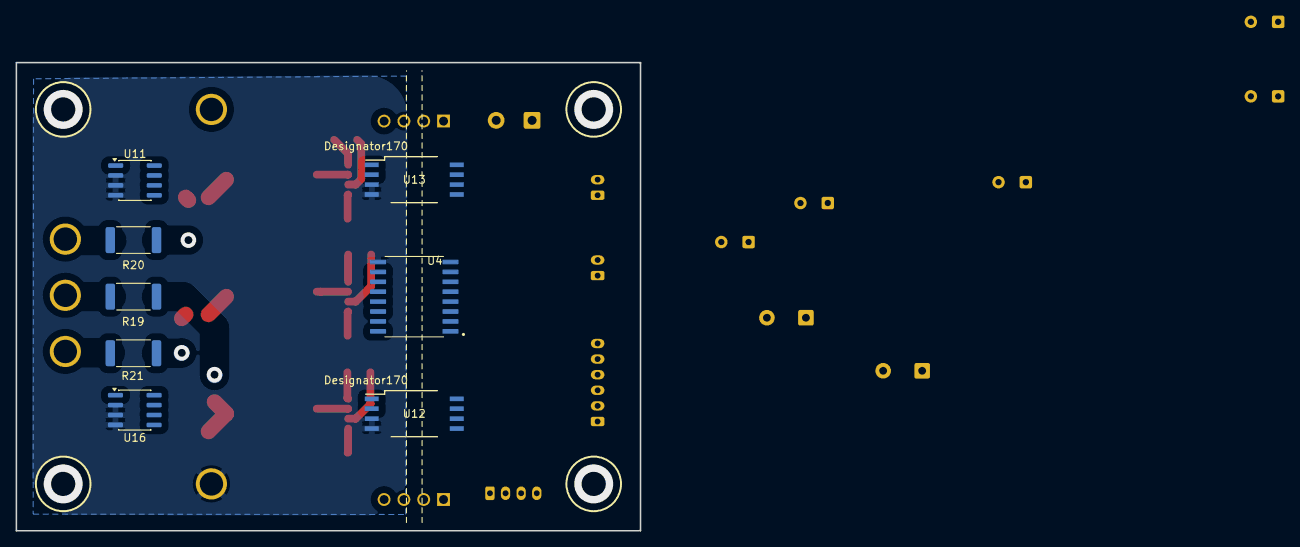
[picture p89: board 03_boards/00_bridge_driver/03_kicad/01_main/main.kicad_pcb from below]

Board: 4 copper layers, 80.0 x 60.0 mm, 99 parts (8 on the bottom side), 76 nets.

Parts:
C1, C4, C7, C10, C11: 1uF; C_0603_1608Metric
C2, C6, C9, C28: 10uF; C_1206_3216Metric
C3, C5, C8, C23, C25: 220uF; CP_Radial_D8.0mm_P3.50mm
C12, C13: 30pf; C_0603_1608Metric
C14, C15, C17, C21: 100nf; C_0603_1608Metric
C16: 10uf; C_0603_1608Metric
C18: 1uf; C_0603_1608Metric
C19: 10uf; C_1206_3216Metric
C20: 22uf; C_1206_3216Metric
C22, C24: 680uF; CP_Radial_D10.0mm_P5.00mm
C26: 0.68uF; C_1206_3216Metric
C27: 4.7uF; C_1206_3216Metric
CAN1: 01x02; JST_PH_B2B-PH-K_1x02_P2.00mm_Vertical
D1, D4, D5, D6, D9, D10, D11, D14, D15: ES1D; DIOM4325X250N
D16: LED; LED_0603_1608Metric_Pad1.05x0.95mm_HandSolder
D17, D18: 1N5824; D_SMC
FB1: BLM18AG601SN1D; BEADC1608X95N
INT1: 01x04; JST_PH_B4B-PH-K_1x04_P2.00mm_Vertical
L1: 33uH; L_Bourns_SRR1260
L2: 68uH; L_Bourns_SRR1260
L3: 82683C; FUSE_MF-USMFLAB
L4: 82103C; IND_8200_MUR
PGND1: Conn_01x01; SolderWire-2.5sqmm_1x01_D2.4mm_OD3.6mm
PH1: 01x03; SolderWire-2.5sqmm_1x03_P7.2mm_D2.4mm_OD3.6mm
PRO1: 01x06; JST_PH_B6B-PH-K_1x06_P2.00mm_Vertical
PVCC1: Conn_01x01; SolderWire-2.5sqmm_1x01_D2.4mm_OD3.6mm
Q1, Q2, Q3, Q4, Q5, Q6: SUD90330E; TO-252-2
R1, R4, R7: 5; R_0603_1608Metric
R2, R3, R5, R6, R8, R9: 47; R_1206_3216Metric
R10: 4.7k; R_0603_1608Metric
R11: 120; R_0603_1608Metric
R12, R13: 10; R_0603_1608Metric
R14, R15, R18: 220; R_0603_1608Metric
R16, R17: 10K; R_0603_1608Metric
R19, R20, R21: 5mOhm; R_2512_6332Metric
STEP1: 01x02; JST_PH_B2B-PH-K_1x02_P2.00mm_Vertical
SW1, SW2: SW_Push; SW_Push_1P1T_NO_CK_KMR2
U1, U2, U3: IRS2104; SOIC-8_3.9x4.9mm_P1.27mm
U4: ISO7740DWR; SOIC127P1030X265-16N
U5: STM32G431K8Tx; LQFP-32_7x7mm_P0.8mm
U6: MAX3485; SOIC-8_3.9x4.9mm_P1.27mm
U7: LD1117V33; SOT-223
U8: LM2596S-5; TO-263-5_TabPin3
U9: LM2596S-12; TO-263-5_TabPin3
U10: REF3020; SOT-23
U11, U16: INA241A2xD; SOIC-8_3.9x4.9mm_P1.27mm
U12, U13: AMC1311; DWV0008A
U14: CME0512S3C; CME_SC_MUR
U15: CME0303S3C; CME_SC_MUR
VCC1: 01x02; SolderWire-0.5sqmm_1x02_P4.6mm_D0.9mm_OD2.1mm
Y1: ECS-80-20-18-TR; XTAL_ECS-80-20-18-TR

Connections:
+3.3V: C11.1, C16.1, FB1.1, R14.1, U4.1 (VCC1), U6.8 (VCC), U7.2 (VO), U12.8 (VDD2), U13.8 (VDD2)
+3.3VIS: C10.1, C26.1, C28.1, L3.2, R10.1, U4.16 (VCC2), U10.1 (IN), U12.1 (VDD1), U13.1 (VDD1)
+5V: C21.1, C23.1, INT1.4, L1.2, PRO1.6, U7.3 (VI), U8.4 (FB), U14.2 (+VIN)
+12V: C22.1, C25.1, L2.2, U8.1 (VIN), U9.4 (FB), U15.2 (+VIN)
+12VIS: C1.1, C3.1, C4.1, C5.1, C7.1, C8.1, C27.1, L4.1, R1.1, R4.1, R7.1, U1.1 (VCC), U2.1 (VCC), U3.1 (VCC), U11.6 (V+), U16.6 (V+)
+24V: C24.1, U9.1 (VIN), VCC1.2
+CAN: CAN1.2, U5.12 (PA7)
+STEP: STEP1.2, U5.19 (PA9)
-CAN: CAN1.1, U5.18 (PA8)
-STEP: STEP1.1, U5.20 (PA10)
A_IN+: Q1.2 (S), Q2.3 (D), R20.1, U11.8 (+)
A_IN-: PH1.3, R20.2, U11.1 (-)
BOOT: C14.1, R17.1, SW1.2, U5.31 (PB8)
CS1+: U5.6 (PA1), U12.7 (VOUTP)
CS1-: U5.7 (PA2), U12.6 (VOUTN)
CS2+: U5.8 (PA3), U13.7 (VOUTP)
CS2-: U5.9 (PA4), U13.6 (VOUTN)
CS_REF: U10.2 (OUT), U11.7 (REF1), U16.7 (REF1)
C_IN+: Q3.2 (S), Q4.3 (D), R21.1, U16.8 (+)
C_IN-: PH1.1, R21.2, U16.1 (-)
DIN1: U1.2 (IN), U4.14 (OUTA)
DIN2: U2.2 (IN), U4.13 (OUTB)
DIN3: U3.2 (IN), U4.12 (OUTC)
DRI_ENA: U4.6 (IND), U5.13 (PB0)
DSD: U1.3 (~SD), U2.3 (~SD), U3.3 (~SD), U4.11 (OUTD)
D_N: INT1.2, INT1.3, R11.2, R13.1
D_P: R11.1, R12.1
GND: C11.2, C12.2, C13.2, C14.2, C15.2, C16.2, C17.2, C18.2, C19.2, C20.2, C21.2, C22.2, C23.2, C24.2, C25.2, D16.1 (K), D17.2 (A), D18.2 (A), INT1.1, PRO1.4, R17.2, SW2.2, U4.2 (NHLND), U4.8 (V-1), U5.14 (VSSA), U5.16 (VSS), U5.32 (VSS), U6.5 (GND), U7.1 (GND), U8.3 (GND), U8.5 (~ON/OFF), U9.3 (GND), U9.5 (~ON/OFF), U12.5 (GND2), U13.5 (GND2), U14.1 (-VIN), U15.1 (-VIN), VCC1.1
NRST: C15.1, PRO1.2, R15.1, R16.2, U5.4 (PG10)
unnamed: C2.1, U1.8 (VB)
unnamed: C6.1, U2.8 (VB)
unnamed: C9.1, U3.8 (VB)
unnamed: D16.2 (A), R18.2
unnamed: D17.1 (K), L1.1, U8.2 (OUT)
unnamed: D18.1 (K), L2.1, U9.2 (OUT)
unnamed: Q1.1 (G), R2.2
unnamed: Q2.1 (G), R3.1
unnamed: Q3.1 (G), R8.2
unnamed: Q4.1 (G), R9.1
unnamed: Q5.1 (G), R5.2
unnamed: Q6.1 (G), R6.1
unnamed: R14.2, SW1.1
unnamed: R15.2, SW2.1
unnamed: R2.1, U1.7 (HO)
unnamed: R3.2, U1.5 (LO)
unnamed: C2.2, U1.6 (VS)
unnamed: R5.1, U2.7 (HO)
unnamed: R6.2, U2.5 (LO)
unnamed: C6.2, U2.6 (VS)
unnamed: R8.1, U3.7 (HO)
unnamed: R9.2, U3.5 (LO)
unnamed: C9.2, U3.6 (VS)
unnamed: R10.2, U4.10 (EN2)
unnamed: R18.1, U5.22 (PA12)
unnamed: R12.2, U6.6 (A)
unnamed: R13.2, U6.7 (B)
unnamed: U11.5, U12.2 (VINP)
unnamed: U13.2 (VINP), U16.5
unnamed: L3.1, U14.4 (+VOUT)
unnamed: L4.2, U15.4 (+VOUT)
OSC_IN: C12.1, U5.3 (PF1), Y1.1, Y1.4
OSC_OUT: C13.1, U5.2 (PF0), Y1.2, Y1.3
PB: PH1.2, R19.2
PB_CS: Q5.2 (S), Q6.3 (D), R19.1
PGND: C1.2, C3.2, C4.2, C5.2, C7.2, C8.2, C10.2, C26.2, C27.2, C28.2, PGND1.1 (Pin_1_1), Q2.2 (S), Q4.2 (S), Q6.2 (S), U1.4 (COM), U2.4 (COM), U3.4 (COM), U4.9 (NNLNN), U4.15 (V), U10.3 (GND), U11.2 (GND), U11.3 (REF2), U11.4 (GND), U12.3 (SD), U12.4 (GND1), U13.3 (SD), U13.4 (GND1), U14.3 (-VOUT), U15.3 (-VOUT), U16.2 (GND), U16.3 (REF2), U16.4 (GND)
PHA_PWM: U4.3 (INA), U5.21 (PA11)
PHB_PWM: U4.4 (LNB), U5.10 (PA5)
PHC_PWM: U4.5 (INC), U5.25 (PA15)
PVCC: PVCC1.1 (Pin_1_1), Q1.3 (D), Q3.3 (D), Q5.3 (D)
RS_DRI: U5.29 (PB6), U6.4 (DI)
RS_RC: U5.27 (PB4), U5.28 (PB5), U6.1 (RO)
RS_TOG: U5.30 (PB7), U6.3 (DE)
SWCLK: PRO1.5, U5.24 (PA14)
SWDIO: PRO1.3, U5.23 (PA13)
SWO: PRO1.1, U5.26 (PB3)
VDDA: C17.1, C18.1, C19.1, C20.1, FB1.2, R16.1, U5.1 (VDD), U5.15 (VDDA), U5.17 (VDD)
