wgbowley/OpenLSM/03_boards/02_magnetic_encoder/03_kicad/01_main/main.kicad_sch

## KiCad design 03_boards/02_magnetic_encoder/03_kicad/01_main/main.kicad_sch (2026-07-26)

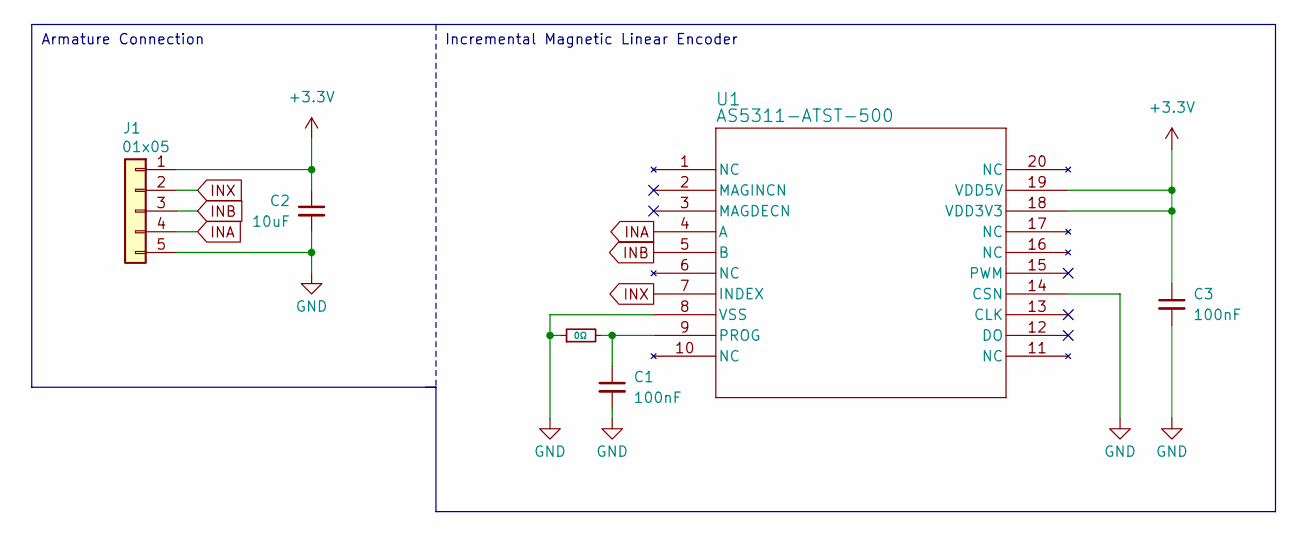
[picture p92: schematic main.kicad_sch]

Parts:
C1, C3: 100nF; C_0402_1005Metric
C2: 10uF; C_1206_3216Metric
J1: 01x05; JST_XH_B5B-XH-A_1x05_P2.50mm_Vertical
R1: 0Ω; R_0402_1005Metric
U1: AS5311-ATST-500; TSSOP20_AS5311-ATST-500_AMS

Connections:
+3.3V: C2.1, C3.1, J1.1, U1.18 (VDD3V3), U1.19 (VDD5V)
GND: C1.2, C2.2, C3.2, J1.5, R1.1, U1.8 (VSS), U1.14 (CSN)
INA: J1.4, U1.4 (A)
INB: J1.3, U1.5 (B)
INX: J1.2, U1.7 (INDEX)
unnamed: C1.1, R1.2, U1.9 (PROG)

Notes on the sheet:
Armature Connection
Incremental Magnetic Linear Encoder
