wgbowley/OpenLSM/(commit log)

2025-10-10 Correction & Removal of Results
    - According to Lawson, Klippy is the correct application layer for close loop control. Whereas klipper is too high level.
    - Removal of DEAP + BlueShark results from the readme as the inductance values are numerically unstable. And hence, the time constant cannot be considered correct.
2026-02-11 WIP Save: components and calculations for armature data board
2026-02-12 Quick Save: Semi-working transient analysis of prototype 1
2026-02-15 WIP: Coupling dq axis instead of direct df/dt for coupling. Should in theory improve stability
2026-02-23 Simulation works reasonability well under current assumptions
2026-02-26 ref my direction lmao. hopefully 0.5 A will remove any possible weighting towards high resistance. Also lower velocity might mess everything up ngl
2026-02-27 save before parametric refactor for more solver input variables
    [old_motor.csv]
2026-02-27 updates before relaunch
    [old_motor.csv]
2026-03-09 saving before updates to modelling for final simulation tests.
    [motor.csv]
2026-03-10 quick save don't want to loss data yk
    [50mm_200mm_s_10000mm_s2.csv, motor.csv]
2026-03-10 moving to detailed design and modelling in CAD
    [motor_base_geometry.dxf, raw_pyfea_export.dxf]
2026-03-12 more design work
    [motor_base_geometry.dxf]
2026-04-01 initial docs added for prototype 1. Just general docs
    [motor.csv, motor_base_geometry_rev_1.dxf, raw_pyfea_export_rev_1.dxf, raw_pyfea_export_rev_2.dxf, rev1_50mm_200mm_s_10000mm_s2.csv]
2026-04-17 Reorganizing / restructuring to ensure good boundaries between systems
    [motor.csv, motor_base_geometry_rev_1.dxf, raw_pyfea_export_rev_1.dxf, raw_pyfea_export_rev_2.dxf, rev1_50mm_200mm_s_10000mm_s2.csv]
2026-04-19 work in progress: actuation comparison docs
    [motor.csv]
2026-04-21 Removed vague claims and emphasised experimental nature
    Updated project description to reflect focus on low-cost linear motors for 3D printing applications. Adjusted prototype performance metrics and next steps for clarity.
2026-05-29 reordering and readme rewrite
    [FLSM V0.iges]
2026-05-29 updated side view image of prototype alpha
2026-07-04 Repository reorganisation and legacy cleanup (#16)
    * Reorganising repo and starting README improvements
    * added new banner and added a ASCII methodology section
    * Adding figures numbers & names.
    * removing note for documentation -> just move through the repository tree
    * few additions to prototype alpha section
    * Add CAD and electrical files for all motor prototypes
    * deprecated computational models & removing placeholders.
    * adding parameters files for each motor & for quasi-static simulation
    * readme and credits first draft.
    * fixing credit link
    * correction of noting it as a hypothesis
    * Adding schematics & updating readmes.
    [FLSM V0.iges, cad_export.step, cad_native.f3z, motor_base_geometry_rev_1.dxf, raw_pyfea_export_rev_1.dxf, raw_pyfea_export_rev_2.dxf, rev1_50mm_200mm_s_10000mm_s2.csv]
2026-07-12 Week 0x1 merge (#18)
    * removing pointless additions to .gitignore
    * Prototype Alpha images & Reordering cSpell.json
    * mechanical reference for revision 2
    * Prototype reference & images
    * Thermal interface material needs to be looked into.
    * Updated schematics with similar semantics
    * moving prototype beta revision 1 to correct location
    * Prototype Alpha readme finished & added conceptual only to revision 2 of prototype beta
    * Design notes for prototype beta revision 1
    * Updated Warning labels for prototype alpha & Prototype Beta
    * Initial setup for 00_reduced_order_model
2026-07-19 Week 0x2 merge (#22)
    * Derived parameters & motor equations for reduced order model.
    * Stator field method
    * Added states and started work on the model.
    * removed poor boundary abstraction & added units symbols to states
    * Finished model construction moving to writing solver.
    * Removing note about simulation from bet_rev_1, bet_rev_2 & alp_design
    * Added Magnetic Solver and changed parameter set to a machine similar to cmore design
    * Replaced mean_area with effective air gap area
    * Improvements to stator field modelling.
2026-07-26 Week 0x3 merge - Maxwell 3:14 | ∇·Pipelines = 0 :? (#24)
    * Begin KiCAD design of linear encoder board & restructured
    * Finished Draft Linear Motor Encoder Schematic & Moved metric.ut to root for easier access across the repo
    * Finished Validation & PCB for Magnetic Encoder Board
    * Updated PCB for better mounting & also renamed reference in motor driver.
    * Improvement Mounting & Added note on CL
    * Reorganizing 01_datasheets for armature board
    * Finished draft armature board schematic & Moving to validation
    * Schematic validation done moving to documentation before pcb
    * Fixed capacitor alignment in schematic
    * Validation finished & initial pre-pcb documentation done
    * Update arma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
    [20-pin_TSSOP_.step, BLM18AG601SN1D.step, ECS-80-20-18-TR.step, IR2104SPBF.STEP, SSOP16.STEP, TO252.step, main.kicad_pcb, main.kicad_sch]
2026-08-02 Week 0x4 - Spatial ROMs are hard.... (#25)
    * Reference document with bootstrap selection calculations
    * Boot strap capacitors, resistors and diode work for triple half bridge driver
    * Few small changes to reduced order model
    * Reduced order model under FOC control
    * Finished initial reduced order model
    * Custom motor model that needs to be validated and graphs
    * Rename to 00_reduced_order_model and Updated readme.md
    * Few changes to the model model & Selected Boot Diodes
    * Began work on the refactored reduced order model
    * New parameter file, removed library and added derived equations
    * Initial draft of reduced order model
    * Moving pole equation around. Solver not working.
    * Iss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
    [Drivers.kicad_sch, main.kicad_sch]
2026-08-09 Week 0x5 -> Electromagnetic Modelling is hard (#27)
    * Adding initial structure for revision 3
    * Replaced important with warning for reduced order model
    * Initial layout for finite element code
    * Initial parameter structure for finite element
    * Material imports and derived parameters for pcb armature
    * Initial parametric geometry done
    * PCB armature magnetics rendering
    * Parametric model work in progress
    * Ordered a few circuit boards
2026-08-16 Week 0x6 | Hardware is finally into the pipeline?! (#29)
    * Removed Citation
    * Update tooling acknowledgements in credits.md
    Updated links for PicoUnits, PyFEA, and UIV Language to reflect new repository locations. Added KiCad acknowledgment and removed EasyEDA.
    * Removed video demo as the quality to too poor.
    * Changed color pattern for shields
    * Fixed logo pattern mistake
    * Update project description in README
    * Refactor Prototype Alpha section in readme.md
    Removed duplicate description of Prototype Alpha motor and its image.
    * Update readme.md
    * Update readme.md
    * Update readme.md
    * Few note changes to OpenLSM
    * Exported auto BOM from KiCAD for armature and encoder boards.
    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
    [BOM.csv]
2026-08-23 Week 0x7 | Streamlining deliverables (#31)
    * Updated links and added note to BOM
    * Fixed links
    * Triple bridge driver layout
    * Updated the readmes a bit and moved the analytical to 00_analytical
    * Added notes about revision 3
    * Added note about quality of the images
    * Noted that prototype beta revision 2 is specifically not for fabrication.
    * Added a note about revision 3
    * Added break line
    * Moved contributors and credits to /04_docs and also updated > sections
    * Restructured the simulation section and simplified deliverables
    * Improved documentation section at the bottom of the readme and improved 04_docs
    * Updated readme.md
    * Removed note.
    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
    [BOM.csv, Drivers.kicad_sch, ECS-80-20-18-TR.step, ISO7740DWR.step, main.kicad_sch]
2026-08-30 Week 0x8 | Simulation & Objectives (#34)
    * Reordered motor folder and rewrote / cleaned up readmes within motors, boards and simulations
    * Updated readme logo size
    * Made logo 100% width
    * Update scaled logo and removed finite element from readme
    * Removed objectives
    * Removed FEM from readme
    * Removed Methodology
    * Added a line break before prototype alpha image. Also removed figure naming from the document
    * Trying a new formatting technique
    * Moved boards link below image
    * Removed `REV 2` from image description as its not needed
    * Removing overview to see if its good or not
    * Trying a new formatting style
    * Removed the top line section
    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
    [BLM18AG601SN1D.step, Drivers.kicad_sch, ECS-80-20-18-TR.step, cad_export.step, cad_native.f3z, current.kicad_sch, main.kicad_pcb, main.kicad_sch]
2026-09-06 Week 0x9 | Nearly there! (#38)
    * Updated readmes formatting & other files
    * Removed no commercial aspiration notes and added a simple status section for the readme
    * Made the status section inline
    * Forgot a full stop.
    * Added application notes to docs/readme.md
    * Added current state and terminal state on the application notes series
    * Added .md instead of .csv for BOM
    * Added BOM for bridge driver and updated the - to em
    * Added 04_procurement folders and made 04_media into 05_media
    * Added fixture folder and moved docs to 00
    * Technically I have done that just by the bridge driver design.
    * Added checking system for BOM and added 05_media section for bridge driver
    * Added the o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
    [82683C.step, BOM.csv, Drivers.kicad_sch, ES1D.step, current.kicad_sch, digikey.csv, main.kicad_pcb, main.kicad_sch]
2026-09-13 Week 0xA | Populating PCBs (#40)
    * Update project status badge in README
    * Added the .step for the boards.
    * Initial conceptual design of the fixture frame.
    * Adding images and updating documentation
    * Added line breaks for indexation
    * Made it rms & dc so its obvious.
    * Updated links.
    * Updated html
    * Updated bridge driver note
    [armature_board.step, conceptual.step, encoder_board.step, main.kicad_pcb]
2026-09-21 Week 0xB | TeensySFOC & began work on hybrid model. (#44)
    * Initial work on TeensySFOC board
    * Added SFOC readme
    * Schematic and referencing in the readme
    * TeensySFOC & Armature REV 1
    * Updated readme
    * Few changes.
    * Updated sub-readme
    * Breakout not integration
    * Added note.
    * Update README.md
    * Update README.md
    * Deleted concenptual design
    * Removed old driver pcb images from readme
    * Update README.md
    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
    [Female_Header_1x10_P2.54_H8.5_straight.step, Female_Header_1x24_P2.54_H8.5_straight.step, Female_Header_1x6_P2.54_H8.5_straight.step, Female_Header_1x8_P2.54_H8.5_straight.step, conceptual.step, main.kicad_pcb, main.kicad_sch, rev0_armature_board.step]
2026-09-29 Week 0xC | Started work on hybrid model. (#48)
    * Added Empty BOM to TeensySFOC
    * Initial integral test for openLSM
    * Fixing title for bibtex
    * Initial work on hybrid model & rework of cSpell.json
    * Adds initial structure for hybrid model
    * Parameteric helix equations
    * Biot sum integrand
    * Initial entry points for doing the more complex analysis.
    * Removed placehoders for b_layer & b_slot
    * Edited BOM & added image of teensySFOC to readme.md
    * Made boards smaller on the main readme.
    * Fixing image formatting
    * BOM for teensySFOC & armature board.
    * Moved driver board to the bottom of boards section
    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
    [digikey.csv]
2026-10-01 Update voltage bus range support in README
2026-10-06 Week OxD | Validation setup & modelling.
    * Updated parameter file.
    * Initial work on the hybrid solver & removed initial test of ifemm
    * Derived parameter for model.
    * Setting color to green for armature board & updating models for fixtures.
    * Improving .md files routing.
    * Delete rev0_armature_board.step
    * Update voltage bus range support in README (#50)
    * Checking parameters!?
    * More work on the hybrid model.
    * Per slot helix & derivative
    * More hybrid model work
    * Initial integration & test solution
    * Weekly updates.
    * Update initial-integration.jpg
    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
    [main.kicad_pcb, main.step, rev0_armature_board.step, rev0_encoder_board.step, rev0_teensySFOC.step, rev1_armature_board.step]
2026-10-13 Week 0xE | Field Equations Are Hard!? (#54)
    * Descoped the bridge driver.
    * Removed beta revision 2 from main readme.md
    * Removing biot savart code for now.
    * Removed incorrect procurement from teensySFOC
    * Just to make it cleaner
    * Bit more mathematics.
    * Work In progress still.
    * More hybrid modelling work.
    * Removing note for now.
    * Updated objectives.
    * Removing beta from readme for now.
    * Started work on computing the kernel.
    * Updated formatting and fixes to hybrid model.
    * Added .ans solution for example usage.
    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
2026-10-18 Week 0xF | Thermodymaics is interesting!? (#59)
    * Optimizer stuff
    * Removing trace for now.
    * Added parameters to the rev 3 parameter file and added placeholder for optimization data.
    * First optimization run
    * Refined optimizer.
    * Added force per ampere and force per second to main.py and added force per second to optimizer.py
    * Added print statement and note.
    * New objective function
    * First optimization run and moved the hybrid images into 06_dropped
    * More search data
    * Quick little change.
    * More search data
    * Updated runs to have the correct
    * working on thermal solution
    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
2026-10-26 Rev 3 | Motor design finished. Editing/Bringing up test stand. (#63)
    * Updating armature board BOM
    * Updated procurement for armature and teensySFOC
    * Update cSpell.json
    * References and more code.
    * Moving alpha below current work.
    * Breaking into `beta` -> `alpha` -> documentation sections
    * That's a thermodynamics model!?
    * thermals who know!?
    * Saving some changes.
    * More stuff. GN.
    * Few changes. Need to add the parameters for the potting & heat sink for the file.
    * Updated the routing.
    * made it a bit easier to read.
    * Added parameter file for new thermal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
2026-10-28 Modelling finished! (#64)
    * Updating credits.md
    * Improvement to solver.
    * Update solver.py
    * few changes
    * Updating readmes & adding placeholder for firmware
    * More readme updates.
    * Made it 300 m(m) again not 10 m(m)
    * Fourier Law
    * putting work in progress in mathematical implementation
    * Expanded the rayleigh correctly to rayleigh_elenbass
    * Made a line resistance script.
    * Its a start for natural convection & heat transfer
    * Here is another section done.
    * Removing em-dashes.
    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
